AnishLanka/BrainStimulation/boards/Boost/kicad/Pyth_Work/Drill_Report.txt

Drill report for Boost_Electrical_Draft.kicad_pcb
Created on 2026-10-17T14:53:58

Copper Layer Stackup:
    =============================================================
    L1 :  F.Cu                      front
    L2 :  B.Cu                      back

Drill file 'Boost_Electrical_Draft-PTH.drl' contains
    plated through holes:
    =============================================================
    T1  0.300mm  0.0118"  (27 holes))
    T2  1.020mm  0.0402"  (4 holes))
    T3  1.200mm  0.0472"  (2 holes))

    Total plated holes count 33

Drill file 'Boost_Electrical_Draft-NPTH.drl' contains
    unplated through holes:
    =============================================================

    Total unplated holes count 0
