AnishLanka/BrainStimulation/boards/Buck_Boost/kicad/Pyth_Work/SYSTEM_REQUIREMENTS_REVIEW.md

# Effect of the pasted four-channel requirements

The pasted discussion is background and a list of system requirements; its earlier assurances are not evidence that the actual schematics work. Only the buck-boost design has been inspected and revised in this task. No signal-generator, Howland-pump or isolation-board design is approved by these checks.

**Conclusion:** the requirements do not, by themselves, establish a necessary change to the TPS63001 circuit. They also do not establish that this board can power the complete system. Rev B is a corrected prototype 3.3 V supply whose load capability still needs bench verification.

## What this board provides

Rev B converts the specified 2.8–3.7 V battery input to 3.3 V. Its input and output share GND, so it provides no galvanic isolation. The waveform, high-voltage rails, independent channels, output-current/voltage limits, amplitude ramps, phone interface and electrode-disconnect sensing must be implemented elsewhere.

One common 3.3 V supply can feed the input sides of four separate isolation barriers. Each barrier's output domain must stay separate, including its power, control, sensing and external wiring, for channel-to-channel isolation to be retained. This requires review of the actual connected system.

## Required power budget

The original statement that the system needs “more than 200 mA” specifies a minimum expectation, not its actual maximum load. Four electrode outputs at 5 mA each do not imply only 20 mA drawn from the 3.3 V supply.

For the stated simultaneous 30 V peak and 5 mA peak into resistive loads:

- Sinusoidal output power per channel is Vpeak × Ipeak / 2 = 0.075 W; four channels total **0.30 W**.
- Waveforms that remain near maximum magnitude for most of a period can approach **0.60 W** across four channels.
- A 3.3 V, 200 mA rail supplies **0.66 W**. Converter losses, amplifier quiescent power, controller consumption and other loads must be added. These ideal output-power examples are not an estimate of total system consumption.

TI lists up to 800 mA at 3.3 V in boost mode for input above 2.4 V, and 1.2 A in buck mode at 3.6–5.5 V input. These are IC/application capabilities, not measured ratings for Rev B. The 1.8 A figure is a switch-current limit and must not be treated as available output current. Startup into a heavy downstream load also needs testing. See the [TI datasheet](https://www.ti.com/lit/ds/symlink/tps63001.pdf).

To establish adequacy, identify whether one board powers all four channels, the exact downstream converters and their input range, total continuous/peak/inrush current at 3.3 V, and the battery's usable energy. Battery runtime follows usable battery energy divided by measured average battery power; neither one hour nor sixteen hours can be established from electrode current alone.

## Requirement needing a precise interpretation

The 0.1 mA/s change limit is consistent with a limit on the waveform's **amplitude envelope**: increasing from zero to 5 mA takes at least **50 seconds**, and an ordinary controlled ramp down takes the same time. It cannot mean the instantaneous derivative of the AC waveform. For example, a 5 mA-peak, 30 kHz sine has a maximum instantaneous slope of about 942,478 mA/s. Define the amplitude-envelope interpretation explicitly, and specify how fault shutdown differs from a normal user-requested ramp down.

## What is still needed to assess the complete device

The actual signal-generator and Howland schematics/PCBs, exact isolated supplies and their interconnection diagram, intended load/impedance range, output-voltage/current limiting and monitoring circuits, controller interfaces, and the power budget are required. The pasted product descriptions cannot establish component pin connections, analog gain/stability or isolation integrity.

Use the revised supply first with bench equipment and dummy loads. Its clean electrical and manufacturing checks do not validate a human-connected stimulation system.
