AnishLanka/BrainStimulation/boards/Rail_Splitter/kicad/Anish_Work/Drill_Report.txt

Drill report for RailSplitter_Electrical_Draft.kicad_pcb
Created on 2026-10-17T14:51:27

Copper Layer Stackup:
    =============================================================
    L1 :  F.Cu                      front
    L2 :  B.Cu                      back

Drill file 'RailSplitter_Electrical_Draft-PTH.drl' contains
    plated through holes:
    =============================================================
    T1  0.300mm  0.0118"  (12 holes))
    T2  1.300mm  0.0512"  (3 holes))
    T3  1.500mm  0.0591"  (2 holes))

    Total plated holes count 17

Drill file 'RailSplitter_Electrical_Draft-NPTH.drl' contains
    unplated through holes:
    =============================================================

    Total unplated holes count 0
