AnishLanka/BrainStimulation/firmware/ESP32_S3_Brainstim_FW/docs/dds_upgrade.md

# Phase 1 firmware upgrade

The earlier controller-only notes are superseded by [the cross-project Phase 1 implementation and handoff](phase1.md), including sample timing, the versioned status protocol, hardware assumptions and validation results.
