AnishLanka/BrainStimulation/boards/Rail_Splitter/kicad/Anish_Work/RailSplitter_Electrical_Draft.pdf

1 | 2 | 3 | 4 | 5 | 6

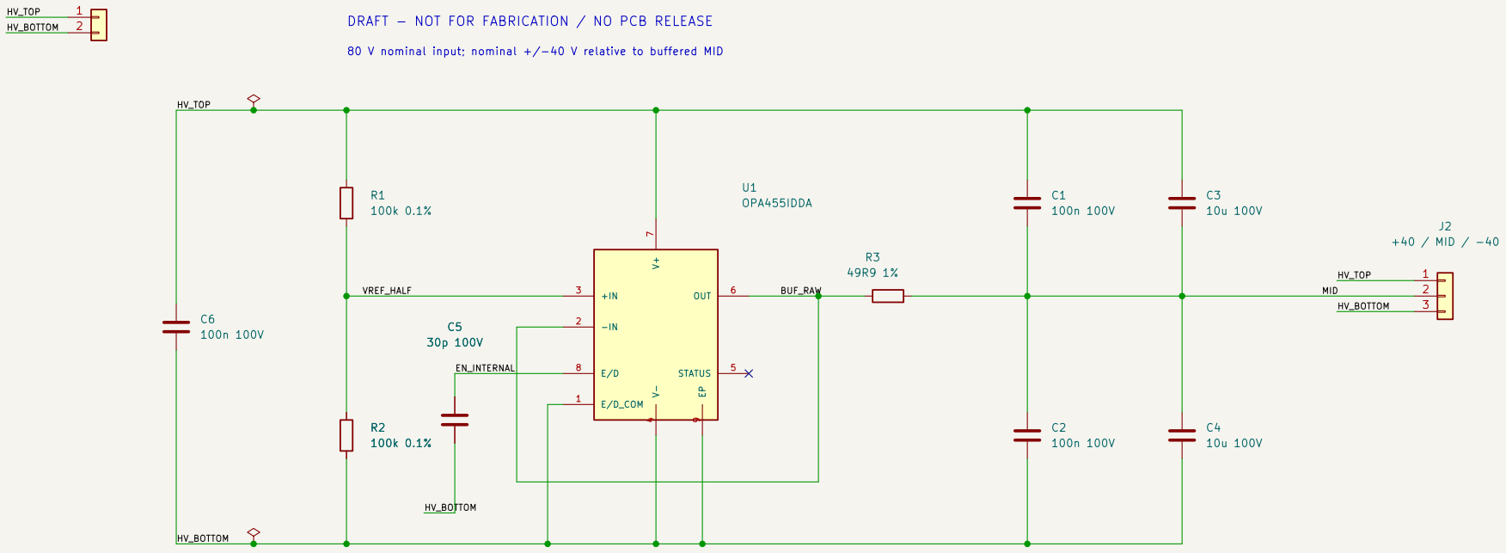
[picture p19: figure]
E/D_COM 1; STATUS; 5 OUT; 9 U1OPA455IDDA C5; J2 +40 / MID / -40 C3 10u 100V; HV_BOTTOM; VREF_HALF HV_TOP; EN_INTERNAL HV_TOP

1 | 2 | 3 | 4 | 5 | 6

AB

C

D

AB

C

## D Date: 2026-10-17

Size: A4 | Rev: DRAFT 1
KiCad E.D.A. 10.0.6 | Id: 1/1

# Title: OPA455 buffered midpoint - electrical draft

## File: RailSplitter_Electrical_Draft.kicad_sch

## Sheet: /

## NOT FOR FABRICATION; stability and system power unvalidated

J1

### 80 V INPUT

BUF_RAW | MIDHV_TOP HV_BOTTOM R1/R2: 16 mW each at 80 V; 32 mW total. Divider tolerance alone: +/-40 mV at MID. Assume one channel, +/-5 mA midpoint imbalance for initial evaluation. This is not a validated load limit.

80 V nominal input; nominal +/-40 V relative to buffered MID

R3 is provisional. Feedback is BEFORE R3. 5 mA DC imbalance causes about 0.25 V midpoint shift. C3/C4 are nominal 10u; verify bias-dependent capacitance.

# OPA455 RAIL SPLITTER - ELECTRICAL DRAFT

## DRAFT - NOT FOR FABRICATION / NO PCB RELEASE

### J1.2 = GAPTEC pin 5 = boost GND = Howland -40 V J2.2 = signal ISO_GND = Howland GND

Do not join MID to HV_BOTTOM. Each channel stays isolated. C5 filters the internal E/D pullup; E/D_COM ties to HV_BOTTOM. STATUS is intentionally unused. EP pin 9 must solder to HV_BOTTOM. C6 must be directly beside U1 supply pins on the eventual PCB. | Required before release: loop/step-load validation, startup and

shutdown, load imbalance and thermal tests, protection, exact BOM, PCB isolation/layout review. ERC success does not validate stability. R2
