AnishLanka/BrainStimulation/boards/Boost/kicad/Pyth_Work/Boost_PCB_Bottom.png

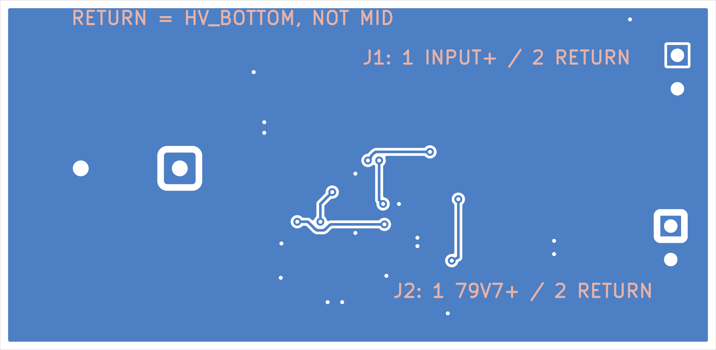
boards/Boost/kicad/Pyth_Work/Boost_PCB_Bottom.png
