AnishLanka/BrainStimulation/boards/Boost/kicad/Pyth_Work/Boost_PCB_Top.png

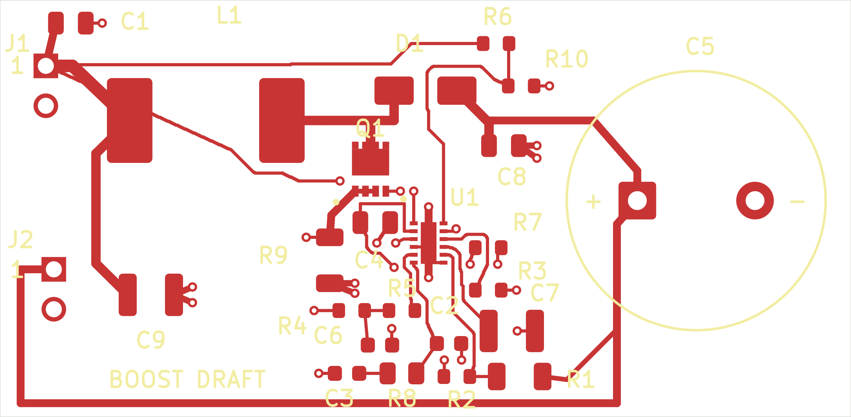
boards/Boost/kicad/Pyth_Work/Boost_PCB_Top.png
