AnishLanka/BrainStimulation/boards/Buck_Boost/kicad/Pyth_Work/previews/bottom-copper.png

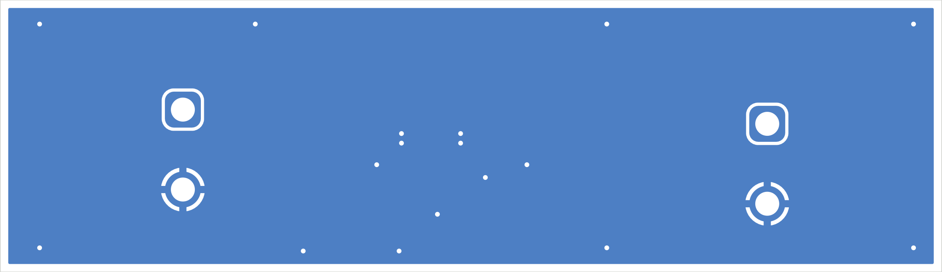
boards/Buck_Boost/kicad/Pyth_Work/previews/bottom-copper.png
