AnishLanka/BrainStimulation/boards/Buck_Boost/kicad/Pyth_Work/previews/BuckBoost_RevB.png

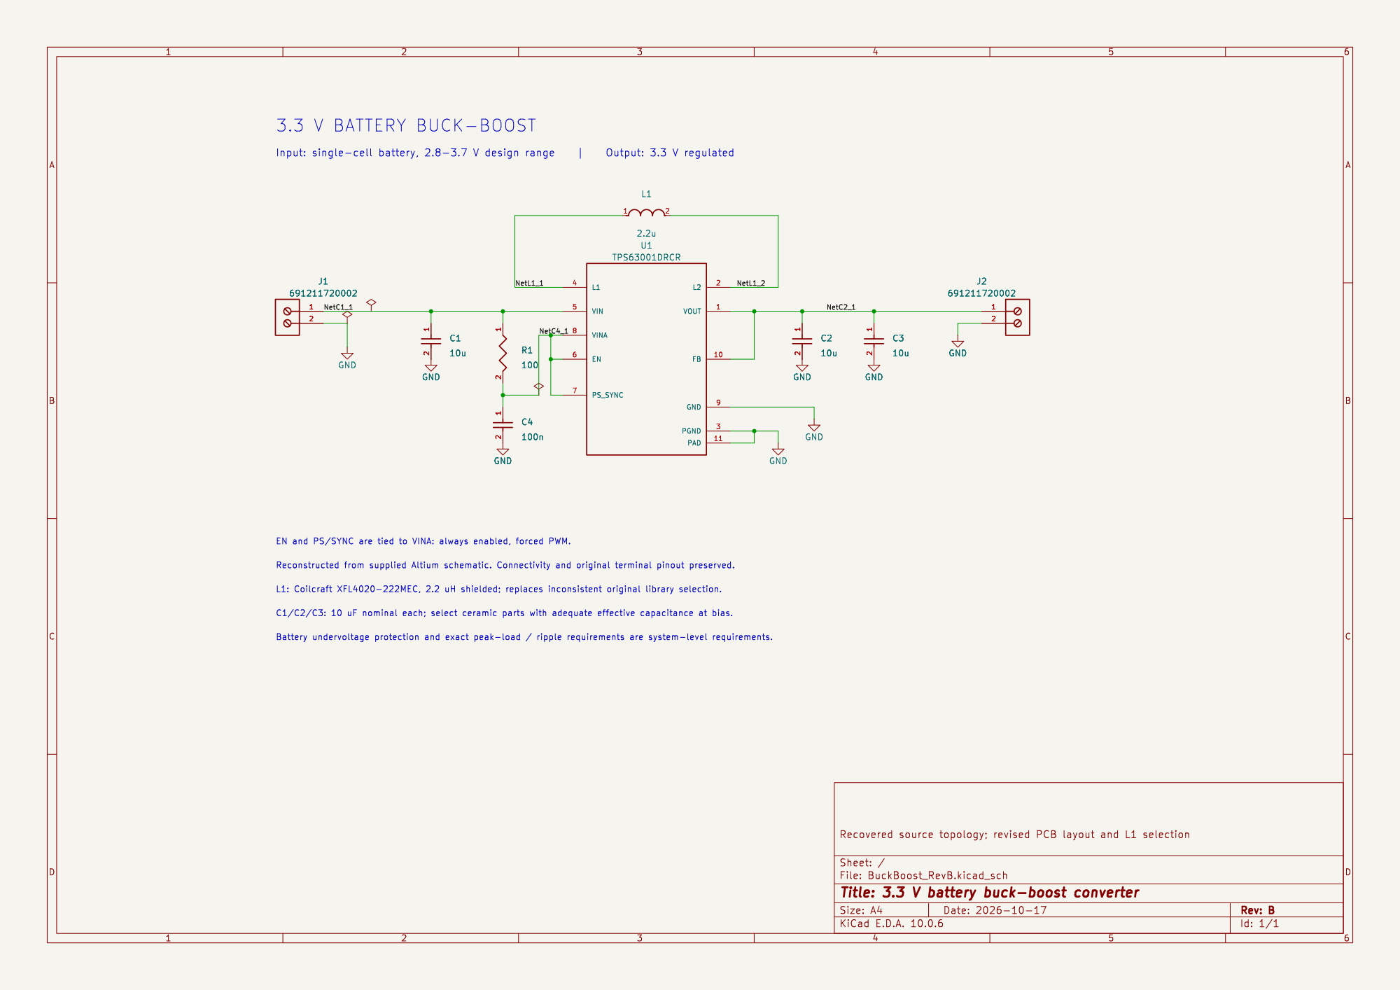
boards/Buck_Boost/kicad/Pyth_Work/previews/BuckBoost_RevB.png
