AnishLanka/BrainStimulation/boards/Buck_Boost/kicad/Pyth_Work/previews/top-copper.png

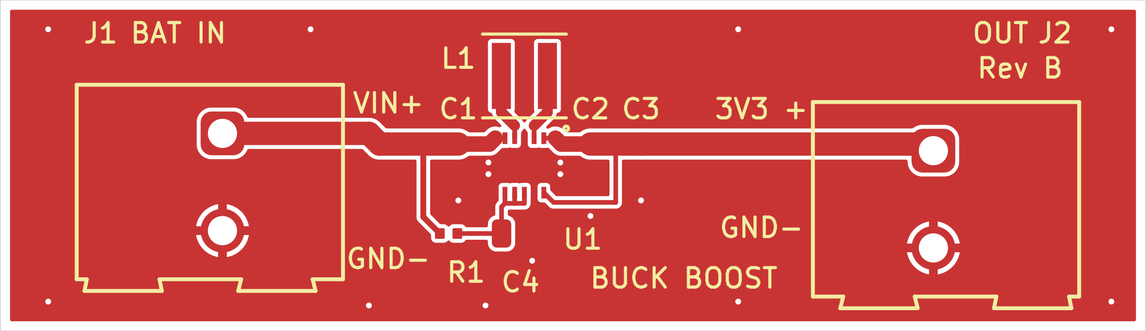
boards/Buck_Boost/kicad/Pyth_Work/previews/top-copper.png
