AnishLanka/BrainStimulation/boards/Rail_Splitter/kicad/Anish_Work/RailSplitter_PCB_Bottom.png

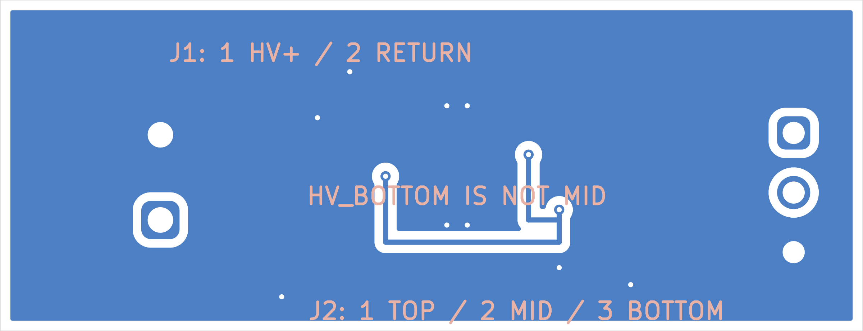
boards/Rail_Splitter/kicad/Anish_Work/RailSplitter_PCB_Bottom.png
