AnishLanka/BrainStimulation/boards/Rail_Splitter/kicad/Anish_Work/RailSplitter_PCB_Top.png

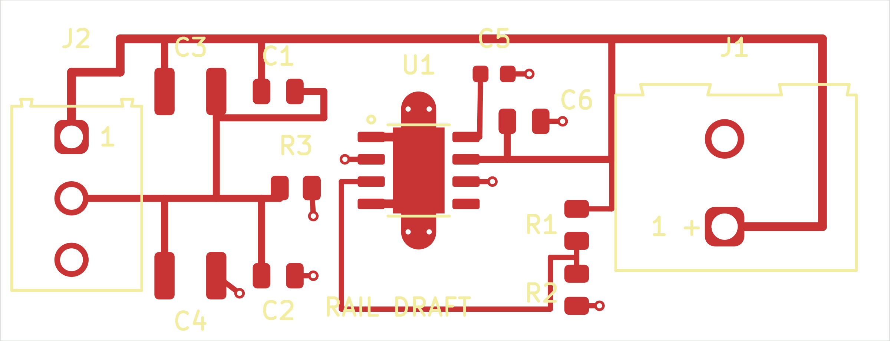
boards/Rail_Splitter/kicad/Anish_Work/RailSplitter_PCB_Top.png
