AnishLanka/BrainStimulation/boards/Shared/Monitor_Power_C1/kicad/Peter_Work/preview/Monitor_Power_C1.png

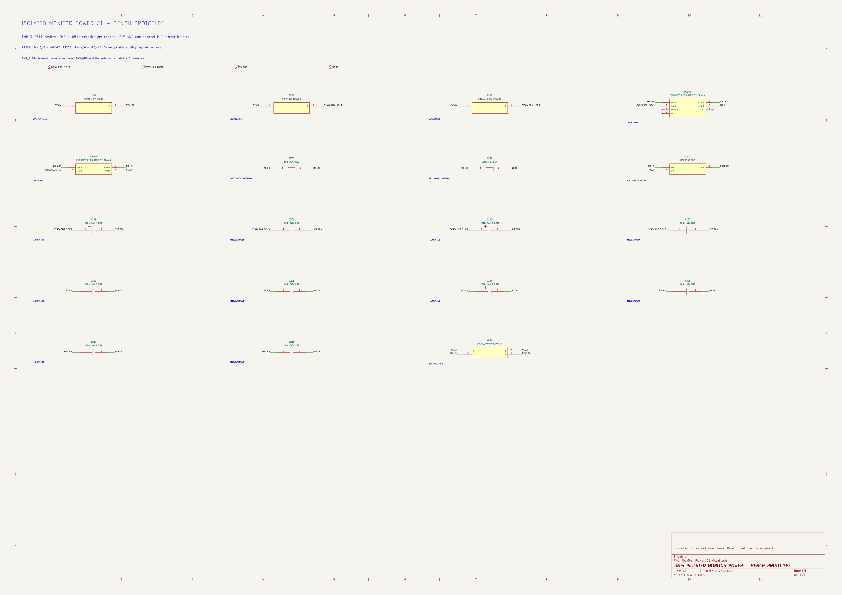
boards/Shared/Monitor_Power_C1/kicad/Peter_Work/preview/Monitor_Power_C1.png
