AnishLanka/BrainStimulation/boards/Shared/Monitor_Power_C1/kicad/Peter_Work/preview/PCB_Bottom.png

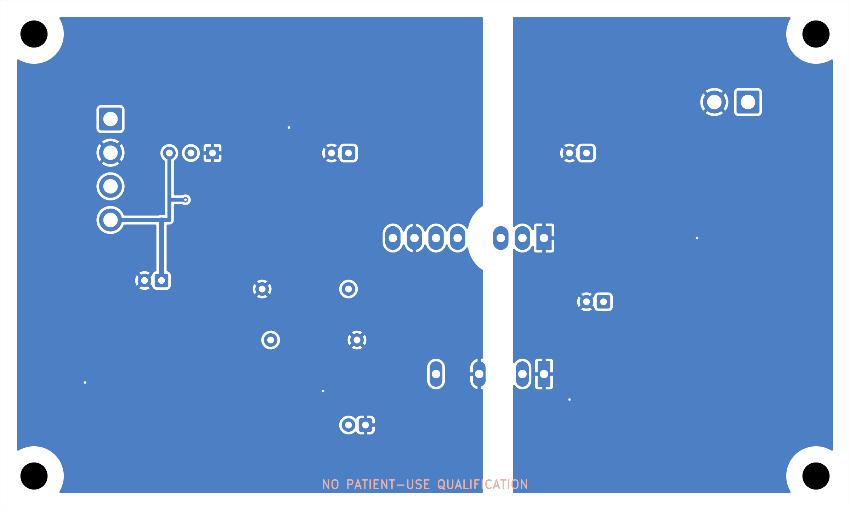
boards/Shared/Monitor_Power_C1/kicad/Peter_Work/preview/PCB_Bottom.png
