AnishLanka/BrainStimulation/boards/Shared/Shared_Power_RevC/kicad/Peter_Work/PCB_Bottom.png

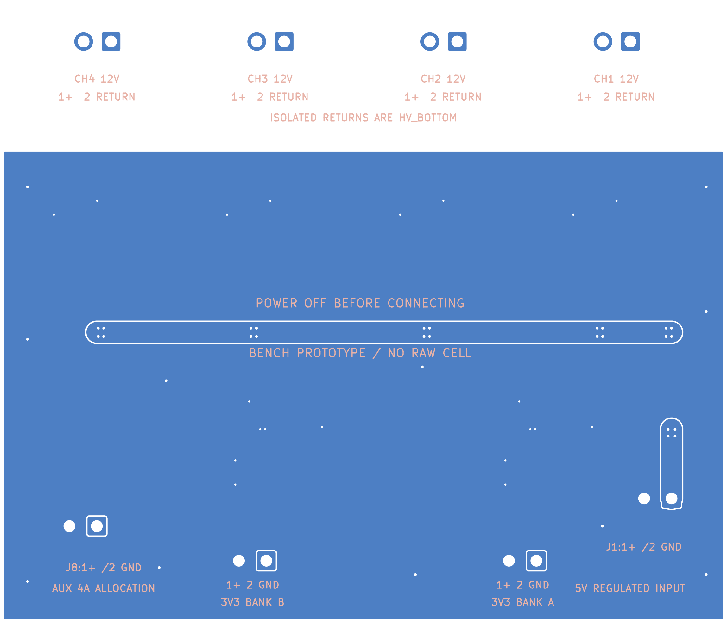
boards/Shared/Shared_Power_RevC/kicad/Peter_Work/PCB_Bottom.png
