AnishLanka/BrainStimulation/boards/Shared/Shared_Power_RevC/kicad/Peter_Work/PCB_Top.png

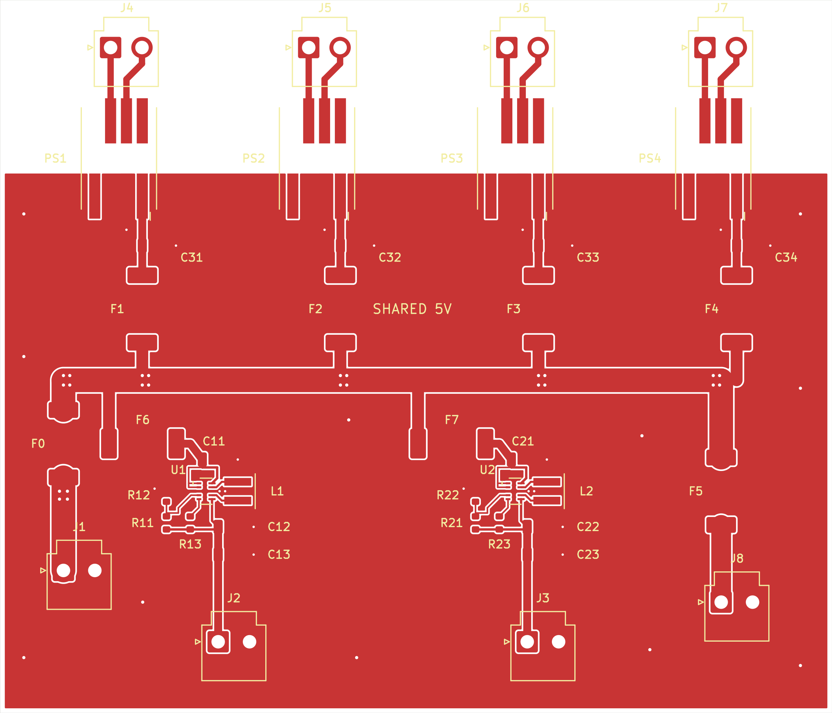
boards/Shared/Shared_Power_RevC/kicad/Peter_Work/PCB_Top.png
