AnishLanka/BrainStimulation/boards/Signal_Generator/kicad/Peter_Work/preview/PCB_back.png

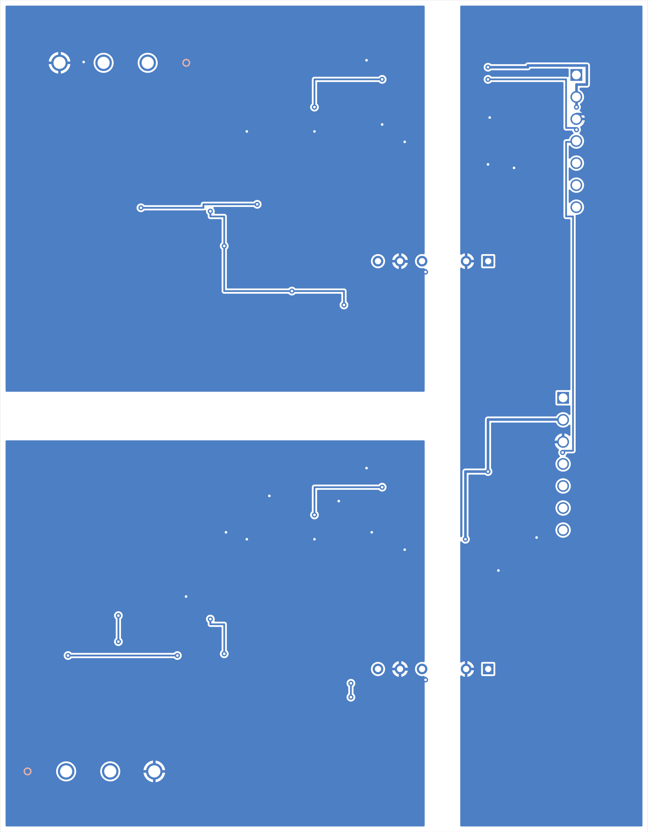
boards/Signal_Generator/kicad/Peter_Work/preview/PCB_back.png
