AnishLanka/BrainStimulation/boards/Signal_Generator/kicad/Peter_Work/preview/PCB_front.png

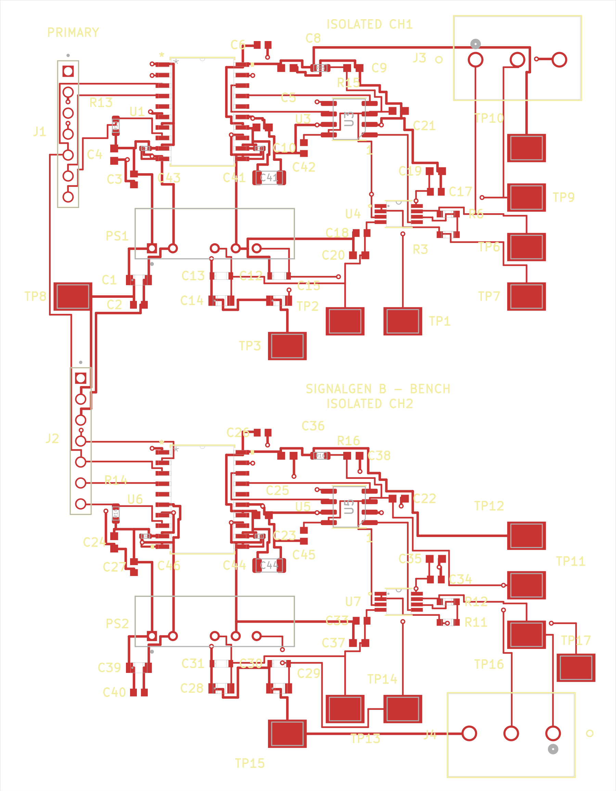
boards/Signal_Generator/kicad/Peter_Work/preview/PCB_front.png
