AnishLanka/BrainStimulation/boards/Signal_Generator/kicad/Peter_Work/preview/SignalGen_Electrical_Draft.png

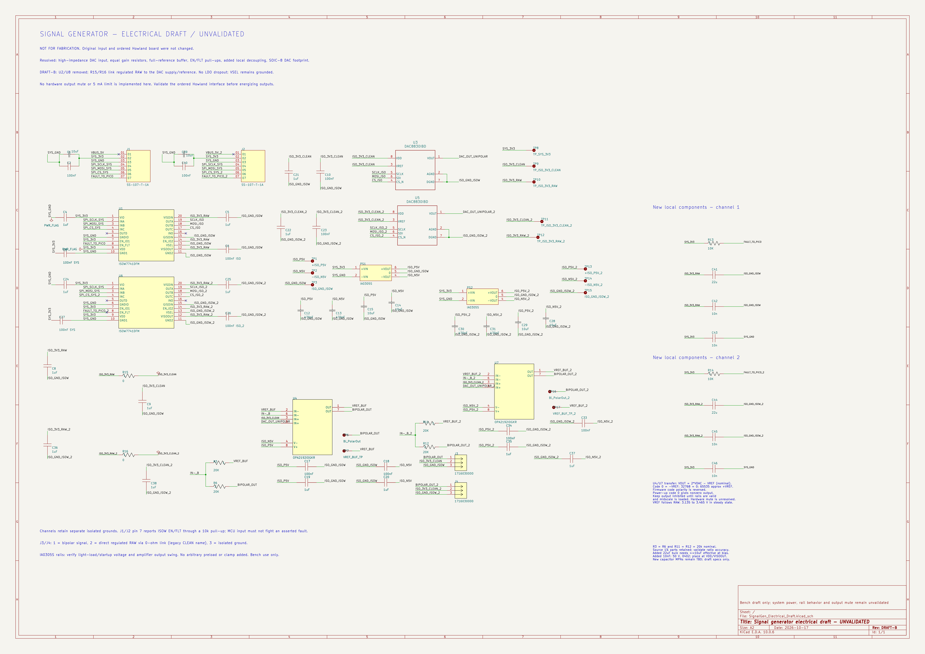
boards/Signal_Generator/kicad/Peter_Work/preview/SignalGen_Electrical_Draft.png
