AnishLanka/BrainStimulation/boards/Boost/Boost_FINAL_ASSEMBLY_BOM.csv

Board | Reference | Function_Name | Value | Footprint | Manufacturer | MPN | Rating | Dielectric | Description | Datasheet | Selection_Status
Boost | R1 | RFBT | 787k 0.1% | BoostDraft:R1206 | Vishay | TNPW1206787KBEEA | 1206; 200V working; at least 0.25W; 0.1%;25ppm/K |  | Upper feedback;78.7V nominal stress;79.7V nominal output | https://www.vishay.com/docs/28758/tnpw_e3.pdf | Retained existing exact MPN; earlier design qualification notes remain applicable
Boost | R2 | RFBB | 10k 0.1% | BoostDraft:R0603 | Vishay | TNPW060310K0BEEA | 0603;100V working;at least0.1W;0.1%;25ppm/K |  | Lower feedback;79.7V nominal setpoint | https://www.vishay.com/docs/28758/tnpw_e3.pdf | Retained existing exact MPN; earlier design qualification notes remain applicable
Boost | C1 | CIN | 10u 50V | BoostDraft:C0805 | TDK | C2012X5R1H106K125AC | 0805;10uF10%;50V;-55 to85C | X5R | Input ceramic; effective4.7uF at16V is a bench acceptance target, not a verified manufacturer minimum | https://product.tdk.com/en/search/capacitor/ceramic/mlcc/info?part_no=C2012X5R1H106K125AC | Retained existing exact MPN; earlier design qualification notes remain applicable
Boost | R3 | RT | 54.9k 1% | BoostDraft:R0603 | Vishay | CRCW060354K9FKEA | 0603;1%;100ppm/K;0.1W;75V |  | Frequency395.67kHz nominal | https://www.vishay.com/docs/20035/dcrcwe3.pdf | Retained existing exact MPN; earlier design qualification notes remain applicable
Boost | Q1 | Q1 | FDMC86240 | BoostDraft:Q_FDMC86240_CASE511DH | onsemi | FDMC86240 | 150V;RDS(on) 70mohm max at VGS 6V; WDFN-8 CASE511DH |  | S1/2/3,G4,D5/6/7/8; verified CASE511DH copper lands; EP common with D | https://www.onsemi.com/download/data-sheet/pdf/fdmc86240-d.pdf | Retained existing exact MPN; earlier design qualification notes remain applicable
Boost | R4 | RFILT | 100R 1% | BoostDraft:R0603 | Vishay | CRCW0603100RFKEA | 0603;1%;100ppm/K;0.1W;75V |  | Current-sense filter;10ns with100pF | https://www.vishay.com/docs/20035/dcrcwe3.pdf | Retained existing exact MPN; earlier design qualification notes remain applicable
Boost | R5 | RSL | 909R 1% | BoostDraft:R0603 | Vishay | CRCW0603909RFKEA | 0603;1%;100ppm/K;0.1W;75V |  | Extra slope compensation; total sense series1009ohm including R4 | https://www.vishay.com/docs/20035/dcrcwe3.pdf | Retained existing exact MPN; earlier design qualification notes remain applicable
Boost | R6 | RUVT | 110k 1% | BoostDraft:R0603 | Vishay | CRCW0603110KFKEA | 0603;1%;100ppm/K;0.1W;75V |  | UVLO upper; startup 9.174V typ, fall 8.318V typ; minimum regulated input remains 10V | https://www.vishay.com/docs/20035/dcrcwe3.pdf | Retained existing exact MPN; earlier design qualification notes remain applicable
Boost | L1 | LM | 1mH SRR1280-102K | BoostDraft:L_BOURNS | Bourns | SRR1280-102K | 1mH10%;DCR1.7ohm max;Irms0.68A;Isat0.80A typ at25%Ldrop |  |  | https://www.bourns.com/docs/Product-Datasheets/SRR1280.pdf | Retained existing exact MPN; earlier design qualification notes remain applicable
Boost | D1 | D1 | SS120 200V | BoostDraft:D_SMA | Taiwan Semiconductor | SS120 | 200 V; 1 A Schottky; DO-214AC (SMA); current manufacturer ordering code SS120, 7500/reel |  |  | https://services.taiwansemi.com/storage/resources/datasheet/SS120_C2305.pdf | Existing SS120 retained; manufacturer C2305 ordering table resolves suffix question
Boost | R7 | RPG | 24.9k 1% | BoostDraft:R0603 | Vishay | CRCW060324K9FKEA | 0603;1%;100ppm/K;0.1W;75V |  | LOCAL PGOOD pullup to VCC_BOOST; not3.3V logic | https://www.vishay.com/docs/20035/dcrcwe3.pdf | Retained existing exact MPN; earlier design qualification notes remain applicable
Boost | C2 | CHF | 68p 50V | BoostDraft:C0603 | TDK | C1608C0G1H680J080AA | 0603;68pF5%;50V | C0G | Provisional compensation HF pole; verify loop | https://product.tdk.com/en/search/capacitor/ceramic/mlcc/info?part_no=C1608C0G1H680J080AA | Retained existing exact MPN; earlier design qualification notes remain applicable
Boost | C3 | CCOMP | 47n 50V | BoostDraft:C0603 | TDK | C1608X7R1H473K080AA | 0603;47nF10%;50V | X7R | Provisional compensation zero; verify loop | https://product.tdk.com/en/search/capacitor/ceramic/mlcc/info?part_no=C1608X7R1H473K080AA | Retained existing exact MPN; earlier design qualification notes remain applicable
Boost | R8 | RCOMP | 191k 1% | BoostDraft:R0805 | Vishay | CRCW0805191KFKEA | 0805;1%;100ppm/K;0.125W;150V |  | Provisional TypeII compensation;500Hz simplified target; unvalidated | https://www.vishay.com/docs/20035/dcrcwe3.pdf | Retained existing exact MPN; earlier design qualification notes remain applicable
Boost | J2 | OUT | 80V OUTPUT | BoostDraft:OUT_FP-TSW-102-14-G-S-MFG | Samtec | TSW-102-14-G-S | 1x2; 2.54 mm pitch; 0.64 mm square posts; 1.02 mm native holes; -14 lead style; gold contact finish |  | Pin 1 HV_TOP; pin 2 HV_BOTTOM. Exact native source header selected. Unpolarized exposed pins: use labeled insulated bench harness and strain relief; matching cable is a separate assembly item. | https://www.samtec.com/products/tsw-102-14-g-s | Placeholder resolved; exact source MPN with native pad and hole compatibility verified
Boost | J1 | IN | 12V INPUT | BoostDraft:IN_FP-TSW-102-14-G-S-MFG | Samtec | TSW-102-14-G-S | 1x2; 2.54 mm pitch; 0.64 mm square posts; 1.02 mm native holes; -14 lead style; gold contact finish |  | Pin 1 ISO_12V_TO_BOTTOM; pin 2 HV_BOTTOM. Exact native source header selected. Unpolarized exposed pins: use labeled insulated bench harness and strain relief; matching cable is a separate assembly item. | https://www.samtec.com/products/tsw-102-14-g-s | Placeholder resolved; exact source MPN with native pad and hole compatibility verified
Boost | R9 | RS | 0R270 1% | BoostDraft:R1206 | Panasonic | ERJ8BQFR27V | 1206;0.270ohm1%;0.5W at70C;derate above70C |  | Thick-film current-sense resistor; Kelvin routing; parasitic inductance not specified; not an output-current clamp | https://industrial.panasonic.com/cdbs/www-data/pdf/RDN0000/AOA0000C313.pdf | Retained existing exact MPN; earlier design qualification notes remain applicable
Boost | C4 | CVCC | 2.2u 25V | BoostDraft:C0805 | TDK | C2012X7R1E225K125AB | 0805;2.2uF10%;25V | X7R | VCC bypass; effective1uF at6.85V is a bench acceptance target, not a verified manufacturer minimum | https://product.tdk.com/en/search/capacitor/ceramic/mlcc/info?part_no=C2012X7R1E225K125AB | Retained existing exact MPN; earlier design qualification notes remain applicable
Boost | C5 | COUT | 100u 160V | BoostDraft:C_BULK | Panasonic | EEUEE2C101S | 100uF20%;160V;105C;D16mm;H20mm;P7.5mm;lead0.8mm | Aluminum electrolytic | Bulk output;10000h105C;1700mArms100kHz105C;maxbody16.5x22mm;verify actual HF ESR | https://industrial.panasonic.com/cdbs/www-data/pdf/RDF0000/RDF0000C1270.pdf | Retained existing exact MPN; earlier design qualification notes remain applicable
Boost | C6 | CFILT | 100p 50V | BoostDraft:C0603 | TDK | C1608C0G1H101J080AA | 0603;100pF5%;50V | C0G | Current-sense filter | https://product.tdk.com/en/search/capacitor/ceramic/mlcc/info?part_no=C1608C0G1H101J080AA | Retained existing exact MPN; earlier design qualification notes remain applicable
Boost | R10 | RUVB | 21.5k 1% | BoostDraft:R0603 | Vishay | CRCW060321K5FKEA | 0603;1%;100ppm/K;0.1W;75V |  | UVLO lower resistor | https://www.vishay.com/docs/20035/dcrcwe3.pdf | Retained existing exact MPN; earlier design qualification notes remain applicable
Boost | C7 | CSS | 47u 16V | BoostDraft:C1210 | Murata | GRM32ER61C476KE15L | 1210;47uF10%;16V;-55 to85C | X5R | Soft-start;effective33uF over0-1V is a bench acceptance target after tolerance,temp,bias,aging | https://search.murata.co.jp/Ceramy/image/img/A01X/G101/ENG/GRM32ER61C476KE15-01A.pdf | Retained existing exact MPN; earlier design qualification notes remain applicable
Boost | U1 | U1 | LM5155DSSR | BoostDraft:U1_DSS0012B | Texas Instruments | LM5155DSSR |  |  | Nonisolated boost controller; all grounds=HV_BOTTOM | https://www.ti.com/lit/ds/symlink/lm5155.pdf | Retained existing exact MPN; earlier design qualification notes remain applicable
Boost | C8 |  | 100n 250V | BoostDraft:C0805 | TDK | C2012X7T2E104K125AA | 0805;100nF10%;250V | X7T (+22/-33% temp) | HF output bypass; effectiveC at79.7V not guaranteed by nominal rating; verify ripple | https://product.tdk.com/en/search/capacitor/ceramic/mlcc/info?part_no=C2012X7T2E104K125AA | Retained existing exact MPN; earlier design qualification notes remain applicable
Boost | C9 |  | 47u 25V | BoostDraft:C1210 | Taiyo Yuden | MSAST32MAB5476MPNDT1 | 1210;47uF20%;25V;-55 to85C | X5R | Input bulk;effective22uF at16V is a bench acceptance target, not a verified manufacturer minimum | https://ds.yuden.co.jp/TYCOMPAS/ut/detail?pn=MSAST32MAB5476MPNDT1&u=M | Retained existing exact MPN; earlier design qualification notes remain applicable
