AnishLanka/BrainStimulation/boards/Rail_Splitter/RailSplitter_FINAL_ASSEMBLY_BOM.csv

Board | Reference | Function_Name | Value | Footprint | Manufacturer | MPN | Rating | Dielectric | Description | Datasheet | Selection_Status
RailSplitter | J1 |  | 80 V INPUT | RailSplitterLocal:J2 | Wurth Elektronik | 691211720002 | 2 positions; 5.00 mm pitch; 1.50 mm recommended holes; 300 VAC; 10 A; 45-degree wire entry |  | Pin 1 HV_TOP; pin 2 HV_BOTTOM. Exact source connector retained. Screw clamp takes stripped wire; no separate mating plug required. Support thin PCB while tightening. | https://www.we-online.com/components/products/datasheet/691211720002.pdf | Placeholder resolved; value, rating and native footprint compatibility checked against manufacturer documentation
RailSplitter | U1 |  | OPA455IDDA | RailSplitterLocal:OPA455_DDA0008J | Texas Instruments | OPA455IDDA |  |  | Unity-gain midpoint buffer; exposed pad9=HV_BOTTOM | https://www.ti.com/lit/ds/symlink/opa455.pdf | Retained existing exact MPN; earlier design qualification notes remain applicable
RailSplitter | R1 |  | 100k 0.1% | RailSplitterLocal:R0805 | Vishay | TNPW0805100KBEEA | 100 kohm; +/-0.1%; +/-25 ppm/K; 0805; 150 V; use conservative 0.125 W limit |  | Midpoint divider. Same part and preferably same production lot for both positions; individual tolerance does not guarantee matched TCR tracking. | https://www.vishay.com/docs/28758/tnpw_e3.pdf | Placeholder resolved; value, rating and native footprint compatibility checked against manufacturer documentation
RailSplitter | R2 |  | 100k 0.1% | RailSplitterLocal:R0805 | Vishay | TNPW0805100KBEEA | 100 kohm; +/-0.1%; +/-25 ppm/K; 0805; 150 V; use conservative 0.125 W limit |  | Midpoint divider. Same part and preferably same production lot for both positions; individual tolerance does not guarantee matched TCR tracking. | https://www.vishay.com/docs/28758/tnpw_e3.pdf | Placeholder resolved; value, rating and native footprint compatibility checked against manufacturer documentation
RailSplitter | R3 |  | 49R9 1% | RailSplitterLocal:R0805 | Vishay | CRCW080549R9FKEA | 49.9 ohm; +/-1%; +/-100 ppm/K; 0805; 0.125 W standard operation; 150 V |  | Existing output isolation resistor; feedback remains before resistor. Load stability and dissipation require bench verification. | https://www.vishay.com/docs/20035/dcrcwe3.pdf | Placeholder resolved; value, rating and native footprint compatibility checked against manufacturer documentation
RailSplitter | C1 |  | 100n 100V | RailSplitterLocal:C0805 | TDK | C2012X7R2A104K125AA |  | X7R | C6 direct full-bus local bypass; C1/C2 half-rail bypasses |  | Retained existing exact MPN; earlier design qualification notes remain applicable
RailSplitter | C2 |  | 100n 100V | RailSplitterLocal:C0805 | TDK | C2012X7R2A104K125AA |  | X7R | C6 direct full-bus local bypass; C1/C2 half-rail bypasses |  | Retained existing exact MPN; earlier design qualification notes remain applicable
RailSplitter | C6 |  | 100n 100V | RailSplitterLocal:C0805 | TDK | C2012X7R2A104K125AA |  | X7R | C6 direct full-bus local bypass; C1/C2 half-rail bypasses |  | Retained existing exact MPN; earlier design qualification notes remain applicable
RailSplitter | C3 |  | 10u 100V | RailSplitterLocal:C1210 | Murata | GRM32EC72A106KE05K |  | X7S | Nominal value only; DC bias reduces capacitance; verify effective C and availability before release | https://search.murata.co.jp/Ceramy/image/img/A01X/G101/ENG/GRM32EC72A106KE05-01A.pdf | Retained existing exact MPN; earlier design qualification notes remain applicable
RailSplitter | C4 |  | 10u 100V | RailSplitterLocal:C1210 | Murata | GRM32EC72A106KE05K |  | X7S | Nominal value only; DC bias reduces capacitance; verify effective C and availability before release | https://search.murata.co.jp/Ceramy/image/img/A01X/G101/ENG/GRM32EC72A106KE05-01A.pdf | Retained existing exact MPN; earlier design qualification notes remain applicable
RailSplitter | C5 |  | 30p 100V | RailSplitterLocal:C0603 | KEMET | C0603C300J1GACTU | 30 pF; +/-5%; 100 VDC; 0603; -55 to +125 C | C0G | Existing E/D filter; exact 0603 30 pF 100 V selection. No electrical change. | https://content.kemet.com/datasheets/KEM_C1003_C0G_SMD.pdf | Placeholder resolved; value, rating and native footprint compatibility checked against manufacturer documentation
RailSplitter | J2 |  | +40 / MID / -40 | RailSplitterLocal:J3 | Wurth Elektronik | 691214110003 | 3 positions; 3.50 mm pitch; 1.30 mm recommended holes; 300 VAC; 10 A; horizontal wire entry |  | Pin 1 HV_TOP; pin 2 MID; pin 3 HV_BOTTOM. Exact source connector retained. Screw clamp takes stripped wire; no separate mating plug required. Support thin PCB while tightening. | https://www.we-online.com/components/products/datasheet/691214110003.pdf | Placeholder resolved; value, rating and native footprint compatibility checked against manufacturer documentation
