AnishLanka/BrainStimulation/boards/Shared/Channel_Monitor_C1/kicad/Peter_Work/Assembly_BOM.csv

Reference | Value | MPN | Manufacturer | Footprint | Population | Notes | Primary_sources
U1 | OPA2192 | OPA2192ID |  | Package_SO:SOIC-8_3.9x4.9mm_P1.27mm | Fit | Dual regulated +/-5 V supply. A buffers protected load return; B buffers half-reference. Input protection is specified for bounded +/-80 V fault injection, not arbitrary surges.
U2 | OPA2192 | OPA2192ID |  | Package_SO:SOIC-8_3.9x4.9mm_P1.27mm | Fit | Single 5 V supply. A current difference gain3.24; B voltage difference gain1/20.
U3 | REF5040A | REF5040AID |  | Package_SO:SOIC-8_3.9x4.9mm_P1.27mm | Fit | Standard grade0.1%,8ppm/C. Pins1/8DNC;3TEMP unused;7NC.
U4 | TLV1704 | TLV1704IPWR |  | Package_SO:TSSOP-14_4.4x5mm_P0.65mm | Fit | All four open-collector outputs wired together. Each comparator is high-impedance in its acceptable window.
U5 | SN74LVC1G74 | SN74LVC1G74DCUR |  | Package_SO:VSSOP-8_2.3x2mm_P0.5mm | Fit | Pin 5 Q, pin 3 inverted Q. D samples qualified near-zero command at rising ARM_EDGE only. Conditioned asynchronous clear is FAULT_CLEAR_N. Hold ARM low through faults; allow at least 1 us after clear recovery before a new rising edge. No automatic rearm.
U6 | TPS3808G33 | TPS3808G33DBVR |  | Package_TO_SOT_SMD:SOT-23-6 | Fit | 3.3V supervisor3.07Vnom; CTopen20msreset release.
U7 | TPS3808G50 | TPS3808G50DBVR |  | Package_TO_SOT_SMD:SOT-23-6 | Fit | Monitors+5V at4.65Vnom; powered3.3V. CTopen20ms.
U8 | TLV1702 | TLV1702IDGKR |  | Package_SO:VSSOP-8_3x3mm_P0.65mm | Fit | Negative rail window approximate-5.503V to-4.671V. Precision tolerances/offset must be included in regulator choice.
U9 | TPS3808G01 | TPS3808G01DBVR |  | Package_TO_SOT_SMD:SOT-23-6 | Fit | Reference undervoltage nominal3.997V; CTopen20ms. Does not detect reference overvoltage.
U10 | TPS3431 | TPS3431SDRBR |  | Package_DFN_QFN:Texas_DRB0008A | Fit | WDO and ENOUT wired together. SET1high,CWD10ktoVDD ->170/200/230ms. EPpin9 is schematic convention; verify package pad geometry.
R1 | 100R 0.1% | TNPW1206100RBEEA | Vishay | Resistor_SMD:R_1206_3216Metric | Fit | Manufacturer resistance code uses R/K/M decimal notation; B=0.1%, E=25 ppm/K, EA=tape packaging. Electrical value and footprint unchanged. TNPW0805 0.1%/25 ppm range includes 499 kohm (up to 1 Mohm). | https://www.vishay.com/docs/28758/tnpw_e3.pdf
R2 | 20k | TNPW080520K0BEEA | Vishay | Resistor_SMD:R_0805_2012Metric | Fit | Manufacturer resistance code uses R/K/M decimal notation; B=0.1%, E=25 ppm/K, EA=tape packaging. Electrical value and footprint unchanged. TNPW0805 0.1%/25 ppm range includes 499 kohm (up to 1 Mohm). | https://www.vishay.com/docs/28758/tnpw_e3.pdf
R3 | 20k | TNPW080520K0BEEA | Vishay | Resistor_SMD:R_0805_2012Metric | Fit | Manufacturer resistance code uses R/K/M decimal notation; B=0.1%, E=25 ppm/K, EA=tape packaging. Electrical value and footprint unchanged. TNPW0805 0.1%/25 ppm range includes 499 kohm (up to 1 Mohm). | https://www.vishay.com/docs/28758/tnpw_e3.pdf
R4 | 10k | TNPW080510K0BEEA | Vishay | Resistor_SMD:R_0805_2012Metric | Fit | Manufacturer resistance code uses R/K/M decimal notation; B=0.1%, E=25 ppm/K, EA=tape packaging. Electrical value and footprint unchanged. TNPW0805 0.1%/25 ppm range includes 499 kohm (up to 1 Mohm). | https://www.vishay.com/docs/28758/tnpw_e3.pdf
R5 | 32.4k | TNPW080532K4BEEA | Vishay | Resistor_SMD:R_0805_2012Metric | Fit | Manufacturer resistance code uses R/K/M decimal notation; B=0.1%, E=25 ppm/K, EA=tape packaging. Electrical value and footprint unchanged. TNPW0805 0.1%/25 ppm range includes 499 kohm (up to 1 Mohm). | https://www.vishay.com/docs/28758/tnpw_e3.pdf
R6 | 10k | TNPW080510K0BEEA | Vishay | Resistor_SMD:R_0805_2012Metric | Fit | Manufacturer resistance code uses R/K/M decimal notation; B=0.1%, E=25 ppm/K, EA=tape packaging. Electrical value and footprint unchanged. TNPW0805 0.1%/25 ppm range includes 499 kohm (up to 1 Mohm). | https://www.vishay.com/docs/28758/tnpw_e3.pdf
R7 | 32.4k | TNPW080532K4BEEA | Vishay | Resistor_SMD:R_0805_2012Metric | Fit | Manufacturer resistance code uses R/K/M decimal notation; B=0.1%, E=25 ppm/K, EA=tape packaging. Electrical value and footprint unchanged. TNPW0805 0.1%/25 ppm range includes 499 kohm (up to 1 Mohm). | https://www.vishay.com/docs/28758/tnpw_e3.pdf
R8 | 499k | TNPW0805499KBEEA | Vishay | Resistor_SMD:R_0805_2012Metric | Fit | Manufacturer resistance code uses R/K/M decimal notation; B=0.1%, E=25 ppm/K, EA=tape packaging. Electrical value and footprint unchanged. TNPW0805 0.1%/25 ppm range includes 499 kohm (up to 1 Mohm). | https://www.vishay.com/docs/28758/tnpw_e3.pdf
R9 | 499k | TNPW0805499KBEEA | Vishay | Resistor_SMD:R_0805_2012Metric | Fit | Manufacturer resistance code uses R/K/M decimal notation; B=0.1%, E=25 ppm/K, EA=tape packaging. Electrical value and footprint unchanged. TNPW0805 0.1%/25 ppm range includes 499 kohm (up to 1 Mohm). | https://www.vishay.com/docs/28758/tnpw_e3.pdf
R10 | 49.9k | TNPW080549K9BEEA | Vishay | Resistor_SMD:R_0805_2012Metric | Fit | Manufacturer resistance code uses R/K/M decimal notation; B=0.1%, E=25 ppm/K, EA=tape packaging. Electrical value and footprint unchanged. TNPW0805 0.1%/25 ppm range includes 499 kohm (up to 1 Mohm). | https://www.vishay.com/docs/28758/tnpw_e3.pdf
R11 | 499k | TNPW0805499KBEEA | Vishay | Resistor_SMD:R_0805_2012Metric | Fit | Manufacturer resistance code uses R/K/M decimal notation; B=0.1%, E=25 ppm/K, EA=tape packaging. Electrical value and footprint unchanged. TNPW0805 0.1%/25 ppm range includes 499 kohm (up to 1 Mohm). | https://www.vishay.com/docs/28758/tnpw_e3.pdf
R12 | 499k | TNPW0805499KBEEA | Vishay | Resistor_SMD:R_0805_2012Metric | Fit | Manufacturer resistance code uses R/K/M decimal notation; B=0.1%, E=25 ppm/K, EA=tape packaging. Electrical value and footprint unchanged. TNPW0805 0.1%/25 ppm range includes 499 kohm (up to 1 Mohm). | https://www.vishay.com/docs/28758/tnpw_e3.pdf
R13 | 49.9k | TNPW080549K9BEEA | Vishay | Resistor_SMD:R_0805_2012Metric | Fit | Manufacturer resistance code uses R/K/M decimal notation; B=0.1%, E=25 ppm/K, EA=tape packaging. Electrical value and footprint unchanged. TNPW0805 0.1%/25 ppm range includes 499 kohm (up to 1 Mohm). | https://www.vishay.com/docs/28758/tnpw_e3.pdf
R14 | 5.11k | TNPW08055K11BEEA | Vishay | Resistor_SMD:R_0805_2012Metric | Fit | Manufacturer resistance code uses R/K/M decimal notation; B=0.1%, E=25 ppm/K, EA=tape packaging. Electrical value and footprint unchanged. TNPW0805 0.1%/25 ppm range includes 499 kohm (up to 1 Mohm). | https://www.vishay.com/docs/28758/tnpw_e3.pdf
R15 | 93.1k | TNPW080593K1BEEA | Vishay | Resistor_SMD:R_0805_2012Metric | Fit | Manufacturer resistance code uses R/K/M decimal notation; B=0.1%, E=25 ppm/K, EA=tape packaging. Electrical value and footprint unchanged. TNPW0805 0.1%/25 ppm range includes 499 kohm (up to 1 Mohm). | https://www.vishay.com/docs/28758/tnpw_e3.pdf
R16 | 5.11k | TNPW08055K11BEEA | Vishay | Resistor_SMD:R_0805_2012Metric | Fit | Manufacturer resistance code uses R/K/M decimal notation; B=0.1%, E=25 ppm/K, EA=tape packaging. Electrical value and footprint unchanged. TNPW0805 0.1%/25 ppm range includes 499 kohm (up to 1 Mohm). | https://www.vishay.com/docs/28758/tnpw_e3.pdf
R17 | 15.6k | TNPW080515K6BEEA | Vishay | Resistor_SMD:R_0805_2012Metric | Fit | Manufacturer resistance code uses R/K/M decimal notation; B=0.1%, E=25 ppm/K, EA=tape packaging. Electrical value and footprint unchanged. TNPW0805 0.1%/25 ppm range includes 499 kohm (up to 1 Mohm). | https://www.vishay.com/docs/28758/tnpw_e3.pdf
R18 | 71.5k | TNPW080571K5BEEA | Vishay | Resistor_SMD:R_0805_2012Metric | Fit | Manufacturer resistance code uses R/K/M decimal notation; B=0.1%, E=25 ppm/K, EA=tape packaging. Electrical value and footprint unchanged. TNPW0805 0.1%/25 ppm range includes 499 kohm (up to 1 Mohm). | https://www.vishay.com/docs/28758/tnpw_e3.pdf
R19 | 15.6k | TNPW080515K6BEEA | Vishay | Resistor_SMD:R_0805_2012Metric | Fit | Manufacturer resistance code uses R/K/M decimal notation; B=0.1%, E=25 ppm/K, EA=tape packaging. Electrical value and footprint unchanged. TNPW0805 0.1%/25 ppm range includes 499 kohm (up to 1 Mohm). | https://www.vishay.com/docs/28758/tnpw_e3.pdf
R20 | 10k | TNPW080510K0BEEA | Vishay | Resistor_SMD:R_0805_2012Metric | Fit | Manufacturer resistance code uses R/K/M decimal notation; B=0.1%, E=25 ppm/K, EA=tape packaging. Electrical value and footprint unchanged. TNPW0805 0.1%/25 ppm range includes 499 kohm (up to 1 Mohm). | https://www.vishay.com/docs/28758/tnpw_e3.pdf
R21 | 10k | TNPW080510K0BEEA | Vishay | Resistor_SMD:R_0805_2012Metric | Fit | Manufacturer resistance code uses R/K/M decimal notation; B=0.1%, E=25 ppm/K, EA=tape packaging. Electrical value and footprint unchanged. TNPW0805 0.1%/25 ppm range includes 499 kohm (up to 1 Mohm). | https://www.vishay.com/docs/28758/tnpw_e3.pdf
R22 | 10k | TNPW080510K0BEEA | Vishay | Resistor_SMD:R_0805_2012Metric | Fit | Manufacturer resistance code uses R/K/M decimal notation; B=0.1%, E=25 ppm/K, EA=tape packaging. Electrical value and footprint unchanged. TNPW0805 0.1%/25 ppm range includes 499 kohm (up to 1 Mohm). | https://www.vishay.com/docs/28758/tnpw_e3.pdf
R23 | 10k | TNPW080510K0BEEA | Vishay | Resistor_SMD:R_0805_2012Metric | Fit | Manufacturer resistance code uses R/K/M decimal notation; B=0.1%, E=25 ppm/K, EA=tape packaging. Electrical value and footprint unchanged. TNPW0805 0.1%/25 ppm range includes 499 kohm (up to 1 Mohm). | https://www.vishay.com/docs/28758/tnpw_e3.pdf
R24 | 10k | TNPW080510K0BEEA | Vishay | Resistor_SMD:R_0805_2012Metric | Fit | Manufacturer resistance code uses R/K/M decimal notation; B=0.1%, E=25 ppm/K, EA=tape packaging. Electrical value and footprint unchanged. TNPW0805 0.1%/25 ppm range includes 499 kohm (up to 1 Mohm). | https://www.vishay.com/docs/28758/tnpw_e3.pdf
R25 | 1k | TNPW08051K00BEEA | Vishay | Resistor_SMD:R_0805_2012Metric | Fit | Manufacturer resistance code uses R/K/M decimal notation; B=0.1%, E=25 ppm/K, EA=tape packaging. Electrical value and footprint unchanged. TNPW0805 0.1%/25 ppm range includes 499 kohm (up to 1 Mohm). | https://www.vishay.com/docs/28758/tnpw_e3.pdf
R26 | 10k | TNPW080510K0BEEA | Vishay | Resistor_SMD:R_0805_2012Metric | Fit | Manufacturer resistance code uses R/K/M decimal notation; B=0.1%, E=25 ppm/K, EA=tape packaging. Electrical value and footprint unchanged. TNPW0805 0.1%/25 ppm range includes 499 kohm (up to 1 Mohm). | https://www.vishay.com/docs/28758/tnpw_e3.pdf
R27 | 100k | TNPW0805100KBEEA | Vishay | Resistor_SMD:R_0805_2012Metric | Fit | Manufacturer resistance code uses R/K/M decimal notation; B=0.1%, E=25 ppm/K, EA=tape packaging. Electrical value and footprint unchanged. TNPW0805 0.1%/25 ppm range includes 499 kohm (up to 1 Mohm). | https://www.vishay.com/docs/28758/tnpw_e3.pdf
R28 | 200k | TNPW0805200KBEEA | Vishay | Resistor_SMD:R_0805_2012Metric | Fit | Manufacturer resistance code uses R/K/M decimal notation; B=0.1%, E=25 ppm/K, EA=tape packaging. Electrical value and footprint unchanged. TNPW0805 0.1%/25 ppm range includes 499 kohm (up to 1 Mohm). | https://www.vishay.com/docs/28758/tnpw_e3.pdf
R29 | 24.9k | TNPW080524K9BEEA | Vishay | Resistor_SMD:R_0805_2012Metric | Fit | Manufacturer resistance code uses R/K/M decimal notation; B=0.1%, E=25 ppm/K, EA=tape packaging. Electrical value and footprint unchanged. TNPW0805 0.1%/25 ppm range includes 499 kohm (up to 1 Mohm). | https://www.vishay.com/docs/28758/tnpw_e3.pdf
R30 | 10k | TNPW080510K0BEEA | Vishay | Resistor_SMD:R_0805_2012Metric | Fit | Manufacturer resistance code uses R/K/M decimal notation; B=0.1%, E=25 ppm/K, EA=tape packaging. Electrical value and footprint unchanged. TNPW0805 0.1%/25 ppm range includes 499 kohm (up to 1 Mohm). | https://www.vishay.com/docs/28758/tnpw_e3.pdf
R31 | 35.7k | TNPW080535K7BEEA | Vishay | Resistor_SMD:R_0805_2012Metric | Fit | Manufacturer resistance code uses R/K/M decimal notation; B=0.1%, E=25 ppm/K, EA=tape packaging. Electrical value and footprint unchanged. TNPW0805 0.1%/25 ppm range includes 499 kohm (up to 1 Mohm). | https://www.vishay.com/docs/28758/tnpw_e3.pdf
R32 | 10k | TNPW080510K0BEEA | Vishay | Resistor_SMD:R_0805_2012Metric | Fit | Manufacturer resistance code uses R/K/M decimal notation; B=0.1%, E=25 ppm/K, EA=tape packaging. Electrical value and footprint unchanged. TNPW0805 0.1%/25 ppm range includes 499 kohm (up to 1 Mohm). | https://www.vishay.com/docs/28758/tnpw_e3.pdf
R33 | 88.7k | TNPW080588K7BEEA | Vishay | Resistor_SMD:R_0805_2012Metric | Fit | Manufacturer resistance code uses R/K/M decimal notation; B=0.1%, E=25 ppm/K, EA=tape packaging. Electrical value and footprint unchanged. TNPW0805 0.1%/25 ppm range includes 499 kohm (up to 1 Mohm). | https://www.vishay.com/docs/28758/tnpw_e3.pdf
R34 | 10k | TNPW080510K0BEEA | Vishay | Resistor_SMD:R_0805_2012Metric | Fit | Manufacturer resistance code uses R/K/M decimal notation; B=0.1%, E=25 ppm/K, EA=tape packaging. Electrical value and footprint unchanged. TNPW0805 0.1%/25 ppm range includes 499 kohm (up to 1 Mohm). | https://www.vishay.com/docs/28758/tnpw_e3.pdf
R35 | 10k | TNPW080510K0BEEA | Vishay | Resistor_SMD:R_0805_2012Metric | Fit | Manufacturer resistance code uses R/K/M decimal notation; B=0.1%, E=25 ppm/K, EA=tape packaging. Electrical value and footprint unchanged. TNPW0805 0.1%/25 ppm range includes 499 kohm (up to 1 Mohm). | https://www.vishay.com/docs/28758/tnpw_e3.pdf
C1 | 100n | 885012207098 | Wurth Elektronik | Capacitor_SMD:C_0805_2012Metric | Fit | 100 nF, +/-10%, 50 V, X7R, 0805 (2.0 x 1.25 mm). Nominal rating does not constitute a guaranteed biased capacitance. | https://www.we-online.com/components/products/datasheet/885012207098.pdf
C2 | 100n | 885012207098 | Wurth Elektronik | Capacitor_SMD:C_0805_2012Metric | Fit | 100 nF, +/-10%, 50 V, X7R, 0805 (2.0 x 1.25 mm). Nominal rating does not constitute a guaranteed biased capacitance. | https://www.we-online.com/components/products/datasheet/885012207098.pdf
C3 | 100n | 885012207098 | Wurth Elektronik | Capacitor_SMD:C_0805_2012Metric | Fit | 100 nF, +/-10%, 50 V, X7R, 0805 (2.0 x 1.25 mm). Nominal rating does not constitute a guaranteed biased capacitance. | https://www.we-online.com/components/products/datasheet/885012207098.pdf
C4 | 100n | 885012207098 | Wurth Elektronik | Capacitor_SMD:C_0805_2012Metric | Fit | 100 nF, +/-10%, 50 V, X7R, 0805 (2.0 x 1.25 mm). Nominal rating does not constitute a guaranteed biased capacitance. | https://www.we-online.com/components/products/datasheet/885012207098.pdf
C5 | 100n | 885012207098 | Wurth Elektronik | Capacitor_SMD:C_0805_2012Metric | Fit | 100 nF, +/-10%, 50 V, X7R, 0805 (2.0 x 1.25 mm). Nominal rating does not constitute a guaranteed biased capacitance. | https://www.we-online.com/components/products/datasheet/885012207098.pdf
C6 | 100n | 885012207098 | Wurth Elektronik | Capacitor_SMD:C_0805_2012Metric | Fit | 100 nF, +/-10%, 50 V, X7R, 0805 (2.0 x 1.25 mm). Nominal rating does not constitute a guaranteed biased capacitance. | https://www.we-online.com/components/products/datasheet/885012207098.pdf
C7 | 100n | 885012207098 | Wurth Elektronik | Capacitor_SMD:C_0805_2012Metric | Fit | 100 nF, +/-10%, 50 V, X7R, 0805 (2.0 x 1.25 mm). Nominal rating does not constitute a guaranteed biased capacitance. | https://www.we-online.com/components/products/datasheet/885012207098.pdf
C8 | 100n | 885012207098 | Wurth Elektronik | Capacitor_SMD:C_0805_2012Metric | Fit | 100 nF, +/-10%, 50 V, X7R, 0805 (2.0 x 1.25 mm). Nominal rating does not constitute a guaranteed biased capacitance. | https://www.we-online.com/components/products/datasheet/885012207098.pdf
C9 | 100n | 885012207098 | Wurth Elektronik | Capacitor_SMD:C_0805_2012Metric | Fit | 100 nF, +/-10%, 50 V, X7R, 0805 (2.0 x 1.25 mm). Nominal rating does not constitute a guaranteed biased capacitance. | https://www.we-online.com/components/products/datasheet/885012207098.pdf
C10 | 100n | 885012207098 | Wurth Elektronik | Capacitor_SMD:C_0805_2012Metric | Fit | 100 nF, +/-10%, 50 V, X7R, 0805 (2.0 x 1.25 mm). Nominal rating does not constitute a guaranteed biased capacitance. | https://www.we-online.com/components/products/datasheet/885012207098.pdf
C11 | 1u | 885012207078 | Wurth Elektronik | Capacitor_SMD:C_0805_2012Metric | Fit | 1 uF, +/-10%, 25 V, X7R, 0805 (2.0 x 1.25 mm). Nominal rating does not constitute a guaranteed biased capacitance. | https://www.we-online.com/components/products/datasheet/885012207078.pdf
C12 | 1u | 885012207078 | Wurth Elektronik | Capacitor_SMD:C_0805_2012Metric | Fit | 1 uF, +/-10%, 25 V, X7R, 0805 (2.0 x 1.25 mm). Nominal rating does not constitute a guaranteed biased capacitance. | https://www.we-online.com/components/products/datasheet/885012207078.pdf
C13 | 22u 25V X5R | C2012X5R1E226M125AC | TDK | Capacitor_SMD:C_0805_2012Metric | Fit | Increase nominal output capacitance from 10 to 22 uF in the same 0805 footprint. 22 uF +/-20%, 25 V, X5R, 2.0 x 1.25 x 1.25 mm. REF5040A permits 1-50 uF output capacitance; even +20% tolerance and +15% temperature change give 30.36 uF nominal upper estimate. Effective capacitance at 4.096 V is NOT guaranteed here. Manufacturer characterization data are typical; qualify reference noise/transients on the assembled board. X5R rating limits this component to +85 C. No footprint, pad or net change. | https://product.tdk.com/en/search/capacitor/ceramic/mlcc/info?part_no=C2012X5R1E226M125AC | https://www.ti.com/lit/ds/symlink/ref50.pdf
J1 | ISOLATED_LOCAL_POWER | TSW-104-07-G-S | Samtec | Connector_PinHeader_2.54mm:PinHeader_1x04_P2.54mm_Vertical | Fit | 4-position, single-row, straight through-hole, 2.54 mm pitch, 0.635 mm square post. Unshrouded and UNPOLARIZED: pin-1 marking and verified cable mapping are required; this is not a keyed connector. Official layout recommends 1.02 mm finished holes. Standard KiCad footprint has 1.00 mm holes; use 1.02 mm nominal or a documented 1.05 mm production nominal and rerun DRC/parity. Pad centers, copper pad size and routing need not change. Lead style 07: 5.84 mm post, 2.54 mm tail. J4 is optional/unconnected unless an existing documented Howland enable connection is available; do not modify the Howland board. | https://www.samtec.com/products/tsw-104-07-g-s | https://suddendocs.samtec.com/prints/tsw-xxx-xx-x-x-xx-xxx-footprint.pdf | https://suddendocs.samtec.com/prints/tsw-xxx-xx-xxx-x-xx-xxx-mkt.pdf
J2 | HOWLAND_OUTPUT_INPUT | TSW-102-07-G-S | Samtec | Connector_PinHeader_2.54mm:PinHeader_1x02_P2.54mm_Vertical | Fit | 2-position, single-row, straight through-hole, 2.54 mm pitch, 0.635 mm square post. Unshrouded and UNPOLARIZED: pin-1 marking and verified cable mapping are required; this is not a keyed connector. Official layout recommends 1.02 mm finished holes. Standard KiCad footprint has 1.00 mm holes; use 1.02 mm nominal or a documented 1.05 mm production nominal and rerun DRC/parity. Pad centers, copper pad size and routing need not change. Lead style 07: 5.84 mm post, 2.54 mm tail. J4 is optional/unconnected unless an existing documented Howland enable connection is available; do not modify the Howland board. | https://www.samtec.com/products/tsw-102-07-g-s | https://suddendocs.samtec.com/prints/tsw-xxx-xx-x-x-xx-xxx-footprint.pdf | https://suddendocs.samtec.com/prints/tsw-xxx-xx-xxx-x-xx-xxx-mkt.pdf
J3 | ISOLATED_CONTROL | TSW-106-07-G-S | Samtec | Connector_PinHeader_2.54mm:PinHeader_1x06_P2.54mm_Vertical | Fit | 6-position, single-row, straight through-hole, 2.54 mm pitch, 0.635 mm square post. Unshrouded and UNPOLARIZED: pin-1 marking and verified cable mapping are required; this is not a keyed connector. Official layout recommends 1.02 mm finished holes. Standard KiCad footprint has 1.00 mm holes; use 1.02 mm nominal or a documented 1.05 mm production nominal and rerun DRC/parity. Pad centers, copper pad size and routing need not change. Lead style 07: 5.84 mm post, 2.54 mm tail. J4 is optional/unconnected unless an existing documented Howland enable connection is available; do not modify the Howland board. | https://www.samtec.com/products/tsw-106-07-g-s | https://suddendocs.samtec.com/prints/tsw-xxx-xx-x-x-xx-xxx-footprint.pdf | https://suddendocs.samtec.com/prints/tsw-xxx-xx-xxx-x-xx-xxx-mkt.pdf
J4 | HOWLAND_ENABLE | TSW-102-07-G-S | Samtec | Connector_PinHeader_2.54mm:PinHeader_1x02_P2.54mm_Vertical | Fit | 2-position, single-row, straight through-hole, 2.54 mm pitch, 0.635 mm square post. Unshrouded and UNPOLARIZED: pin-1 marking and verified cable mapping are required; this is not a keyed connector. Official layout recommends 1.02 mm finished holes. Standard KiCad footprint has 1.00 mm holes; use 1.02 mm nominal or a documented 1.05 mm production nominal and rerun DRC/parity. Pad centers, copper pad size and routing need not change. Lead style 07: 5.84 mm post, 2.54 mm tail. J4 is optional/unconnected unless an existing documented Howland enable connection is available; do not modify the Howland board. | https://www.samtec.com/products/tsw-102-07-g-s | https://suddendocs.samtec.com/prints/tsw-xxx-xx-x-x-xx-xxx-footprint.pdf | https://suddendocs.samtec.com/prints/tsw-xxx-xx-xxx-x-xx-xxx-mkt.pdf
J5 | SIMULTANEOUS_ADC_MODULE | TSW-107-07-G-S | Samtec | Connector_PinHeader_2.54mm:PinHeader_1x07_P2.54mm_Vertical | Fit | 7-position, single-row, straight through-hole, 2.54 mm pitch, 0.635 mm square post. Unshrouded and UNPOLARIZED: pin-1 marking and verified cable mapping are required; this is not a keyed connector. Official layout recommends 1.02 mm finished holes. Standard KiCad footprint has 1.00 mm holes; use 1.02 mm nominal or a documented 1.05 mm production nominal and rerun DRC/parity. Pad centers, copper pad size and routing need not change. Lead style 07: 5.84 mm post, 2.54 mm tail. J4 is optional/unconnected unless an existing documented Howland enable connection is available; do not modify the Howland board. | https://www.samtec.com/products/tsw-107-07-g-s | https://suddendocs.samtec.com/prints/tsw-xxx-xx-x-x-xx-xxx-footprint.pdf | https://suddendocs.samtec.com/prints/tsw-xxx-xx-xxx-x-xx-xxx-mkt.pdf
J6 | FAULT_STATUS | TSW-103-07-G-S | Samtec | Connector_PinHeader_2.54mm:PinHeader_1x03_P2.54mm_Vertical | Fit | 3-position, single-row, straight through-hole, 2.54 mm pitch, 0.635 mm square post. Unshrouded and UNPOLARIZED: pin-1 marking and verified cable mapping are required; this is not a keyed connector. Official layout recommends 1.02 mm finished holes. Standard KiCad footprint has 1.00 mm holes; use 1.02 mm nominal or a documented 1.05 mm production nominal and rerun DRC/parity. Pad centers, copper pad size and routing need not change. Lead style 07: 5.84 mm post, 2.54 mm tail. J4 is optional/unconnected unless an existing documented Howland enable connection is available; do not modify the Howland board. J6.1 is conditioned FAULT_CLEAR_N, J6.2 MID, J6.3 P3V3; do not substitute raw FAULT_N. | https://www.samtec.com/products/tsw-103-07-g-s | https://suddendocs.samtec.com/prints/tsw-xxx-xx-x-x-xx-xxx-footprint.pdf | https://suddendocs.samtec.com/prints/tsw-xxx-xx-xxx-x-xx-xxx-mkt.pdf
TP1 | I_MON | PCB_FEATURE_NO_COMPONENT | PCB fabrication | TestPoint:TestPoint_Pad_D1.0mm | PCB feature; no component | Existing 1 mm exposed copper test pad is a PCB feature. No soldered test-point component or purchase MPN is required.
TP2 | V_MON | PCB_FEATURE_NO_COMPONENT | PCB fabrication | TestPoint:TestPoint_Pad_D1.0mm | PCB feature; no component | Existing 1 mm exposed copper test pad is a PCB feature. No soldered test-point component or purchase MPN is required.
TP3 | FAULT_N | PCB_FEATURE_NO_COMPONENT | PCB fabrication | TestPoint:TestPoint_Pad_D1.0mm | PCB feature; no component | Existing 1 mm exposed copper test pad is a PCB feature. No soldered test-point component or purchase MPN is required.
TP4 | BIAS_2V048 | PCB_FEATURE_NO_COMPONENT | PCB fabrication | TestPoint:TestPoint_Pad_D1.0mm | PCB feature; no component | Existing 1 mm exposed copper test pad is a PCB feature. No soldered test-point component or purchase MPN is required.
R36 | 22.1k 1% 0.75W | CRCW201022K1FKEF |  | Resistor_SMD:R_2010_5025Metric | Fit | High voltage input fault resistor. Minimum 0.75 W rating, 200 V working-voltage candidate. +/-80 V / minimum R <=3.66 mA, <=0.293 W. Verify thermal derating and exact MPN. Do not substitute 0805/0.125 W.
D1 | BAV199 | BAV199,215 |  | Package_TO_SOT_SMD:SOT-23 | Fit | Low leakage double series diode. Pin 1 A1, pin 2 K2, pin 3 K1/A2. Clamp references sit about +/-1 V inside the +/-5 V rails.
R37 | 1k | TNPW08051K00BEEA | Vishay | Resistor_SMD:R_0805_2012Metric | Fit | Manufacturer resistance code uses R/K/M decimal notation; B=0.1%, E=25 ppm/K, EA=tape packaging. Electrical value and footprint unchanged. TNPW0805 0.1%/25 ppm range includes 499 kohm (up to 1 Mohm). | https://www.vishay.com/docs/28758/tnpw_e3.pdf
R38 | 249R | TNPW0805249RBEEA | Vishay | Resistor_SMD:R_0805_2012Metric | Fit | Manufacturer resistance code uses R/K/M decimal notation; B=0.1%, E=25 ppm/K, EA=tape packaging. Electrical value and footprint unchanged. TNPW0805 0.1%/25 ppm range includes 499 kohm (up to 1 Mohm). | https://www.vishay.com/docs/28758/tnpw_e3.pdf
R39 | 1k | TNPW08051K00BEEA | Vishay | Resistor_SMD:R_0805_2012Metric | Fit | Manufacturer resistance code uses R/K/M decimal notation; B=0.1%, E=25 ppm/K, EA=tape packaging. Electrical value and footprint unchanged. TNPW0805 0.1%/25 ppm range includes 499 kohm (up to 1 Mohm). | https://www.vishay.com/docs/28758/tnpw_e3.pdf
R40 | 249R | TNPW0805249RBEEA | Vishay | Resistor_SMD:R_0805_2012Metric | Fit | Manufacturer resistance code uses R/K/M decimal notation; B=0.1%, E=25 ppm/K, EA=tape packaging. Electrical value and footprint unchanged. TNPW0805 0.1%/25 ppm range includes 499 kohm (up to 1 Mohm). | https://www.vishay.com/docs/28758/tnpw_e3.pdf
R41 | 470R 1% 0.25W | CRCW1206470RFKEA |  | Resistor_SMD:R_1206_3216Metric | Fit | Rail bleeder/defined back-power load. 53.2 mW at 5 V. 5 mA bounded total fault injection yields <=2.374 V across maximum R; insufficient to pass +5 V power good. Not a substitute for surge absorption or arbitrary regulator failure protection.
R42 | 470R 1% 0.25W | CRCW1206470RFKEA |  | Resistor_SMD:R_1206_3216Metric | Fit | Rail bleeder/defined back-power load. 53.2 mW at 5 V. 5 mA bounded total fault injection yields <=2.374 V across maximum R; insufficient to pass +5 V power good. Not a substitute for surge absorption or arbitrary regulator failure protection.
U11 | TLV1704 | TLV1704IPWR |  | Package_SO:TSSOP-14_4.4x5mm_P0.65mm | Fit | Independent positive and negative HV rail windows relative to channel MID. All outputs fault outside window.
R43 | 499k | TNPW0805499KBEEA | Vishay | Resistor_SMD:R_0805_2012Metric | Fit | Manufacturer resistance code uses R/K/M decimal notation; B=0.1%, E=25 ppm/K, EA=tape packaging. Electrical value and footprint unchanged. TNPW0805 0.1%/25 ppm range includes 499 kohm (up to 1 Mohm). | https://www.vishay.com/docs/28758/tnpw_e3.pdf
R44 | 499k | TNPW0805499KBEEA | Vishay | Resistor_SMD:R_0805_2012Metric | Fit | Manufacturer resistance code uses R/K/M decimal notation; B=0.1%, E=25 ppm/K, EA=tape packaging. Electrical value and footprint unchanged. TNPW0805 0.1%/25 ppm range includes 499 kohm (up to 1 Mohm). | https://www.vishay.com/docs/28758/tnpw_e3.pdf
R45 | 499k | TNPW0805499KBEEA | Vishay | Resistor_SMD:R_0805_2012Metric | Fit | Manufacturer resistance code uses R/K/M decimal notation; B=0.1%, E=25 ppm/K, EA=tape packaging. Electrical value and footprint unchanged. TNPW0805 0.1%/25 ppm range includes 499 kohm (up to 1 Mohm). | https://www.vishay.com/docs/28758/tnpw_e3.pdf
R46 | 499k | TNPW0805499KBEEA | Vishay | Resistor_SMD:R_0805_2012Metric | Fit | Manufacturer resistance code uses R/K/M decimal notation; B=0.1%, E=25 ppm/K, EA=tape packaging. Electrical value and footprint unchanged. TNPW0805 0.1%/25 ppm range includes 499 kohm (up to 1 Mohm). | https://www.vishay.com/docs/28758/tnpw_e3.pdf
R47 | 49.9k | TNPW080549K9BEEA | Vishay | Resistor_SMD:R_0805_2012Metric | Fit | Manufacturer resistance code uses R/K/M decimal notation; B=0.1%, E=25 ppm/K, EA=tape packaging. Electrical value and footprint unchanged. TNPW0805 0.1%/25 ppm range includes 499 kohm (up to 1 Mohm). | https://www.vishay.com/docs/28758/tnpw_e3.pdf
R48 | 499k | TNPW0805499KBEEA | Vishay | Resistor_SMD:R_0805_2012Metric | Fit | Manufacturer resistance code uses R/K/M decimal notation; B=0.1%, E=25 ppm/K, EA=tape packaging. Electrical value and footprint unchanged. TNPW0805 0.1%/25 ppm range includes 499 kohm (up to 1 Mohm). | https://www.vishay.com/docs/28758/tnpw_e3.pdf
R49 | 499k | TNPW0805499KBEEA | Vishay | Resistor_SMD:R_0805_2012Metric | Fit | Manufacturer resistance code uses R/K/M decimal notation; B=0.1%, E=25 ppm/K, EA=tape packaging. Electrical value and footprint unchanged. TNPW0805 0.1%/25 ppm range includes 499 kohm (up to 1 Mohm). | https://www.vishay.com/docs/28758/tnpw_e3.pdf
R50 | 499k | TNPW0805499KBEEA | Vishay | Resistor_SMD:R_0805_2012Metric | Fit | Manufacturer resistance code uses R/K/M decimal notation; B=0.1%, E=25 ppm/K, EA=tape packaging. Electrical value and footprint unchanged. TNPW0805 0.1%/25 ppm range includes 499 kohm (up to 1 Mohm). | https://www.vishay.com/docs/28758/tnpw_e3.pdf
R51 | 499k | TNPW0805499KBEEA | Vishay | Resistor_SMD:R_0805_2012Metric | Fit | Manufacturer resistance code uses R/K/M decimal notation; B=0.1%, E=25 ppm/K, EA=tape packaging. Electrical value and footprint unchanged. TNPW0805 0.1%/25 ppm range includes 499 kohm (up to 1 Mohm). | https://www.vishay.com/docs/28758/tnpw_e3.pdf
R52 | 49.9k | TNPW080549K9BEEA | Vishay | Resistor_SMD:R_0805_2012Metric | Fit | Manufacturer resistance code uses R/K/M decimal notation; B=0.1%, E=25 ppm/K, EA=tape packaging. Electrical value and footprint unchanged. TNPW0805 0.1%/25 ppm range includes 499 kohm (up to 1 Mohm). | https://www.vishay.com/docs/28758/tnpw_e3.pdf
R53 | 4.42k | TNPW08054K42BEEA | Vishay | Resistor_SMD:R_0805_2012Metric | Fit | Manufacturer resistance code uses R/K/M decimal notation; B=0.1%, E=25 ppm/K, EA=tape packaging. Electrical value and footprint unchanged. TNPW0805 0.1%/25 ppm range includes 499 kohm (up to 1 Mohm). | https://www.vishay.com/docs/28758/tnpw_e3.pdf
R54 | 10k | TNPW080510K0BEEA | Vishay | Resistor_SMD:R_0805_2012Metric | Fit | Manufacturer resistance code uses R/K/M decimal notation; B=0.1%, E=25 ppm/K, EA=tape packaging. Electrical value and footprint unchanged. TNPW0805 0.1%/25 ppm range includes 499 kohm (up to 1 Mohm). | https://www.vishay.com/docs/28758/tnpw_e3.pdf
R55 | 3.24k | TNPW08053K24BEEA | Vishay | Resistor_SMD:R_0805_2012Metric | Fit | Manufacturer resistance code uses R/K/M decimal notation; B=0.1%, E=25 ppm/K, EA=tape packaging. Electrical value and footprint unchanged. TNPW0805 0.1%/25 ppm range includes 499 kohm (up to 1 Mohm). | https://www.vishay.com/docs/28758/tnpw_e3.pdf
R56 | 10k | TNPW080510K0BEEA | Vishay | Resistor_SMD:R_0805_2012Metric | Fit | Manufacturer resistance code uses R/K/M decimal notation; B=0.1%, E=25 ppm/K, EA=tape packaging. Electrical value and footprint unchanged. TNPW0805 0.1%/25 ppm range includes 499 kohm (up to 1 Mohm). | https://www.vishay.com/docs/28758/tnpw_e3.pdf
R57 | 35.7k | TNPW080535K7BEEA | Vishay | Resistor_SMD:R_0805_2012Metric | Fit | Manufacturer resistance code uses R/K/M decimal notation; B=0.1%, E=25 ppm/K, EA=tape packaging. Electrical value and footprint unchanged. TNPW0805 0.1%/25 ppm range includes 499 kohm (up to 1 Mohm). | https://www.vishay.com/docs/28758/tnpw_e3.pdf
R58 | 10k | TNPW080510K0BEEA | Vishay | Resistor_SMD:R_0805_2012Metric | Fit | Manufacturer resistance code uses R/K/M decimal notation; B=0.1%, E=25 ppm/K, EA=tape packaging. Electrical value and footprint unchanged. TNPW0805 0.1%/25 ppm range includes 499 kohm (up to 1 Mohm). | https://www.vishay.com/docs/28758/tnpw_e3.pdf
R59 | 25.5k | TNPW080525K5BEEA | Vishay | Resistor_SMD:R_0805_2012Metric | Fit | Manufacturer resistance code uses R/K/M decimal notation; B=0.1%, E=25 ppm/K, EA=tape packaging. Electrical value and footprint unchanged. TNPW0805 0.1%/25 ppm range includes 499 kohm (up to 1 Mohm). | https://www.vishay.com/docs/28758/tnpw_e3.pdf
R60 | 10k | TNPW080510K0BEEA | Vishay | Resistor_SMD:R_0805_2012Metric | Fit | Manufacturer resistance code uses R/K/M decimal notation; B=0.1%, E=25 ppm/K, EA=tape packaging. Electrical value and footprint unchanged. TNPW0805 0.1%/25 ppm range includes 499 kohm (up to 1 Mohm). | https://www.vishay.com/docs/28758/tnpw_e3.pdf
U12 | TLV1702 | TLV1702IDGKR |  | Package_SO:VSSOP-8_3x3mm_P0.65mm | Fit | Checks HV_TOP + HV_BOTTOM balance relative to local MID, nominal sum window about -3.92 to +4.096 V. This detects gross midpoint shift; tolerances and comparator offset expand thresholds.
R61 | 499k | TNPW0805499KBEEA | Vishay | Resistor_SMD:R_0805_2012Metric | Fit | Manufacturer resistance code uses R/K/M decimal notation; B=0.1%, E=25 ppm/K, EA=tape packaging. Electrical value and footprint unchanged. TNPW0805 0.1%/25 ppm range includes 499 kohm (up to 1 Mohm). | https://www.vishay.com/docs/28758/tnpw_e3.pdf
R62 | 499k | TNPW0805499KBEEA | Vishay | Resistor_SMD:R_0805_2012Metric | Fit | Manufacturer resistance code uses R/K/M decimal notation; B=0.1%, E=25 ppm/K, EA=tape packaging. Electrical value and footprint unchanged. TNPW0805 0.1%/25 ppm range includes 499 kohm (up to 1 Mohm). | https://www.vishay.com/docs/28758/tnpw_e3.pdf
R63 | 499k | TNPW0805499KBEEA | Vishay | Resistor_SMD:R_0805_2012Metric | Fit | Manufacturer resistance code uses R/K/M decimal notation; B=0.1%, E=25 ppm/K, EA=tape packaging. Electrical value and footprint unchanged. TNPW0805 0.1%/25 ppm range includes 499 kohm (up to 1 Mohm). | https://www.vishay.com/docs/28758/tnpw_e3.pdf
R64 | 499k | TNPW0805499KBEEA | Vishay | Resistor_SMD:R_0805_2012Metric | Fit | Manufacturer resistance code uses R/K/M decimal notation; B=0.1%, E=25 ppm/K, EA=tape packaging. Electrical value and footprint unchanged. TNPW0805 0.1%/25 ppm range includes 499 kohm (up to 1 Mohm). | https://www.vishay.com/docs/28758/tnpw_e3.pdf
R65 | 10k | TNPW080510K0BEEA | Vishay | Resistor_SMD:R_0805_2012Metric | Fit | Manufacturer resistance code uses R/K/M decimal notation; B=0.1%, E=25 ppm/K, EA=tape packaging. Electrical value and footprint unchanged. TNPW0805 0.1%/25 ppm range includes 499 kohm (up to 1 Mohm). | https://www.vishay.com/docs/28758/tnpw_e3.pdf
R66 | 10.8k | TNPW080510K8BEEA | Vishay | Resistor_SMD:R_0805_2012Metric | Fit | Manufacturer resistance code uses R/K/M decimal notation; B=0.1%, E=25 ppm/K, EA=tape packaging. Electrical value and footprint unchanged. TNPW0805 0.1%/25 ppm range includes 499 kohm (up to 1 Mohm). | https://www.vishay.com/docs/28758/tnpw_e3.pdf
R67 | 10k | TNPW080510K0BEEA | Vishay | Resistor_SMD:R_0805_2012Metric | Fit | Manufacturer resistance code uses R/K/M decimal notation; B=0.1%, E=25 ppm/K, EA=tape packaging. Electrical value and footprint unchanged. TNPW0805 0.1%/25 ppm range includes 499 kohm (up to 1 Mohm). | https://www.vishay.com/docs/28758/tnpw_e3.pdf
R68 | 10k | TNPW080510K0BEEA | Vishay | Resistor_SMD:R_0805_2012Metric | Fit | Manufacturer resistance code uses R/K/M decimal notation; B=0.1%, E=25 ppm/K, EA=tape packaging. Electrical value and footprint unchanged. TNPW0805 0.1%/25 ppm range includes 499 kohm (up to 1 Mohm). | https://www.vishay.com/docs/28758/tnpw_e3.pdf
R69 | 10k | TNPW080510K0BEEA | Vishay | Resistor_SMD:R_0805_2012Metric | Fit | Manufacturer resistance code uses R/K/M decimal notation; B=0.1%, E=25 ppm/K, EA=tape packaging. Electrical value and footprint unchanged. TNPW0805 0.1%/25 ppm range includes 499 kohm (up to 1 Mohm). | https://www.vishay.com/docs/28758/tnpw_e3.pdf
U13 | TLV1702 | TLV1702IDGKR |  | Package_SO:VSSOP-8_3x3mm_P0.65mm | Fit | Near-zero command window. Outputs pull ZERO_RAW low outside the window; this qualifies arming only and does not continuously inhibit an armed waveform.
R70 | 300k | TNPW0805300KBEEA | Vishay | Resistor_SMD:R_0805_2012Metric | Fit | Manufacturer resistance code uses R/K/M decimal notation; B=0.1%, E=25 ppm/K, EA=tape packaging. Electrical value and footprint unchanged. TNPW0805 0.1%/25 ppm range includes 499 kohm (up to 1 Mohm). | https://www.vishay.com/docs/28758/tnpw_e3.pdf
R71 | 100k | TNPW0805100KBEEA | Vishay | Resistor_SMD:R_0805_2012Metric | Fit | Manufacturer resistance code uses R/K/M decimal notation; B=0.1%, E=25 ppm/K, EA=tape packaging. Electrical value and footprint unchanged. TNPW0805 0.1%/25 ppm range includes 499 kohm (up to 1 Mohm). | https://www.vishay.com/docs/28758/tnpw_e3.pdf
R72 | 16.9k | TNPW080516K9BEEA | Vishay | Resistor_SMD:R_0805_2012Metric | Fit | Manufacturer resistance code uses R/K/M decimal notation; B=0.1%, E=25 ppm/K, EA=tape packaging. Electrical value and footprint unchanged. TNPW0805 0.1%/25 ppm range includes 499 kohm (up to 1 Mohm). | https://www.vishay.com/docs/28758/tnpw_e3.pdf
R73 | 10k | TNPW080510K0BEEA | Vishay | Resistor_SMD:R_0805_2012Metric | Fit | Manufacturer resistance code uses R/K/M decimal notation; B=0.1%, E=25 ppm/K, EA=tape packaging. Electrical value and footprint unchanged. TNPW0805 0.1%/25 ppm range includes 499 kohm (up to 1 Mohm). | https://www.vishay.com/docs/28758/tnpw_e3.pdf
R74 | 16.5k | TNPW080516K5BEEA | Vishay | Resistor_SMD:R_0805_2012Metric | Fit | Manufacturer resistance code uses R/K/M decimal notation; B=0.1%, E=25 ppm/K, EA=tape packaging. Electrical value and footprint unchanged. TNPW0805 0.1%/25 ppm range includes 499 kohm (up to 1 Mohm). | https://www.vishay.com/docs/28758/tnpw_e3.pdf
R75 | 10k | TNPW080510K0BEEA | Vishay | Resistor_SMD:R_0805_2012Metric | Fit | Manufacturer resistance code uses R/K/M decimal notation; B=0.1%, E=25 ppm/K, EA=tape packaging. Electrical value and footprint unchanged. TNPW0805 0.1%/25 ppm range includes 499 kohm (up to 1 Mohm). | https://www.vishay.com/docs/28758/tnpw_e3.pdf
R76 | 10k | TNPW080510K0BEEA | Vishay | Resistor_SMD:R_0805_2012Metric | Fit | Manufacturer resistance code uses R/K/M decimal notation; B=0.1%, E=25 ppm/K, EA=tape packaging. Electrical value and footprint unchanged. TNPW0805 0.1%/25 ppm range includes 499 kohm (up to 1 Mohm). | https://www.vishay.com/docs/28758/tnpw_e3.pdf
U14 | TPS3808G01 | TPS3808G01DBVR |  | Package_TO_SOT_SMD:SOT-23-6 | Fit | TPS3808G01 command qualification timer. CT connected to VDD through 49.9k gives 180/300/420 ms release delay after ZERO_RAW rises. MR going low resets immediately; no passive diode residual/stale RC permission. SENSE directly monitors VDD >0.405 V; separate G33 supervisor enforces valid logic supply.
U15 | TPS3808G01 | TPS3808G01DBVR |  | Package_TO_SOT_SMD:SOT-23-6 | Fit | Condition wired comparator fault into a guaranteed low logic level. MR VIL=0.3VDD accommodates TLV170x low output <=0.9 V only while valid 3.3 V rail is above supervisor threshold. Output asserts after MR propagation, nominal 150 ns, then releases 12..28 ms after raw fault clears. No guaranteed maximum fault latency is claimed.
U16 | SN74LVC2G17 | SN74LVC2G17DBVR |  | Package_TO_SOT_SMD:SOT-23-6 | Fit | Schmitt buffers clean the two open-drain supervisor output edges before LVC latch inputs. Partial-power-down Ioff prevents output back-drive.
R77 | 10k | TNPW080510K0BEEA | Vishay | Resistor_SMD:R_0805_2012Metric | Fit | Manufacturer resistance code uses R/K/M decimal notation; B=0.1%, E=25 ppm/K, EA=tape packaging. Electrical value and footprint unchanged. TNPW0805 0.1%/25 ppm range includes 499 kohm (up to 1 Mohm). | https://www.vishay.com/docs/28758/tnpw_e3.pdf
R78 | 10k | TNPW080510K0BEEA | Vishay | Resistor_SMD:R_0805_2012Metric | Fit | Manufacturer resistance code uses R/K/M decimal notation; B=0.1%, E=25 ppm/K, EA=tape packaging. Electrical value and footprint unchanged. TNPW0805 0.1%/25 ppm range includes 499 kohm (up to 1 Mohm). | https://www.vishay.com/docs/28758/tnpw_e3.pdf
R79 | 49.9k | TNPW080549K9BEEA | Vishay | Resistor_SMD:R_0805_2012Metric | Fit | Manufacturer resistance code uses R/K/M decimal notation; B=0.1%, E=25 ppm/K, EA=tape packaging. Electrical value and footprint unchanged. TNPW0805 0.1%/25 ppm range includes 499 kohm (up to 1 Mohm). | https://www.vishay.com/docs/28758/tnpw_e3.pdf
C14 | 100n | 885012207098 | Wurth Elektronik | Capacitor_SMD:C_0805_2012Metric | Fit | 100 nF, +/-10%, 50 V, X7R, 0805 (2.0 x 1.25 mm). Nominal rating does not constitute a guaranteed biased capacitance. | https://www.we-online.com/components/products/datasheet/885012207098.pdf
C15 | 100n | 885012207098 | Wurth Elektronik | Capacitor_SMD:C_0805_2012Metric | Fit | 100 nF, +/-10%, 50 V, X7R, 0805 (2.0 x 1.25 mm). Nominal rating does not constitute a guaranteed biased capacitance. | https://www.we-online.com/components/products/datasheet/885012207098.pdf
C16 | 100n | 885012207098 | Wurth Elektronik | Capacitor_SMD:C_0805_2012Metric | Fit | 100 nF, +/-10%, 50 V, X7R, 0805 (2.0 x 1.25 mm). Nominal rating does not constitute a guaranteed biased capacitance. | https://www.we-online.com/components/products/datasheet/885012207098.pdf
C17 | 100n | 885012207098 | Wurth Elektronik | Capacitor_SMD:C_0805_2012Metric | Fit | 100 nF, +/-10%, 50 V, X7R, 0805 (2.0 x 1.25 mm). Nominal rating does not constitute a guaranteed biased capacitance. | https://www.we-online.com/components/products/datasheet/885012207098.pdf
C18 | 100n | 885012207098 | Wurth Elektronik | Capacitor_SMD:C_0805_2012Metric | Fit | 100 nF, +/-10%, 50 V, X7R, 0805 (2.0 x 1.25 mm). Nominal rating does not constitute a guaranteed biased capacitance. | https://www.we-online.com/components/products/datasheet/885012207098.pdf
C19 | 100n | 885012207098 | Wurth Elektronik | Capacitor_SMD:C_0805_2012Metric | Fit | 100 nF, +/-10%, 50 V, X7R, 0805 (2.0 x 1.25 mm). Nominal rating does not constitute a guaranteed biased capacitance. | https://www.we-online.com/components/products/datasheet/885012207098.pdf
J7 | HV_RAIL_MONITOR | TSW-103-07-G-S | Samtec | Connector_PinHeader_2.54mm:PinHeader_1x03_P2.54mm_Vertical | Fit | 3-position, single-row, straight through-hole, 2.54 mm pitch, 0.635 mm square post. Unshrouded and UNPOLARIZED: pin-1 marking and verified cable mapping are required; this is not a keyed connector. Official layout recommends 1.02 mm finished holes. Standard KiCad footprint has 1.00 mm holes; use 1.02 mm nominal or a documented 1.05 mm production nominal and rerun DRC/parity. Pad centers, copper pad size and routing need not change. Lead style 07: 5.84 mm post, 2.54 mm tail. J4 is optional/unconnected unless an existing documented Howland enable connection is available; do not modify the Howland board. | https://www.samtec.com/products/tsw-103-07-g-s | https://suddendocs.samtec.com/prints/tsw-xxx-xx-x-x-xx-xxx-footprint.pdf | https://suddendocs.samtec.com/prints/tsw-xxx-xx-xxx-x-xx-xxx-mkt.pdf
J8 | COMMAND_MONITOR | TSW-102-07-G-S | Samtec | Connector_PinHeader_2.54mm:PinHeader_1x02_P2.54mm_Vertical | Fit | 2-position, single-row, straight through-hole, 2.54 mm pitch, 0.635 mm square post. Unshrouded and UNPOLARIZED: pin-1 marking and verified cable mapping are required; this is not a keyed connector. Official layout recommends 1.02 mm finished holes. Standard KiCad footprint has 1.00 mm holes; use 1.02 mm nominal or a documented 1.05 mm production nominal and rerun DRC/parity. Pad centers, copper pad size and routing need not change. Lead style 07: 5.84 mm post, 2.54 mm tail. J4 is optional/unconnected unless an existing documented Howland enable connection is available; do not modify the Howland board. | https://www.samtec.com/products/tsw-102-07-g-s | https://suddendocs.samtec.com/prints/tsw-xxx-xx-x-x-xx-xxx-footprint.pdf | https://suddendocs.samtec.com/prints/tsw-xxx-xx-xxx-x-xx-xxx-mkt.pdf
K101 | DPST_NO_5V | 104-2-A-5/2 | Pickering | ProtectionLocal:Pickering104_Package4_6Pin_P5.08 | Fit | Verified against Pickering Issue 4.1, May 2025, page 7, Package Type 4: contacts 1-6 and 2-5; coil 3-4. No D suffix means no internal diode. Body 29 x 6.22 x 12.5 mm; six inline pins at 5.08 mm pitch; leads 0.5 x 0.25 mm. Local footprint uses selected 0.9 mm finished holes and 1.8 mm pads. All sensing connects to the INTERNAL_P and INTERNAL_N nets.
Q101 | AO3400A | AO3400A | Alpha & Omega Semiconductor | Package_TO_SOT_SMD:SOT-23 | Fit | 30 V N-channel MOSFET; maximum RDS(on) 48 milliohms at VGS=2.5 V and 25 C. Direct 3.3 V logic coil drive. Never connect this transistor to the HV rails.
D101 | SMAJ12A_COIL_CLAMP | SMAJ12A-E3/61 | Vishay | Diode_SMD:D_SMA | Fit | Unidirectional TVS: pin 1 cathode at drain, pin 2 anode at MID. Direct drain-source clamp, not across the coil. Datasheet 25 C clamp maximum is 19.9 V at 20.1 A. Measure actual coil turn-off voltage including layout overshoot. Do not substitute a bidirectional CA part without review.
R101 | 100R | TNPW0805100RBEEA | Vishay | Resistor_SMD:R_0805_2012Metric | Fit | Manufacturer resistance code uses R/K/M decimal notation; B=0.1%, E=25 ppm/K, EA=tape packaging. Electrical value and footprint unchanged. TNPW0805 0.1%/25 ppm range includes 499 kohm (up to 1 Mohm). | https://www.vishay.com/docs/28758/tnpw_e3.pdf
R102 | 10k | TNPW080510K0BEEA | Vishay | Resistor_SMD:R_0805_2012Metric | Fit | Manufacturer resistance code uses R/K/M decimal notation; B=0.1%, E=25 ppm/K, EA=tape packaging. Electrical value and footprint unchanged. TNPW0805 0.1%/25 ppm range includes 499 kohm (up to 1 Mohm). | https://www.vishay.com/docs/28758/tnpw_e3.pdf
U101 | TPS3808G01 | TPS3808G01DBVR |  | Package_TO_SOT_SMD:SOT-23-6 | Fit | MR=ARMED; CT open; RESET release delay 12/20/28 ms minimum/typical/maximum over datasheet conditions. SENSE connected to 3.3 V, above the 0.405 V threshold. The core separately supervises the actual 3.3 V undervoltage threshold. This RESET output is not connected to FAULT_N.
R103 | 10k | TNPW080510K0BEEA | Vishay | Resistor_SMD:R_0805_2012Metric | Fit | Manufacturer resistance code uses R/K/M decimal notation; B=0.1%, E=25 ppm/K, EA=tape packaging. Electrical value and footprint unchanged. TNPW0805 0.1%/25 ppm range includes 499 kohm (up to 1 Mohm). | https://www.vishay.com/docs/28758/tnpw_e3.pdf
U102 | SN74LVC1G08 | SN74LVC1G08DBVR |  | Package_TO_SOT_SMD:SOT-23-5 | Fit | AND gate. ARMED low directly inhibits the amplifier without waiting for the delay IC. Output connects through existing R25 to OPA_ENABLE.
C101 | 100n50V | 885012207098 | Wurth Elektronik | Capacitor_SMD:C_0805_2012Metric | Fit | Local U101 bypass. Nominal 100 nF; no guaranteed effective capacitance under all conditions is claimed.
C102 | 100n50V | 885012207098 | Wurth Elektronik | Capacitor_SMD:C_0805_2012Metric | Fit | Local U102 bypass. Nominal 100 nF; no guaranteed effective capacitance under all conditions is claimed.
C103 | 1u25V | 885382207003 | Wurth Elektronik | Capacitor_SMD:C_0805_2012Metric | Fit | Local coil-supply bypass. Route coil return separately from Kelvin MID paths. The regulated source must support the coil step; nominal 1 uF is not a supply hold-up guarantee.
J101 | EXTERNAL_DUMMY_LOAD | TSW-102-07-G-S | Samtec | Connector_PinHeader_2.54mm:PinHeader_1x02_P2.54mm_Vertical | Fit | 2-position, single-row, straight through-hole, 2.54 mm pitch, 0.635 mm square post. Unshrouded and UNPOLARIZED: pin-1 marking and verified cable mapping are required; this is not a keyed connector. Official layout recommends 1.02 mm finished holes. Standard KiCad footprint has 1.00 mm holes; use 1.02 mm nominal or a documented 1.05 mm production nominal and rerun DRC/parity. Pad centers, copper pad size and routing need not change. Lead style 07: 5.84 mm post, 2.54 mm tail. J4 is optional/unconnected unless an existing documented Howland enable connection is available; do not modify the Howland board. | https://www.samtec.com/products/tsw-102-07-g-s | https://suddendocs.samtec.com/prints/tsw-xxx-xx-x-x-xx-xxx-footprint.pdf | https://suddendocs.samtec.com/prints/tsw-xxx-xx-xxx-x-xx-xxx-mkt.pdf
U103 | SN74LVC1G17 | SN74LVC1G17DBVR | Texas Instruments | Package_TO_SOT_SMD:SOT-23-5 | Fit | Schmitt buffer cleans the open-drain delay output before the standard CMOS AND input. Pinout verified against TI Rev Y, October 2025, DBV package.
C104 | 100n50V | 885012207098 | Wurth Elektronik | Capacitor_SMD:C_0805_2012Metric | Fit | Local U103 bypass.
