AnishLanka/BrainStimulation/boards/Shared/Monitor_Power_C1/kicad/Peter_Work/BOM.csv

Reference | Quantity per board | Manufacturer | Manufacturer part number | Value | Original footprint | Assembly note
J201 | 1 | JST | B2P-VH(LF)(SN) | SYSTEM_5V_INPUT | Connector_JST:JST_VH_B2P-VH_1x02_P3.96mm_Vertical | Primary side only. Mate VHR-2N with SVH-41T-P1.1 contacts. Standard VH header rating is 10 A with 16 AWG wire, 250 VAC/DC; this channel branch is allocated less than 1 A. Verify crimp and pin orientation. Never join SYS_GND to MID_CH.
F201 | 1 | Littelfuse | 0454002.MR | 2A_SLOW_125VDC | Fuse:Fuse_Littelfuse-NANO2-451_453 | 2 A slow fuse per TMR 3 5 V input recommendation. 125 VAC/DC, 50 A interrupt at 125 V; 300 A at 32 VDC. Nominal cold resistance 0.0625 ohm, nominal I2t 8.20 A2s. Same verified 452/454 lands. Startup coordination is still a measurement, not implied by nominal I2t.
F202 | 1 | Littelfuse | 0454.500MR | 500mA_SLOW_125VDC | Fuse:Fuse_Littelfuse-NANO2-451_453 | 500 mA slow fuse, matching the TMR 1 recommended 5 V input fuse. 125 VAC/DC, 50 A interrupt at 125 V; 300 A at 32 VDC. Nominal cold resistance 0.700 ohm; I2t 0.240 A2s is nominal, not a startup coordination guarantee. Selected footprint pads match the 452/454 recommended 1.96 x 3.15 mm lands, 2.95 mm inner gap. Use an SMD adapter for perfboard.
PS201 | 1 | TRACO Power | TMR 3-0511 | ISOLATED_REGULATED_5V_600mA | ProtectionLocal:TRACO_TMR3_SIP8_Single | Upgraded for local Pico and ADC load. TMR 3-0511 single output: 5 V / 600 mA, 3 W, input 4.5 to 9 V. Remote pin 3 open means ON. Pin 4 is absent; physical pins 5 and 8 are NC. Pin 6 is +5, pin 7 is channel MID. Keep primary isolated. Custom footprint follows the visually checked official 15-Apr-2026 SIP8 drawing; verify a physical part before assembly.
PS202 | 1 | TRACO Power | TMR 1-0511 | ISOLATED_REGULATED_5V_200mA | Converter_DCDC:Converter_DCDC_TRACO_TMR-1-xxxx_Single_THT | Single isolated output, NOT the dual-output part. 1 W, 5 V / 200 mA; 4.5 to 9 V at module input pins. Pins 3 and 5 are absent. Two independent output pairs are series-connected only at this channel MID. MID terminal is passive for ERC because it is the selected output reference. Body 17 x 7.62 x 11 mm; pin locations 0, 2.54, 7.62, 12.70 mm. Bench design, not a medical isolation certification.
R201 | 1 | Vishay | MRS25000C1500FRP00 | 150R_1%_0.6W | Resistor_THT:R_Axial_DIN0207_L6.3mm_D2.5mm_P10.16mm_Horizontal | Positive TMR 3 preload. 150 ohm, 1%, 50 ppm/K, 0.6 W at 70 C. At the 4.84 V rail corner it draws at least 31.95 mA, above the 30 mA lower load-regulation test point. Body maximum 6.5 x 2.5 mm; lead pitch selected 10.16 mm. Additional to sensing-core bleeders.
R202 | 1 | Vishay | MRS25000C2200FRP00 | 220R_1%_0.6W | Resistor_THT:R_Axial_DIN0207_L6.3mm_D2.5mm_P10.16mm_Horizontal | Standalone rail preload. 220 ohm, 1%, 50 ppm/K, 0.6 W at 70 C. Body maximum 6.5 x 2.5 mm, 0.6 mm leads; selected 10.16 mm pitch exceeds the 10 mm minimum bend spacing. This is additional to the sensing core 470 ohm bleeders. Use 220 rather than 240 ohm to remain above 20 mA at the stated low rail corner.
U201 | 1 | Microchip | MCP1702-3302E/TO | MCP1702_3V3 | Package_TO_SOT_THT:TO-92_Inline_Wide | TO-92 pin numbering is 1 GND, 2 VIN, 3 VOUT. Wide 2.54 mm footprint requires forming the outer leads from nominal 1.27 mm spacing; support the body while forming. Budget 30 mA maximum total 3.3 V load. Include output, load and line regulation. Do not parallel existing ISOW7741 output.
C201 | 1 | Panasonic | EEUFR1C101 | 100u_16V_POLAR | Capacitor_THT:CP_Radial_D5.0mm_P2.00mm | FR aluminum electrolytic, 100 uF +/-20%, 16 V. D5 x H11 mm, lead spacing 2 mm, lead diameter 0.5 mm. Impedance maximum 0.300 ohm at 100 kHz and 20 C. On the negative rail the positive terminal connects to MID. Place LDO output capacitor directly beside U201. Module load remains below its 1680 uF capacitive-load rating.
C206 | 1 | Wurth Elektronik | 885012207098 | 100n_50V_X7R | Capacitor_SMD:C_0805_2012Metric | 100 nF +/-10%, 50 V X7R, 0805 high-frequency bypass. Bulk capacitance is supplied separately; no unprovided effective-MLCC-capacitance guarantee is assumed.
C202 | 1 | Panasonic | EEUFR1C101 | 100u_16V_POLAR | Capacitor_THT:CP_Radial_D5.0mm_P2.00mm | FR aluminum electrolytic, 100 uF +/-20%, 16 V. D5 x H11 mm, lead spacing 2 mm, lead diameter 0.5 mm. Impedance maximum 0.300 ohm at 100 kHz and 20 C. On the negative rail the positive terminal connects to MID. Place LDO output capacitor directly beside U201. Module load remains below its 1680 uF capacitive-load rating.
C207 | 1 | Wurth Elektronik | 885012207098 | 100n_50V_X7R | Capacitor_SMD:C_0805_2012Metric | 100 nF +/-10%, 50 V X7R, 0805 high-frequency bypass. Bulk capacitance is supplied separately; no unprovided effective-MLCC-capacitance guarantee is assumed.
C203 | 1 | Panasonic | EEUFR1C101 | 100u_16V_POLAR | Capacitor_THT:CP_Radial_D5.0mm_P2.00mm | FR aluminum electrolytic, 100 uF +/-20%, 16 V. D5 x H11 mm, lead spacing 2 mm, lead diameter 0.5 mm. Impedance maximum 0.300 ohm at 100 kHz and 20 C. On the negative rail the positive terminal connects to MID. Place LDO output capacitor directly beside U201. Module load remains below its 1680 uF capacitive-load rating.
C208 | 1 | Wurth Elektronik | 885012207098 | 100n_50V_X7R | Capacitor_SMD:C_0805_2012Metric | 100 nF +/-10%, 50 V X7R, 0805 high-frequency bypass. Bulk capacitance is supplied separately; no unprovided effective-MLCC-capacitance guarantee is assumed.
C204 | 1 | Panasonic | EEUFR1C101 | 100u_16V_POLAR | Capacitor_THT:CP_Radial_D5.0mm_P2.00mm | FR aluminum electrolytic, 100 uF +/-20%, 16 V. D5 x H11 mm, lead spacing 2 mm, lead diameter 0.5 mm. Impedance maximum 0.300 ohm at 100 kHz and 20 C. On the negative rail the positive terminal connects to MID. Place LDO output capacitor directly beside U201. Module load remains below its 1680 uF capacitive-load rating.
C209 | 1 | Wurth Elektronik | 885012207098 | 100n_50V_X7R | Capacitor_SMD:C_0805_2012Metric | 100 nF +/-10%, 50 V X7R, 0805 high-frequency bypass. Bulk capacitance is supplied separately; no unprovided effective-MLCC-capacitance guarantee is assumed.
C205 | 1 | Panasonic | EEUFR1C101 | 100u_16V_POLAR | Capacitor_THT:CP_Radial_D5.0mm_P2.00mm | FR aluminum electrolytic, 100 uF +/-20%, 16 V. D5 x H11 mm, lead spacing 2 mm, lead diameter 0.5 mm. Impedance maximum 0.300 ohm at 100 kHz and 20 C. On the negative rail the positive terminal connects to MID. Place LDO output capacitor directly beside U201. Module load remains below its 1680 uF capacitive-load rating.
C210 | 1 | Wurth Elektronik | 885012207098 | 100n_50V_X7R | Capacitor_SMD:C_0805_2012Metric | 100 nF +/-10%, 50 V X7R, 0805 high-frequency bypass. Bulk capacitance is supplied separately; no unprovided effective-MLCC-capacitance guarantee is assumed.
J202 | 1 | JST | B4P-VH(LF)(SN) | LOCAL_MONITOR_POWER | Connector_JST:JST_VH_B4P-VH_1x04_P3.96mm_Vertical | Output harness only for this channel. Mate VHR-4N with SVH-41T-P1.1 contacts. Pin map is the project harness convention: 1 +5, 2 MID, 3 -5, 4 +3.3. Do not attach SYS_GND or another channel MID. Do not parallel existing IA0305S or ISOW7741 supply outputs.
