AnishLanka/BrainStimulation/boards/Shared/Channel_Monitor_C1/kicad/Peter_Work/Assembly_Placement.csv

Reference | Value | X_mm | Y_mm | Rotation_deg | Side
R11 | 499k | 86.0 | 107.0 | 0.0 | Top
R66 | 10.8k | 15.0 | 36.0 | 0.0 | Top
R7 | 32.4k | 62.0 | 100.0 | 90.0 | Top
U8 | TLV1702 | 108.0 | 56.0 | 0.0 | Top
R74 | 16.5k | 120.0 | 28.0 | 0.0 | Top
R4 | 10k | 64.0 | 94.0 | 0.0 | Top
Q101 | AO3400A | 56.0 | 126.0 | 0.0 | Top
R56 | 10k | 51.0 | 44.0 | 0.0 | Top
R2 | 20k | 43.0 | 88.0 | 90.0 | Top
R70 | 300k | 96.0 | 19.0 | 0.0 | Top
U103 | SN74LVC1G17 | 84.0 | 127.0 | 0.0 | Top
D1 | BAV199 | 32.0 | 96.0 | 0.0 | Top
C6 | 100n | 140.0 | 50.95 | 0.0 | Top
K101 | DPST_NO_5V | 17.0 | 127.0 | 0.0 | Top
C16 | 100n | 113.0 | 23.975 | 0.0 | Top
R73 | 10k | 95.0 | 34.0 | 0.0 | Top
U4 | TLV1704 | 111.0 | 92.0 | 0.0 | Top
R26 | 10k | 164.0 | 89.0 | 0.0 | Top
R43 | 499k | 20.0 | 73.0 | 0.0 | Top
J5 | SIMULTANEOUS_ADC_MODULE | 132.0 | 137.0 | 90.0 | Top
R52 | 49.9k | 75.0 | 50.0 | 0.0 | Top
R63 | 499k | 14.0 | 51.0 | 0.0 | Top
U14 | TPS3808G01 | 138.0 | 20.0 | 0.0 | Top
R47 | 49.9k | 52.0 | 64.0 | 0.0 | Top
C1 | 100n | 44.0 | 98.905 | 0.0 | Top
R102 | 10k | 56.0 | 120.0 | 0.0 | Top
R29 | 24.9k | 119.0 | 62.0 | 0.0 | Top
R13 | 49.9k | 83.0 | 98.0 | 90.0 | Top
R32 | 10k | 119.0 | 49.0 | 0.0 | Top
R71 | 100k | 96.0 | 24.0 | 0.0 | Top
C104 | 100n50V | 88.3 | 128.0 | 0.0 | Top
J8 | COMMAND_MONITOR | 95.0 | 9.0 | 90.0 | Top
R21 | 10k | 145.0 | 86.0 | 0.0 | Top
R69 | 10k | 37.0 | 31.0 | 0.0 | Top
R9 | 499k | 83.0 | 88.0 | 0.0 | Top
R34 | 10k | 122.0 | 35.0 | 0.0 | Top
R3 | 20k | 43.0 | 83.0 | 90.0 | Top
R54 | 10k | 51.0 | 54.0 | 0.0 | Top
R31 | 35.7k | 119.0 | 53.0 | 0.0 | Top
R41 | 470R 1% 0.25W | 20.0 | 88.0 | 90.0 | Top
R24 | 10k | 148.0 | 73.0 | 0.0 | Top
J2 | HOWLAND_OUTPUT_INPUT | 7.0 | 106.0 | 0.0 | Top
U16 | SN74LVC2G17 | 152.0 | 106.0 | 0.0 | Top
R59 | 25.5k | 75.0 | 45.0 | 0.0 | Top
C11 | 1u | 105.0 | 125.635 | 180.0 | Top
R35 | 10k | 153.0 | 83.0 | 0.0 | Top
C8 | 100n | 114.0 | 56.975 | 0.0 | Top
R48 | 499k | 20.0 | 66.0 | 0.0 | Top
U5 | SN74LVC1G74 | 152.0 | 91.0 | 0.0 | Top
R19 | 15.6k | 124.0 | 88.0 | 0.0 | Top
R72 | 16.9k | 95.0 | 30.0 | 0.0 | Top
C19 | 100n | 156.0 | 106.0 | 0.0 | Top
R101 | 100R | 50.0 | 123.0 | 0.0 | Top
C10 | 100n | 149.0 | 70.975 | 180.0 | Top
R37 | 1k | 27.0 | 91.0 | 0.0 | Top
C12 | 1u | 120.0 | 121.0 | 0.0 | Top
R16 | 5.11k | 98.0 | 88.0 | 0.0 | Top
R44 | 499k | 27.0 | 73.0 | 0.0 | Top
R22 | 10k | 146.0 | 67.0 | 0.0 | Top
C2 | 100n | 32.0 | 93.0 | 180.0 | Top
R53 | 4.42k | 51.0 | 59.0 | 0.0 | Top
R64 | 499k | 21.0 | 51.0 | 0.0 | Top
C101 | 100n50V | 76.3 | 128.1 | 0.0 | Top
R68 | 10k | 37.0 | 36.0 | 0.0 | Top
R67 | 10k | 15.0 | 31.0 | 0.0 | Top
R46 | 499k | 41.0 | 73.0 | 0.0 | Top
R17 | 15.6k | 124.0 | 98.0 | 0.0 | Top
R58 | 10k | 75.0 | 59.0 | 0.0 | Top
C5 | 100n | 158.0 | 91.75 | 0.0 | Top
R76 | 10k | 107.0 | 15.0 | 0.0 | Top
U1 | OPA2192 | 38.0 | 97.0 | 0.0 | Top
R20 | 10k | 128.0 | 77.0 | 0.0 | Top
C103 | 1u25V | 50.0 | 133.0 | 0.0 | Top
R5 | 32.4k | 63.0 | 90.0 | 0.0 | Top
J6 | FAULT_STATUS | 154.0 | 127.0 | 0.0 | Top
R62 | 499k | 21.0 | 58.0 | 0.0 | Top
C15 | 100n | 33.0 | 43.975 | 0.0 | Top
C14 | 100n | 53.0 | 56.3 | 180.0 | Top
U3 | REF5040A | 111.0 | 125.0 | 0.0 | Top
R8 | 499k | 83.0 | 83.0 | 0.0 | Top
J4 | HOWLAND_ENABLE | 171.0 | 91.0 | 0.0 | Top
C102 | 100n50V | 100.3 | 128.0 | 0.0 | Top
C13 | 22u 25V X5R | 120.0 | 126.0 | 0.0 | Top
U2 | OPA2192 | 72.0 | 97.0 | 0.0 | Top
R65 | 10k | 18.0 | 43.0 | 0.0 | Top
U15 | TPS3808G01 | 136.0 | 70.0 | 0.0 | Top
C7 | 100n | 158.0 | 50.95 | 0.0 | Top
R51 | 499k | 41.0 | 66.0 | 0.0 | Top
J7 | HV_RAIL_MONITOR | 7.0 | 76.0 | 0.0 | Top
R45 | 499k | 34.0 | 73.0 | 0.0 | Top
U13 | TLV1702 | 107.0 | 23.0 | 0.0 | Top
R23 | 10k | 164.0 | 66.0 | 0.0 | Top
D101 | SMAJ12A_COIL_CLAMP | 56.0 | 133.0 | 0.0 | Top
R75 | 10k | 120.0 | 23.0 | 0.0 | Top
U12 | TLV1702 | 27.0 | 43.0 | 0.0 | Top
J101 | EXTERNAL_DUMMY_LOAD | 6.0 | 134.0 | 0.0 | Top
R18 | 71.5k | 124.0 | 93.0 | 0.0 | Top
R55 | 3.24k | 51.0 | 49.0 | 0.0 | Top
U11 | TLV1704 | 63.0 | 55.0 | 0.0 | Top
R6 | 10k | 66.0 | 100.0 | 90.0 | Top
J3 | ISOLATED_CONTROL | 171.0 | 61.0 | 0.0 | Top
R42 | 470R 1% 0.25W | 20.0 | 82.0 | 90.0 | Top
R79 | 49.9k | 139.0 | 14.0 | 0.0 | Top
R14 | 5.11k | 98.0 | 98.0 | 0.0 | Top
R27 | 100k | 98.0 | 62.0 | 0.0 | Top
R103 | 10k | 72.0 | 133.0 | 0.0 | Top
C17 | 100n | 142.0 | 20.95 | 0.0 | Top
C9 | 100n | 132.0 | 36.95 | 0.0 | Top
R33 | 88.7k | 122.0 | 40.0 | 0.0 | Top
R12 | 499k | 86.0 | 102.0 | 0.0 | Top
J1 | ISOLATED_LOCAL_POWER | 171.0 | 126.0 | 0.0 | Top
R28 | 200k | 98.0 | 57.0 | 0.0 | Top
R30 | 10k | 119.0 | 58.0 | 0.0 | Top
R1 | 100R 0.1% | 18.0 | 107.0 | 0.0 | Top
R50 | 499k | 34.0 | 66.0 | 0.0 | Top
R40 | 249R | 33.0 | 84.0 | 0.0 | Top
U7 | TPS3808G50 | 154.0 | 50.0 | 0.0 | Top
U6 | TPS3808G33 | 136.0 | 50.0 | 0.0 | Top
R61 | 499k | 14.0 | 58.0 | 0.0 | Top
R15 | 93.1k | 98.0 | 93.0 | 0.0 | Top
U10 | TPS3431 | 155.0 | 70.0 | 0.0 | Top
C4 | 100n | 103.0 | 93.3 | 180.0 | Top
R10 | 49.9k | 83.0 | 92.0 | 0.0 | Top
C3 | 100n | 78.0 | 98.905 | 0.0 | Top
R77 | 10k | 131.0 | 24.0 | 0.0 | Top
U101 | TPS3808G01 | 72.0 | 127.0 | 0.0 | Top
R39 | 1k | 27.0 | 85.0 | 0.0 | Top
R25 | 1k | 163.0 | 96.0 | 0.0 | Top
R60 | 10k | 75.0 | 41.0 | 0.0 | Top
R38 | 249R | 33.0 | 90.0 | 0.0 | Top
R49 | 499k | 27.0 | 66.0 | 0.0 | Top
R57 | 35.7k | 75.0 | 63.0 | 0.0 | Top
U102 | SN74LVC1G08 | 96.0 | 127.0 | 0.0 | Top
R36 | 22.1k 1% 0.75W | 26.0 | 101.0 | 0.0 | Top
C18 | 100n | 140.0 | 70.95 | 0.0 | Top
R78 | 10k | 129.0 | 71.0 | 0.0 | Top
U9 | TPS3808G01 | 128.0 | 36.0 | 0.0 | Top
