AnishLanka/BrainStimulation/docs/RevC_Release/Integration_Guide.html

REVISION C • SEPARATE-BOARD BENCH PROTOTYPE • 17 OCTOBER 2026

# Connect the finished boards without changing the ordered Howland or SignalGen

The new power, monitor and ADC boards add an external measurement and relay path. The existing Anish Howland and completed SignalGen Rev C stay unchanged. Start with one channel and an external 2–5 kΩ dummy load.

Fresh checks for all eight packaged PCB projects · Final boost and splitter assembly BOM supplement · Monitor-core assembly BOM

Latest population decision: the Howland schematic’s 2k Rload1 is a test-load placeholder and will not be populated. There is no fixed parallel 2k load in this integration plan. No instruction here changes R11, the Howland E/D wiring, PCB copper, or SignalGen.

One physical connection is still unverified. The supplied Howland schematic has no dedicated output connector. Its output node is the junction of R2.2, R4.1 and Rload1.2. Connect an existing accessible output terminal to monitor J2.1 only after continuity identifies that node on the ordered board. If there is no existing terminal, the monitoring harness connection remains unverified. No terminal, mating part or PCB rework is assumed. Howland J2 is the command input, not the output.

Machine-readable wiring map and native pin inventories. Pin numbers below come from the native projects; the map records source hashes. A logical map does not prove the assembled harness.

## Two distinct power choices

Original four-branch battery candidate

### One original chain per channel

Protected battery → TPS63001 RevB → GAPTEC 3.3 V-to-12 V + existing 200 Ω preload → boost 79.7 V → splitter → nominal ±40 V

Four copies of each original power board are a candidate architecture. The calculation of about 0.62–0.72 A per 3.3 V branch excludes SignalGen and monitor power; margin against approximate 800 mA boost operation is limited. Qualify one complete chain at 2.8 V, including startup and load changes, before relying on four branches.

SignalGen still needs a separately budgeted 3.3 V rail. The new monitor-power boards still need regulated 5 V. The battery’s capacity, discharge rating, protection, charger and the additional 5 V source remain unselected. One shared original TPS63001 is inadequate for the complete four-channel system.

Completed optional bench adapter

### Shared regulated 5 V input

External 5 V / 8 A bench source → shared adapter → four isolated 12 V outputs + two separate 3.3 V banks + AUX 5 V

The adapter replaces the original TPS63001/GAPTEC input branches and their 200 Ω preloads; it retains the four boost/splitter chains. It is not directly compatible with a raw Li-ion cell and contains no charger or pack protection.

J4–J7 feed channels 1–4 boost inputs. J2 powers SignalGen A; J3 powers SignalGen B. J8 supplies a combined 4 A AUX allocation for all four monitor-power boards. Estimated full-system planning draw is 5.53 A at 5 V; startup, cable/fuse drop and temperature still need measurement.

Do not mix or parallel the two alternatives. Never parallel TPS63001 outputs or the shared adapter’s two 3.3 V banks. SignalGen J1.02 and J2.02 are internally connected to the same SYS_3V3 net: separate supply outputs connected there would be shorted together. Power each SignalGen board from one source only. Shared banks A and B go to different SignalGen boards.

All R3M/TMR modules need at least 4.5 V at their input pins after fuse and cable losses. A 5 V source reading alone does not prove this. The shared adapter input must never exceed 5.25 V. Keep MID separate from HV_BOTTOM, from system ground and from every other channel MID.

## How many boards

Board/block | First one-channel build | Four-channel build | Disposition
SignalGen Rev C | 1 board; use one of its 2 channels | 2 boards | Frozen completed design
Anish Howland | 1 existing board | 4 existing boards | Unchanged copper and resistor/E/D wiring; Rload1 DNP
Boost 79.7 V | 1 | 4 | One per isolated channel
Rail splitter | 1 | 4 | Nominal ±40 V relative to MID
Monitor core | 1 | 4 | External two-pole relay and sensing
Monitor power | 1 | 4 | Independent local ±5 V and 3.3 V
ADC / isolated Pico sampler | 1 | 4 | One simultaneous I/V sampler per channel
Original TPS63001 / GAPTEC option | 1 each | 4 each | Battery branch candidate; still needs separate monitor 5 V and SignalGen budget
Optional shared 5 V bench adapter | 1 | 1 | Alternative to original TPS63001/GAPTEC branches

These are separate bench boards. The new monitor core is 180×145 mm; the ADC board is 125×85 mm. This layout set does not establish a phone-size enclosure. Do not order four copies merely to validate the first channel.

## Per-channel signal and high-voltage path

SignalGen command → unchanged Howland → existing output node → monitor J2.1 → two-pole relay → monitor J101 → external dummy load → relay → 100 Ω return shunt → MID

Signal board A uses J1/J3 for channel 1 and J2/J4 for channel 2; board B repeats those pairs for channels 3/4. On each analog output, pin 1 is command, pin 3 is isolated ground/ MID, and pin 2 is the isolated 3.3 V tap left open here. Leave the legacy primary VBUS pins J1.01/J2.01 open.

Boost J1.1/.2 takes isolated 12 V/ HV_BOTTOM. Boost J2.1/.2 feeds splitter J1.1/.2. Splitter J2.1/.2/.3 supplies Howland J1.1/.2/.3 as HV_TOP/ MID/ HV_BOTTOM. Nominal 79.7 V split about MID is approximately ±39.85 V, conventionally the nominal ±40 V supply. These supplies are separate from the requested 30 V port-voltage boundary.

From | To | Function / condition
Monitor power J202.1/.2/.3/.4 | Core J1.1/.2/.3/.4 | +5 V / MID / −5 V / 3.3 V
Existing Howland output node | Core J2.1 | Physical terminal unknown; do not confuse with Howland command input J2
Same-channel MID | Core J2.2 | Return reference
Splitter J2.1/.2/.3 | Core J7.1/.2/.3 | HV_TOP / MID / HV_BOTTOM
Signal analog J3.1 or J4.1 | Core J8.1 and Howland J2.1 | Command monitor is a parallel sense tap
Signal analog J3.3 or J4.3 | Core J8.2, Howland J2.2, splitter MID | Same-channel reference only
Core J101.1 / J101.2 | External 2–5 kΩ dummy load | Load return must go through J101.2; do not bypass the 100 Ω shunt
Core J4 (both pins) | Leave open | No alteration or control connection to Howland E/D

J4 on the monitor stays open. Its optional Howland-enable interface is unused. The first prototype disconnects both external load wires with the relay; it does not disable or modify the Howland amplifier. The monitor measures the external branch. At 5 mA an external 2–5 kΩ resistor requires 10–25 V peak, plus 0.5 V across the added 100 Ω return shunt. These are Ohm’s-law calculations, not measured compliance.

Known theoretical load-regulation issue in the unchanged Howland: the nominal positive-feedback chain is 95.5 kΩ; the ideal balance condition for the existing 100 kΩ input and 500 Ω sense resistance is 99.5 kΩ. With the test load DNP, the ideal low-frequency model predicts 2.134 mA/V into 2 kΩ and 2.463 mA/V into 5 kΩ: about 15.4% more current at the same command. Including the monitor’s 100 Ω return shunt gives approximately 2.143 and 2.476 mA/V. This calculation is independent of the former parallel-load assumption. It is not a measurement or a requested resistor change. Check actual current at both loads early; the unchanged hardware cannot be represented as having proven load-independent current.

## ADC harness: use the revised conditioned fault pin

The ADC board’s 2×7 J202 header is not pin compatible with the monitor’s separate headers. Build the mapped harness below. MID_CH_GND on the ADC is the same channel’s MID_CH. Its PICO_3V3 stays separate from P3V3_CH.

ADC connector | Monitor-core connector | Net
J202.1 | J5.5 | P5_CH
J202.2 | J5.1 | MID_CH
J202.3 | J5.6 | P3V3_CH
J202.4 | J3.1 | MID_CH
J202.5 | J5.2 | I_MON
J202.6 | J5.3 | V_MON
J202.8 | J3.2 | RUN_REQUEST
J202.9 | J3.3 | ARM_EDGE
J202.10 | J3.4 | HEARTBEAT
J202.11 | J6.1 | FAULT_CLEAR_N
J202.12 | J3.6 | INHIBITED

ADC J202.7/.13/.14 are NC. Core J5.4 (4.096 V reference) is unused because the ADC uses internal 2.5 V references. Core J3.5/J5.7 are raw FAULT_N and are not used for this ADC status input. ADC J202.11 takes conditioned FAULT_CLEAR_N from core J6.1; it is a status input, not a reset line to drive. Core J6.2 is MID and J6.3 is P3V3. Preserve the existing SignalGen fault outputs as separate controller inputs; do not tie two status outputs together.

### Primary-side controller interface

ADC J201 pin | Signal | Direction / use
J201.1 | HOST_3V3 | 3.3 V host-side power
J201.2 | HOST_GND | Primary/system reference
J201.3 | HOST_RUN | Host output
J201.4 | HOST_ARM | Host output; fresh arm edge
J201.5 | HOST_HB | Host output heartbeat
J201.6 | HOST_FAULT_OK | Host input; conditioned status
J201.7 | HOST_UART_TX | Host TX into ADC board
J201.8 | HOST_UART_RX | ADC board TX into host RX

The controller’s GPIO selection and firmware belong to the user. All four channel control/telemetry interfaces share only the primary HOST_GND side; their MID references remain separate. Remove any former direct RUN/ARM/heartbeat driver from the core when using this ADC harness to avoid output contention. Program each local Pico with channel wiring disconnected; USB or grounded SWD must not bridge its floating channel domain during operation.

## Fabrication files versus powered-hardware verification

Each ZIP below is a separate bare-PCB design, not an assembled-PCB order. Existing Howland and SignalGen are frozen; the links do not ask you to replace an already completed board. Open full extracted KiCad projects with their matching libraries and .dru files; opening a lone PCB omits library/rule context.

Design | Outline mm | Upload archive | File-check evidence
Shared power | 105×90 | Shared_Power_RevC | 0 ERC / 0 DRC / 0 parity
Monitor power | 100×60 | Monitor_Power_C1 | Final geometry/export checks
ADC / sampler | 125×85 | Channel_ADC_Interface_RevC | 0 ERC / 0 DRC / 0 parity
Monitor core | 180×145 | Channel_Monitor_C1 | 0 ERC / 0 DRC / 0 parity; independent export/geometry audit passed
SignalGen Rev C | 74.676×95.902 | Frozen SignalGen Rev C | Existing checked release; unchanged
Boost 79.7 V | 54.229×26.543 | Boost79V7 | Existing checked bench release
Rail splitter | 50.673×19.431 | Rail splitter | Existing checked bench release

Use 2 copper layers, FR-4, 0.4 mm nominal, 1 oz copper, ENIG, green solder mask, white silkscreen and tented vias. Native thickness is 0.41116 mm; do not choose 1.6 mm. Keep PTH and NPTH drill files when supplied. Follow each board’s assembly notes for tall parts and supports on these thin boards. Connector types differ: mapped harnesses are required; pin order is never inferred from appearance.

Bench checks still required: assembled startup and brownout behavior, actual current/load regulation, rail regulation and thermal rise, monitor/ADC gain and phase over 0.5 Hz–40 kHz, fault-to-relay timing and fuse coordination. The gross-current trip is around 5.7 mA nominal; it is not an independent 5 mA limiter. The voltage trip and relay are not a demonstrated instantaneous 30 V clamp. No powered measurements or patient-use qualification are claimed.

## First-channel sequence and firmware boundary

1. Keep the relay open and the dummy load disconnected while checking supply polarity, same-channel MID wiring and the unpowered Howland output-node continuity. Do not guess an output terminal.
2. Measure the individual power boards with dummy loads first. Verify module input voltage after fuses/wires, then the nominal ±40 V and local ±5 V/ 3.3 V rails.
3. Initialize the unchanged SignalGen’s DAC8830 to a measured near-zero command. Initialize ADS8353 with the documented internal-reference configuration, read it back, allow the specified prototype settling interval and validate samples before LOCAL_READY.
4. With valid heartbeat and near-zero command, use a fresh ARM edge. Test the external 2 kΩ load first, then 5 kΩ, increasing commanded amplitude while measuring current and voltage. Keep normal current within the intended 0–5 mA target.
5. Exercise fault, disconnect, stale telemetry and power-loss cases. Confirm a fault opens the external relay and requires the deliberate recovery/arm sequence. Expand to four channels only after the single chain behaves as expected.

Firmware remains the user’s work: DAC8830 framing, deterministic simultaneous sampling, internal-reference setup, readiness/arm/heartbeat, stale-data detection, calibrated current/voltage conversion and telemetry. The amplitude-envelope ramp target ≤0.1 mA/s implies at least 50 s from 0 to 5 mA. Hardware trip response is a separate behavior. The ADC notes document 600 kSPS and the UART bandwidth limit; raw two-channel sample streaming cannot fit a 1 Mbaud UART.

Battery runtime is still estimated, not established. The optional shared 5 V scenario suggests roughly 31–41 Wh nameplate energy for one hour under stated efficiency/usable-energy assumptions. It does not select or validate a battery. The original four TPS63001/GAPTEC option needs its own measured budget.

## Project notes and scope

Shared power · Monitor core · Monitor power · ADC and firmware interface · Shared-scenario estimates · Exact wiring map

The ordered Howland schematic is retained as source evidence. Older rework proposals are historical and are not instructions for this build. No new PCB order, assembly order, firmware flash or battery purchase has been placed by this work.
