AnishLanka/BrainStimulation/boards/Shared/Monitor_Power_C1/kicad/Peter_Work/preview/Assembly_Top.png

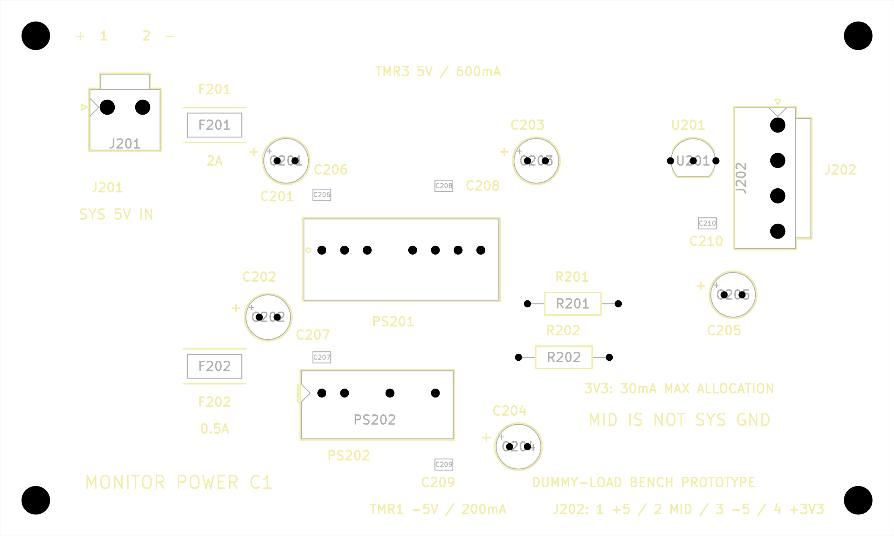
boards/Shared/Monitor_Power_C1/kicad/Peter_Work/preview/Assembly_Top.png
