AnishLanka/BrainStimulation/boards/Shared/Channel_ADC_Interface_RevC/kicad/Peter_Work/ADC_Assembly.pdf

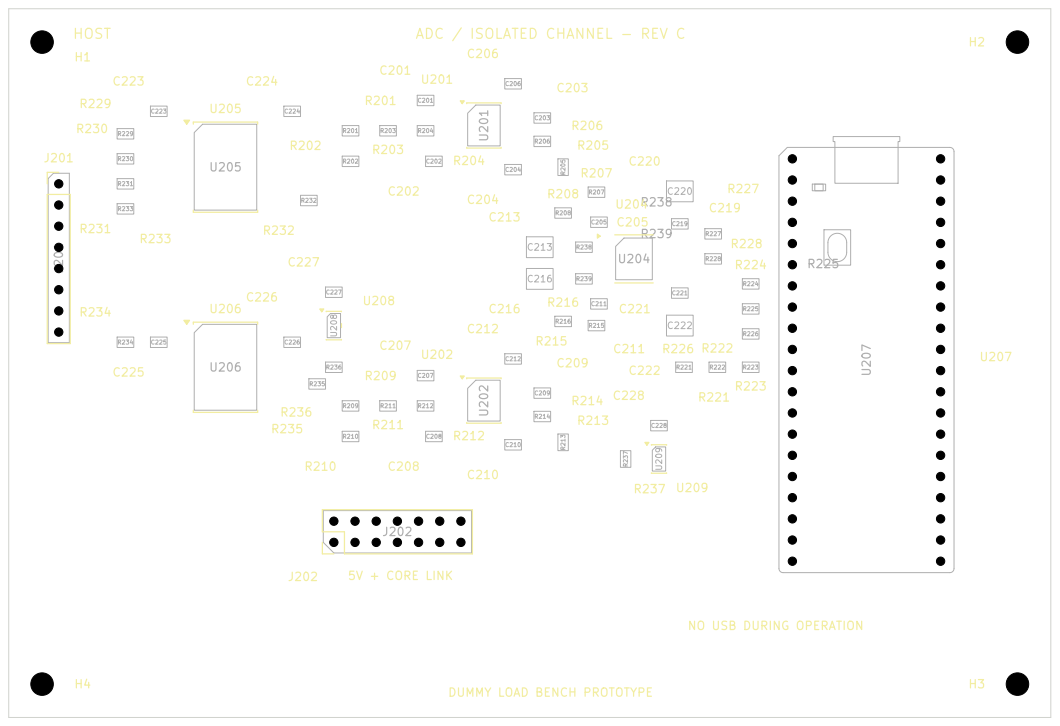
[picture p37: page 1]
