AnishLanka/BrainStimulation/(list of files, drawings)

Other design files:
boards/Boost/kicad/Pyth_Work/PCB_DRC.json
boards/Boost/kicad/Pyth_Work/PCB_Validation.json
boards/Rail_Splitter/kicad/Anish_Work/PCB_DRC.json
boards/Rail_Splitter/kicad/Anish_Work/PCB_Pin_Map.json
boards/Rail_Splitter/kicad/Anish_Work/PCB_Validation.json
boards/Shared/Channel_ADC_Interface_RevC/kicad/Peter_Work/PCB_assembly_labels.json
boards/Shared/Channel_ADC_Interface_RevC/kicad/Peter_Work/PCB_Validation.json
boards/Shared/Channel_Monitor_C1/kicad/Peter_Work/PCB_Validation.json
boards/Shared/Monitor_Power_C1/kicad/Peter_Work/PCB_Pin_Map.json
boards/Shared/Shared_Power_RevC/kicad/Peter_Work/PCB_DRC.json
boards/Shared/Shared_Power_RevC/kicad/Peter_Work/PCB_DRC_Stored_Fill.json
boards/Shared/Shared_Power_RevC/kicad/Peter_Work/PCB_Pin_Map.json
boards/Shared/Shared_Power_RevC/kicad/Peter_Work/PCB_Validation.json
boards/Signal_Generator/kicad/Peter_Work/PCB_assembly_labels.json
boards/Signal_Generator/kicad/Peter_Work/PCB_DFM_Geometry.json
boards/Signal_Generator/kicad/Peter_Work/PCB_domain_nets.json
boards/Signal_Generator/kicad/Peter_Work/PCB_DRC.json
boards/Signal_Generator/kicad/Peter_Work/PCB_Pin_Map.json
boards/Signal_Generator/kicad/Peter_Work/PCB_Silk_Repairs.json
boards/Signal_Generator/kicad/Peter_Work/PCB_Validation.json
