AnishLanka/BrainStimulation/boards/Rail_Splitter/kicad/Anish_Work/RailSplitter_Electrical_Draft.kicad_pcb

## KiCad design boards/Rail_Splitter/kicad/Anish_Work/RailSplitter_Electrical_Draft.kicad_pcb (2026-10-30)

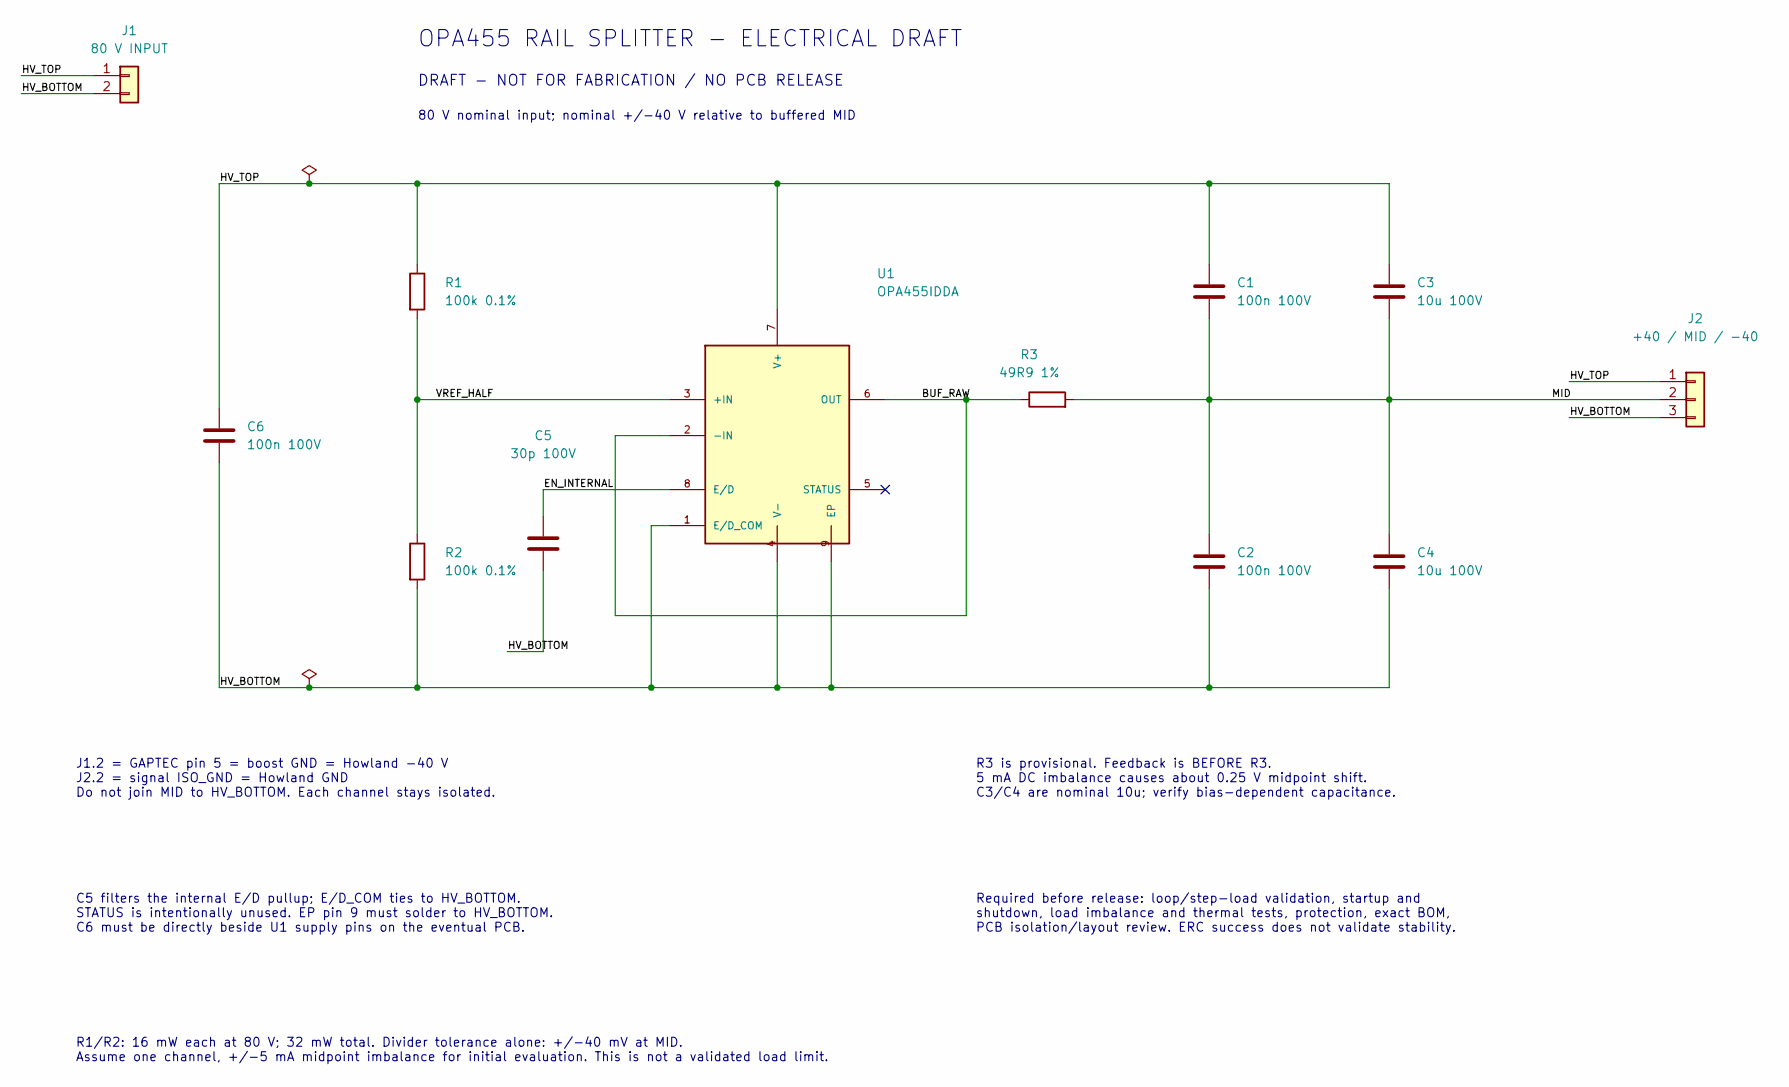
[picture p38: schematic RailSplitter_Electrical_Draft.kicad_sch, OPA455 buffered midpoint - electrical draft]

Parts:
C1, C2, C6: 100n 100V; C0805; MPN C2012X7R2A104K125AA
C3, C4: 10u 100V; C1210; MPN GRM32EC72A106KE05K
C5: 30p 100V; C0603
J1: 80 V INPUT; J2
J2: +40 / MID / -40; J3
R1, R2: 100k 0.1%; R0805; Rating 0.125W minimum; 100V minimum working vo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
R3: 49R9 1%; R0805; Rating 0.125W minimum
U1: OPA455IDDA; OPA455_DDA0008J; MPN OPA455IDDA

Connections:
/BUF_RAW: R3.1, U1.2 (-IN), U1.6 (OUT)
/EN_INTERNAL: C5.1, U1.8 (E/D)
/HV_BOTTOM: C2.2, C4.2, C5.2, C6.2, J1.2, J2.3, R2.2, U1.1 (E/D_COM), U1.4 (V-), U1.9 (EP)
/HV_TOP: C1.1, C3.1, C6.1, J1.1, J2.1, R1.1, U1.7 (V+)
/MID: C1.2, C2.1, C3.2, C4.1, J2.2, R3.2
/VREF_HALF: R1.2, R2.1, U1.3 (+IN)

Notes on the sheet:
OPA455 RAIL SPLITTER - ELECTRICAL DRAFT
DRAFT - NOT FOR FABRICATION / NO PCB RELEASE
80 V nominal input; nominal +/-40 V relative to buffered MID
J1.2 = GAPTEC pin 5 = boost GND = Howland -40 V J2.2 = signal ISO_GND = Howland GND Do not join MID to HV_BOTTOM. Each channel stays isolated.
R3 is provisional. Feedback is BEFORE R3. 5 mA DC imbalance causes about 0.25 V midpoint shift. C3/C4 are nominal 10u; verify bias-dependent capacitance.
C5 filters the internal E/D pullup; E/D_COM ties to HV_BOTTOM. STATUS is intentionally unused. EP pin 9 must solder to HV_BOTTOM. C6 must be directly beside U1 supply pins on the eventual PCB.
Required before release: loop/step-load validation, startup and shutdown, load imbalance and thermal tests, protection, exact BOM, PCB isolation/layout review. ERC success does not validate stability.
R1/R2: 16 mW each at 80 V; 32 mW total. Divider tolerance alone: +/-40 mV at MID. Assume one channel, +/-5 mA midpoint imbalance for initial evaluation. This is not a validated load limit.

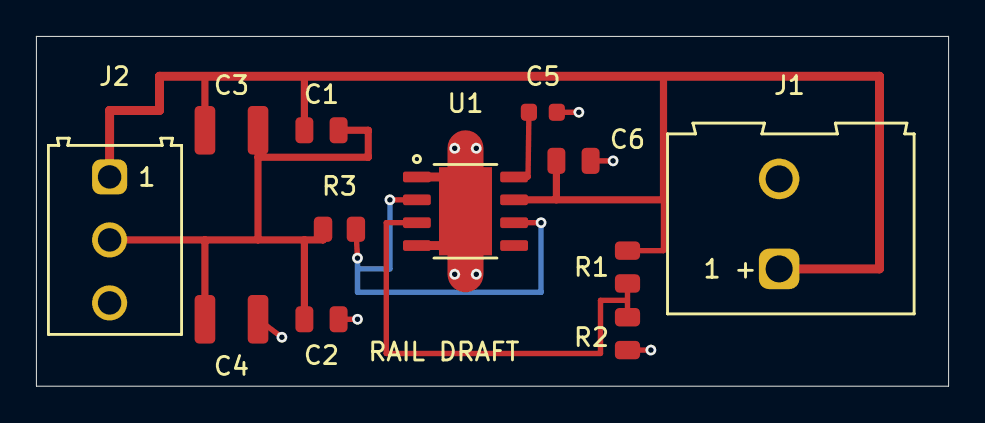
[picture p39: board RailSplitter_Electrical_Draft.kicad_pcb from above]

Board: 2 copper layers, 50.7 x 19.4 mm, 12 parts (0 on the bottom side), 6 nets.
