AnishLanka/BrainStimulation/boards/Shared/Channel_ADC_Interface_RevC/kicad/Peter_Work/Channel_ADC_Interface_RevC.kicad_pcb

## KiCad design boards/Shared/Channel_ADC_Interface_RevC/kicad/Peter_Work/Channel_ADC_Interface_RevC.kicad_pcb (2026-10-30)

Schematic: Channel_ADC_Interface_RevC.kicad_sch, CHANNEL MONITOR — BENCH PROTOTYPE C1

Parts:
C201, C207: 1.2n; C_0805_2012Metric; MPN C0805C122F5GACTU
C202, C204, C208, C210: 1n; C_0805_2012Metric; MPN C0805C102F5GACTU
C203, C209: 6.8n; C_0805_2012Metric; MPN C0805C682F5GACTU
C205, C211: 8.2n; C_0805_2012Metric; MPN C0805C822F5GACTU
C206, C212, C219, C221, C223, C224, C225, C226, C227, C228: 100n; C_0805_2012Metric; MPN C0805C104K4RACTU
C213, C216, C220, C222: 22u; C_1210_3225Metric; MPN GRM32ER71C226KEA8L
J201: HOST_CONTROL_TELEMETRY; PinHeader_1x08_P2.54mm_Vertical; MPN TSW-108-07-G-S
J202: CORE_ADC_CONTROL_LINK; PinHeader_2x07_P2.54mm_Vertical; MPN TSW-107-07-G-D
R201, R202, R209, R210: 2k; R_0805_2012Metric; MPN TNPW08052K00BEEA
R203, R211: 470R; R_0805_2012Metric; MPN TNPW0805470RBEEA
R204, R212: 1.47k; R_0805_2012Metric; MPN TNPW08051K47BEEA
R205, R206, R213, R214: 604R; R_0805_2012Metric; MPN TNPW0805604RBEEA
R207, R208, R215, R216: 10R; R_0805_2012Metric; MPN TNPW080510R0BEEA
R221, R222, R223, R229, R230, R231, R232, R233, R234, R235, R236, R237: 10k; R_0805_2012Metric; MPN TNPW080510K0BEEA
R224, R225, R226, R227, R228: 33R; R_0805_2012Metric; MPN TNPW080533R0BEEA
R238, R239: 0.1R; R_0805_2012Metric; MPN WSL0805R1000FEA
U201, U202: OPA2320; SOIC-8_3.9x4.9mm_P1.27mm; MPN OPA2320AID
U204: ADS8353; TSSOP-16_4.4x5mm_P0.65mm; MPN ADS8353IPW
U205: ISO7741F; SOIC-16W_7.5x10.3mm_P1.27mm; MPN ISO7741FDWR
U206: ISO7721F; SOIC-16W_7.5x10.3mm_P1.27mm; MPN ISO7721FDWR
U207: Raspberry Pi Pico RP2040; RaspberryPi_Pico_Common_THT; MPN SC0915
U208: SN74LVC1G08; SOT-23-5; MPN SN74LVC1G08DBVR
U209: SN74LVC2G17; SOT-23-6; MPN SN74LVC2G17DBVR

Connections:
/ADC_CS_N: R221.2, R224.2, U204.11 (~CS)
/ADC_REF_A: R238.1, U204.3 (REFIO_A)
/ADC_REF_B: R239.1, U204.6 (REFIO_B)
/ADC_SCLK: R222.1, R225.2, U204.12 (SCLK)
/ADC_SDI: R223.1, R226.2, U204.10 (SDI)
/ADC_SDO_A: R227.1, U204.13 (SDO_A)
/ADC_SDO_B: R228.1, U204.14 (SDO_B)
/ARM_EDGE: J202.9, U205.13 (OUTB)
/FAULT_CLEAR_N: J202.11, R237.1, U205.11 (IND), U209.1 (1A)
/HEARTBEAT: J202.10, U205.12 (OUTC)
/HOST_3V3: C223.1, C225.1, J201.1, R234.2, U205.1 (VCC1), U205.7 (EN1), U206.3 (VCC1)
/HOST_ARM: J201.4, R230.1, U205.4 (INB)
/HOST_FAULT_OK: J201.6, R233.1, U205.6 (OUTD)
/HOST_GND: C223.2, C225.2, J201.2, R229.2, R230.2, R231.2, R233.2, U205.2 (GND1), U205.8 (GND1), U206.1 (GND1), U206.7 (GND1)
/HOST_HB: J201.5, R231.1, U205.5 (INC)
/HOST_RUN: J201.3, R229.1, U205.3 (INA)
/HOST_UART_RX: J201.8, U206.4 (OUTA)
/HOST_UART_TX: J201.7, R234.1, U206.5 (INB)
/INHIBITED: J202.12, U209.3 (2A)
/ISOLATED_HOST_RUN: R232.1, U205.14 (OUTA), U208.1 (A)
/I_ADC_N: C205.2, R208.2, U204.2 (AINM_A)
/I_ADC_P: C205.1, R207.2, U204.1 (AINP_A)
/I_F1A: C201.1, R203.2, R204.1
/I_F1B: C202.1, R204.2, U201.3 (INA+)
/I_F2A: C203.1, R205.2, R206.1
/I_F2B: C204.1, R206.2, U201.5 (INB+)
/I_HALF: R201.2, R202.1, R203.1
/I_LP1: C201.2, R205.1, U201.1 (OUTA), U201.2 (INA-)
/I_LP2: C203.2, R207.1, U201.6 (INB-), U201.7 (OUTB)
/I_MON: J202.5, R201.1
/LOCAL_READY: R236.1, U207.10 (GP7), U208.2 (B)
/MID_CH_GND: C202.2, C204.2, C206.2, C208.2, C210.2, C212.2, C213.2, C216.2, C219.2, C220.2, C221.2, C222.2, C224.2, C226.2, C227.2, C228.2, J202.2, J202.4, R202.2, R208.1, R210.2, R216.1, R222.2, R223.2, R232.2, R236.2, R237.2, U201.4 (V-), U202.4 (V-), U204.4 (REFGND_A), U204.5 (REFGND_B), U204.15 (GND), U205.9 (GND2), U205.15 (GND2), U206.9 (GND2), U206.16 (GND2), U207.3 (GND), U207.8 (GND), U207.13 (GND), U207.18 (GND), U207.23 (GND), U207.28 (GND), U207.33 (AGND), U207.38 (GND), U208.3 (GND), U209.2 (GND)
/P3V3_CH: C224.1, C227.1, J202.3, U205.10 (EN2), U205.16 (VCC2), U208.5 (VCC)
/P5_CH: C206.1, C212.1, C219.1, C220.1, J202.1, U201.8 (V+), U202.8 (V+), U204.16 (AVDD), U207.39 (VSYS)
/PICO_3V3: C221.1, C222.1, C226.1, C228.1, R221.1, R235.2, U204.9 (DVDD), U206.14 (VCC2), U207.36 (3V3_OUT), U209.5 (VCC)
/PICO_ADC_CS_N: R224.1, U207.4 (GP2)
/PICO_ADC_SCLK: R225.1, U207.5 (GP3)
/PICO_ADC_SDI: R226.1, U207.6 (GP4)
/PICO_ADC_SDO_A: R227.2, U207.7 (GP5)
/PICO_ADC_SDO_B: R228.2, U207.9 (GP6)
/PICO_FAULT_OK: U207.11 (GP8), U209.6 (1Y)
/PICO_INHIBITED: U207.12 (GP9), U209.4 (2Y)
/PICO_UART_RX: U206.12 (OUTB), U207.2 (GP1)
/PICO_UART_TX: R235.1, U206.13 (INA), U207.1 (GP0)
/REF_A_CAP: C213.1, R238.2
/REF_B_CAP: C216.1, R239.2
/RUN_REQUEST: J202.8, U208.4 (Y)
/V_ADC_N: C211.2, R216.2, U204.7 (AINM_B)
/V_ADC_P: C211.1, R215.2, U204.8 (AINP_B)
/V_F1A: C207.1, R211.2, R212.1
/V_F1B: C208.1, R212.2, U202.3 (INA+)
/V_F2A: C209.1, R213.2, R214.1
/V_F2B: C210.1, R214.2, U202.5 (INB+)
/V_HALF: R209.2, R210.1, R211.1
/V_LP1: C207.2, R213.1, U202.1 (OUTA), U202.2 (INA-)
/V_LP2: C209.2, R215.1, U202.6 (INB-), U202.7 (OUTB)
/V_MON: J202.6, R209.1

Notes on the sheet:
CHANNEL ADC / ISOLATED LOCAL SAMPLER — REV C DUMMY-LOAD BENCH PROTOTYPE
0.5 Hz–40 kHz measurement target. ADS8353 + matched analogue filters + local Pico PIO/DMA + isolated UART and controls.
MID_CH_GND = channel core MID_CH; isolated from HOST_GND. Never parallel PICO_3V3 regulator output with core P3V3_CH.
External supplies through J201/J202 (flags are source declarations, not regulators):
OPA2320AID
TNPW08052K00BEEA
TNPW0805470RBEEA
TNPW08051K47BEEA
C0805C122F5GACTU
C0805C102F5GACTU
TNPW0805604RBEEA
C0805C682F5GACTU
TNPW080510R0BEEA
C0805C822F5GACTU
C0805C104K4RACTU
GRM32ER71C226KEA8L
ADS8353IPW
TNPW080510K0BEEA
TNPW080533R0BEEA
ISO7741FDWR
ISO7721FDWR
SC0915
SN74LVC1G08DBVR
SN74LVC2G17DBVR
TSW-108-07-G-S
TSW-107-07-G-D
WSL0805R1000FEA

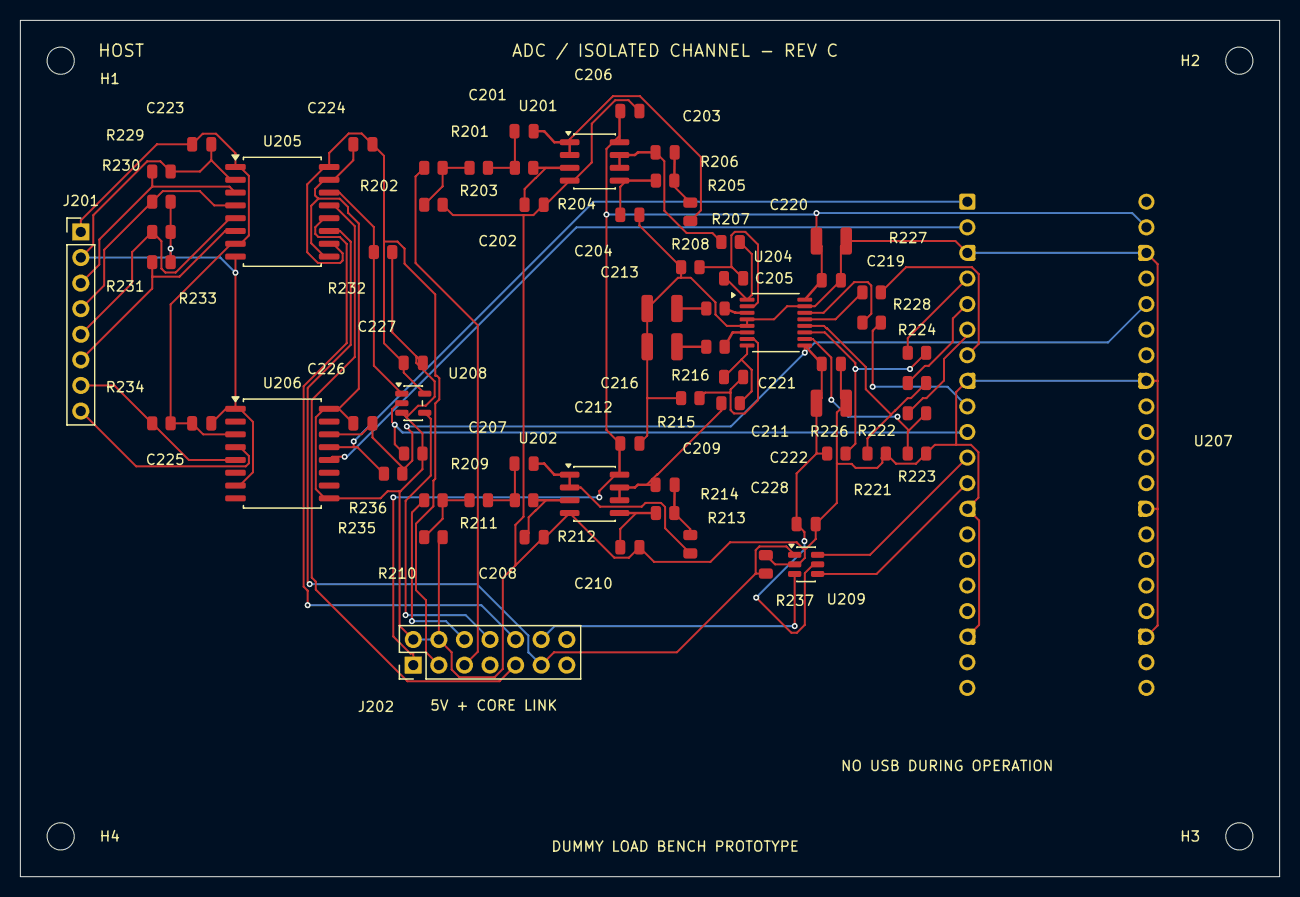
[picture p40: board Channel_ADC_Interface_RevC.kicad_pcb from above]

Board: 2 copper layers, 125.0 x 85.0 mm, 73 parts (0 on the bottom side), 57 nets.

Other parts of the board:
H1, H2, H3, H4: M2.5 plastic support; MountingHole_2.7mm_M2.5
