AnishLanka/BrainStimulation/boards/Shared/Monitor_Power_C1/kicad/Peter_Work/Monitor_Power_C1.kicad_pcb

## KiCad design boards/Shared/Monitor_Power_C1/kicad/Peter_Work/Monitor_Power_C1.kicad_pcb (2026-10-30)

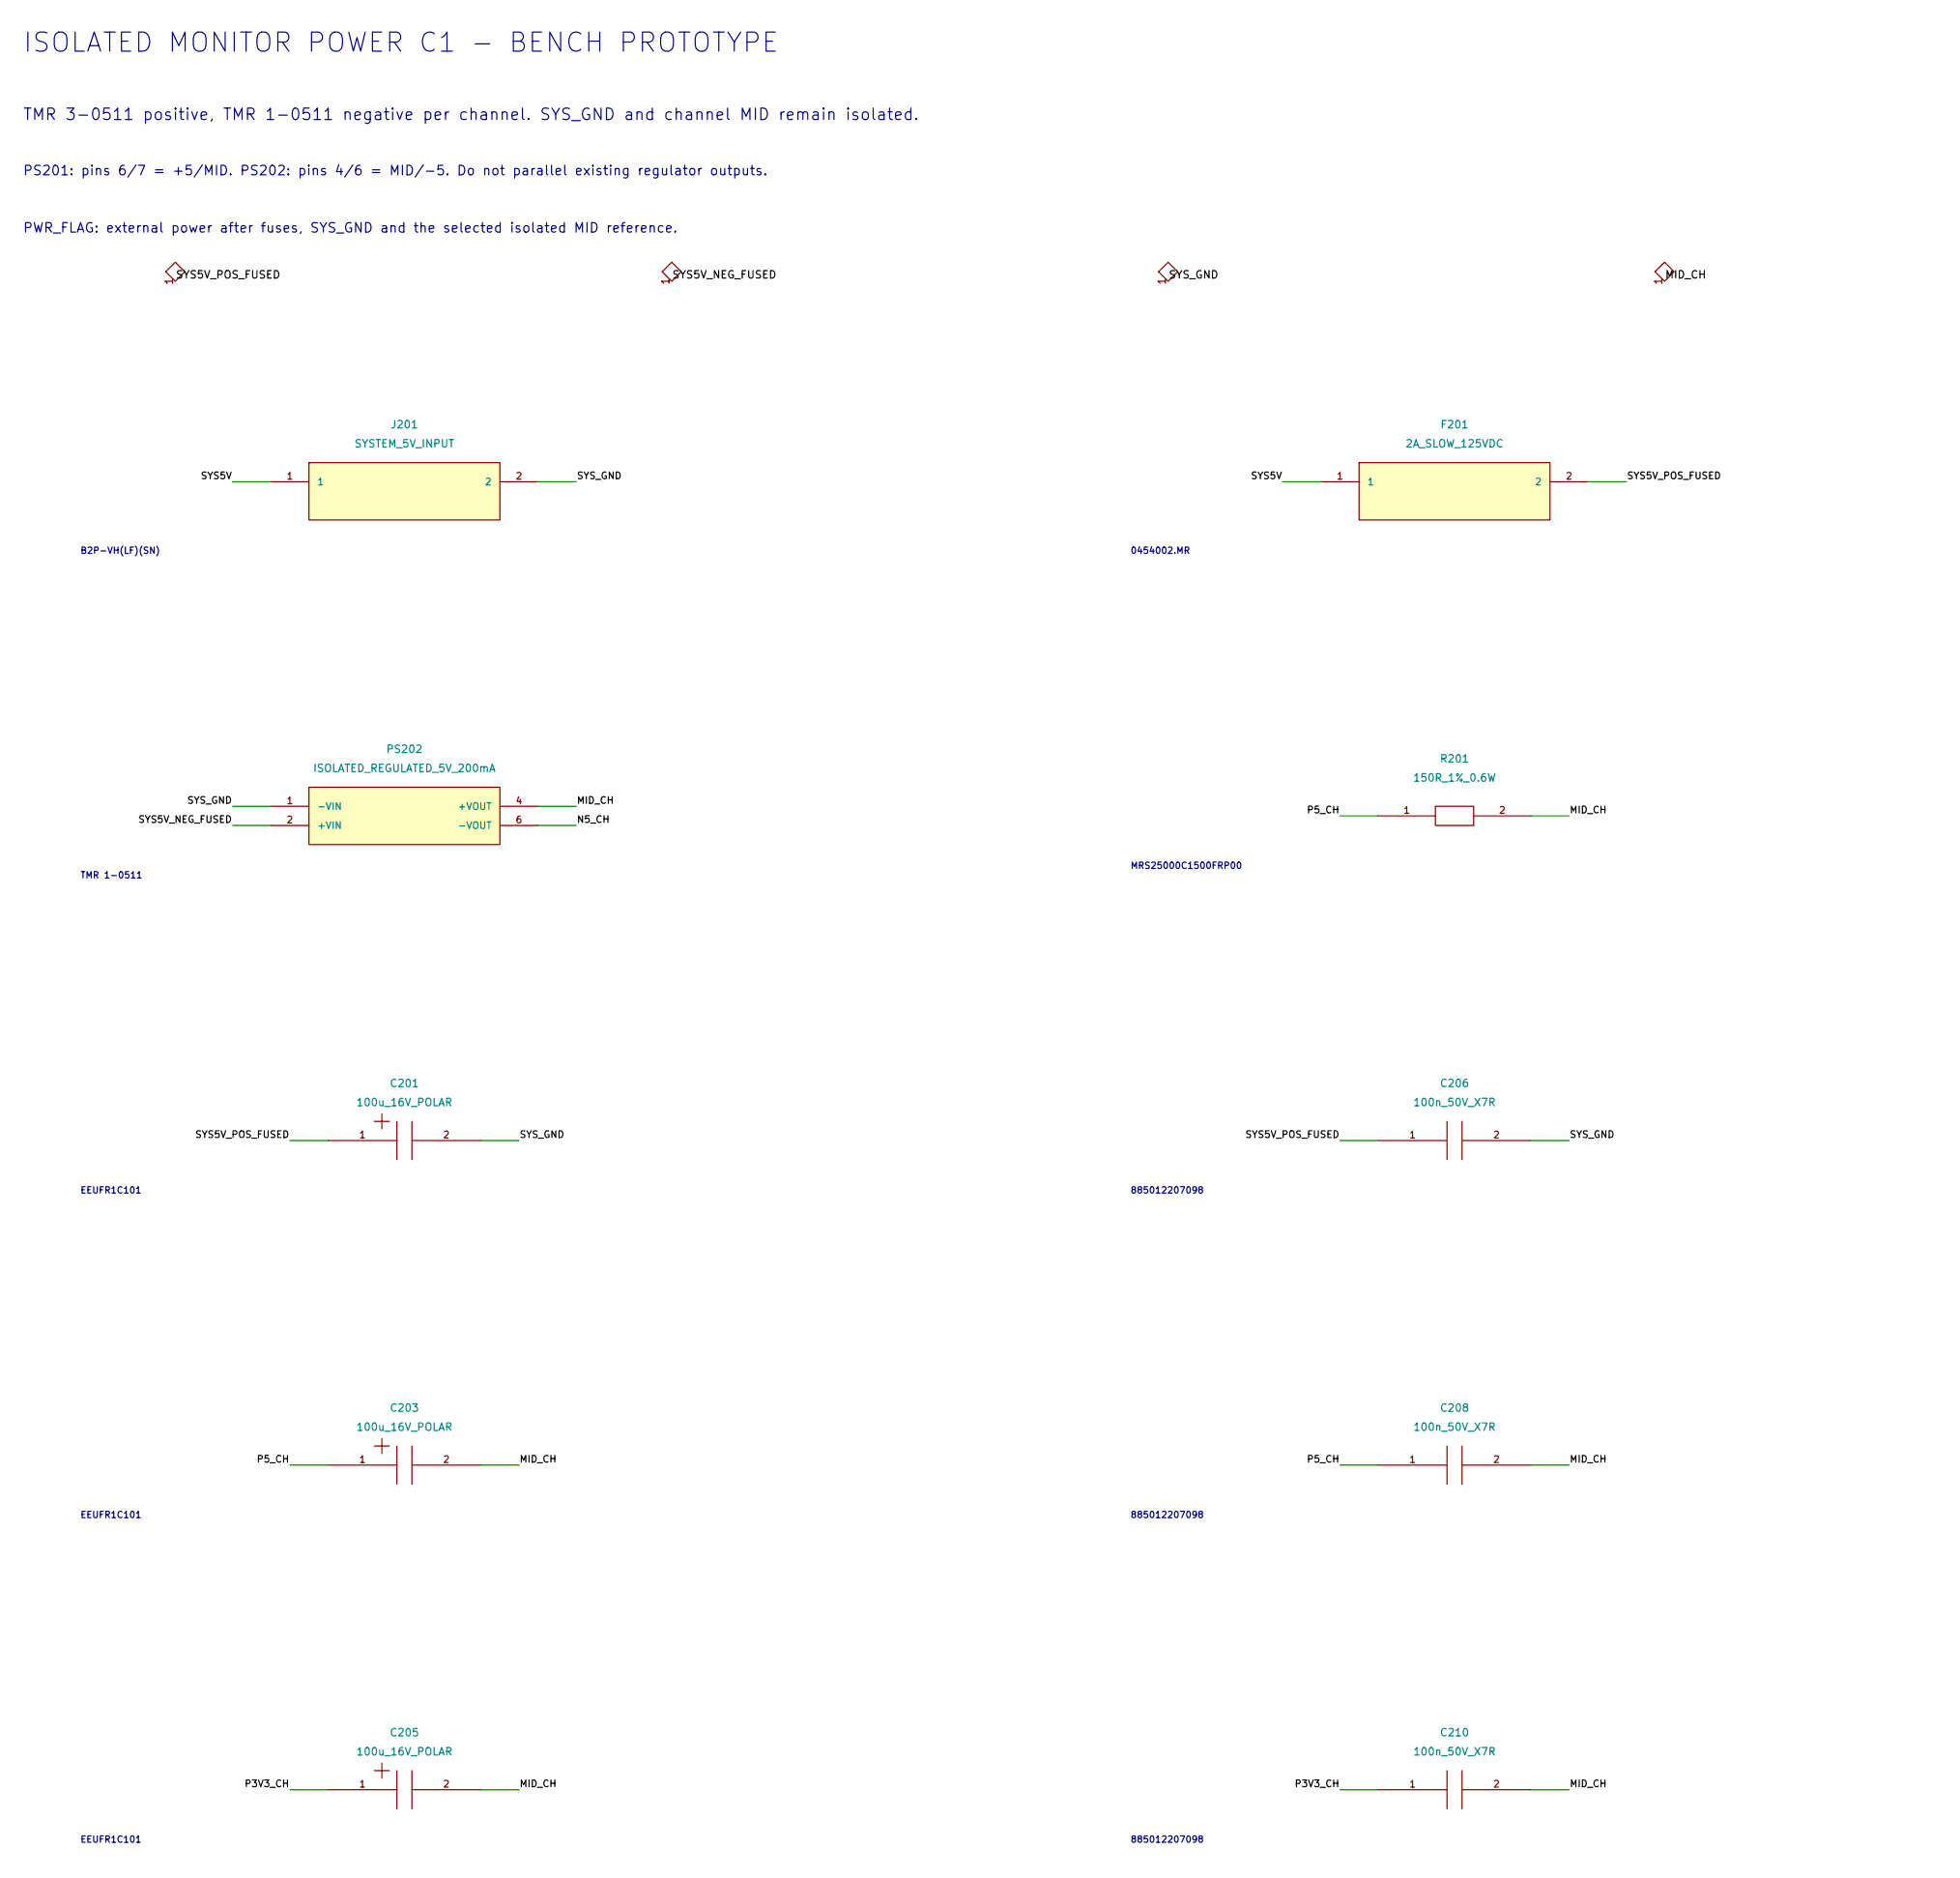
[picture p41: schematic Monitor_Power_C1.kicad_sch, ISOLATED MONITOR POWER - BENCH PROTOTYPE, part in row 1, column 1]

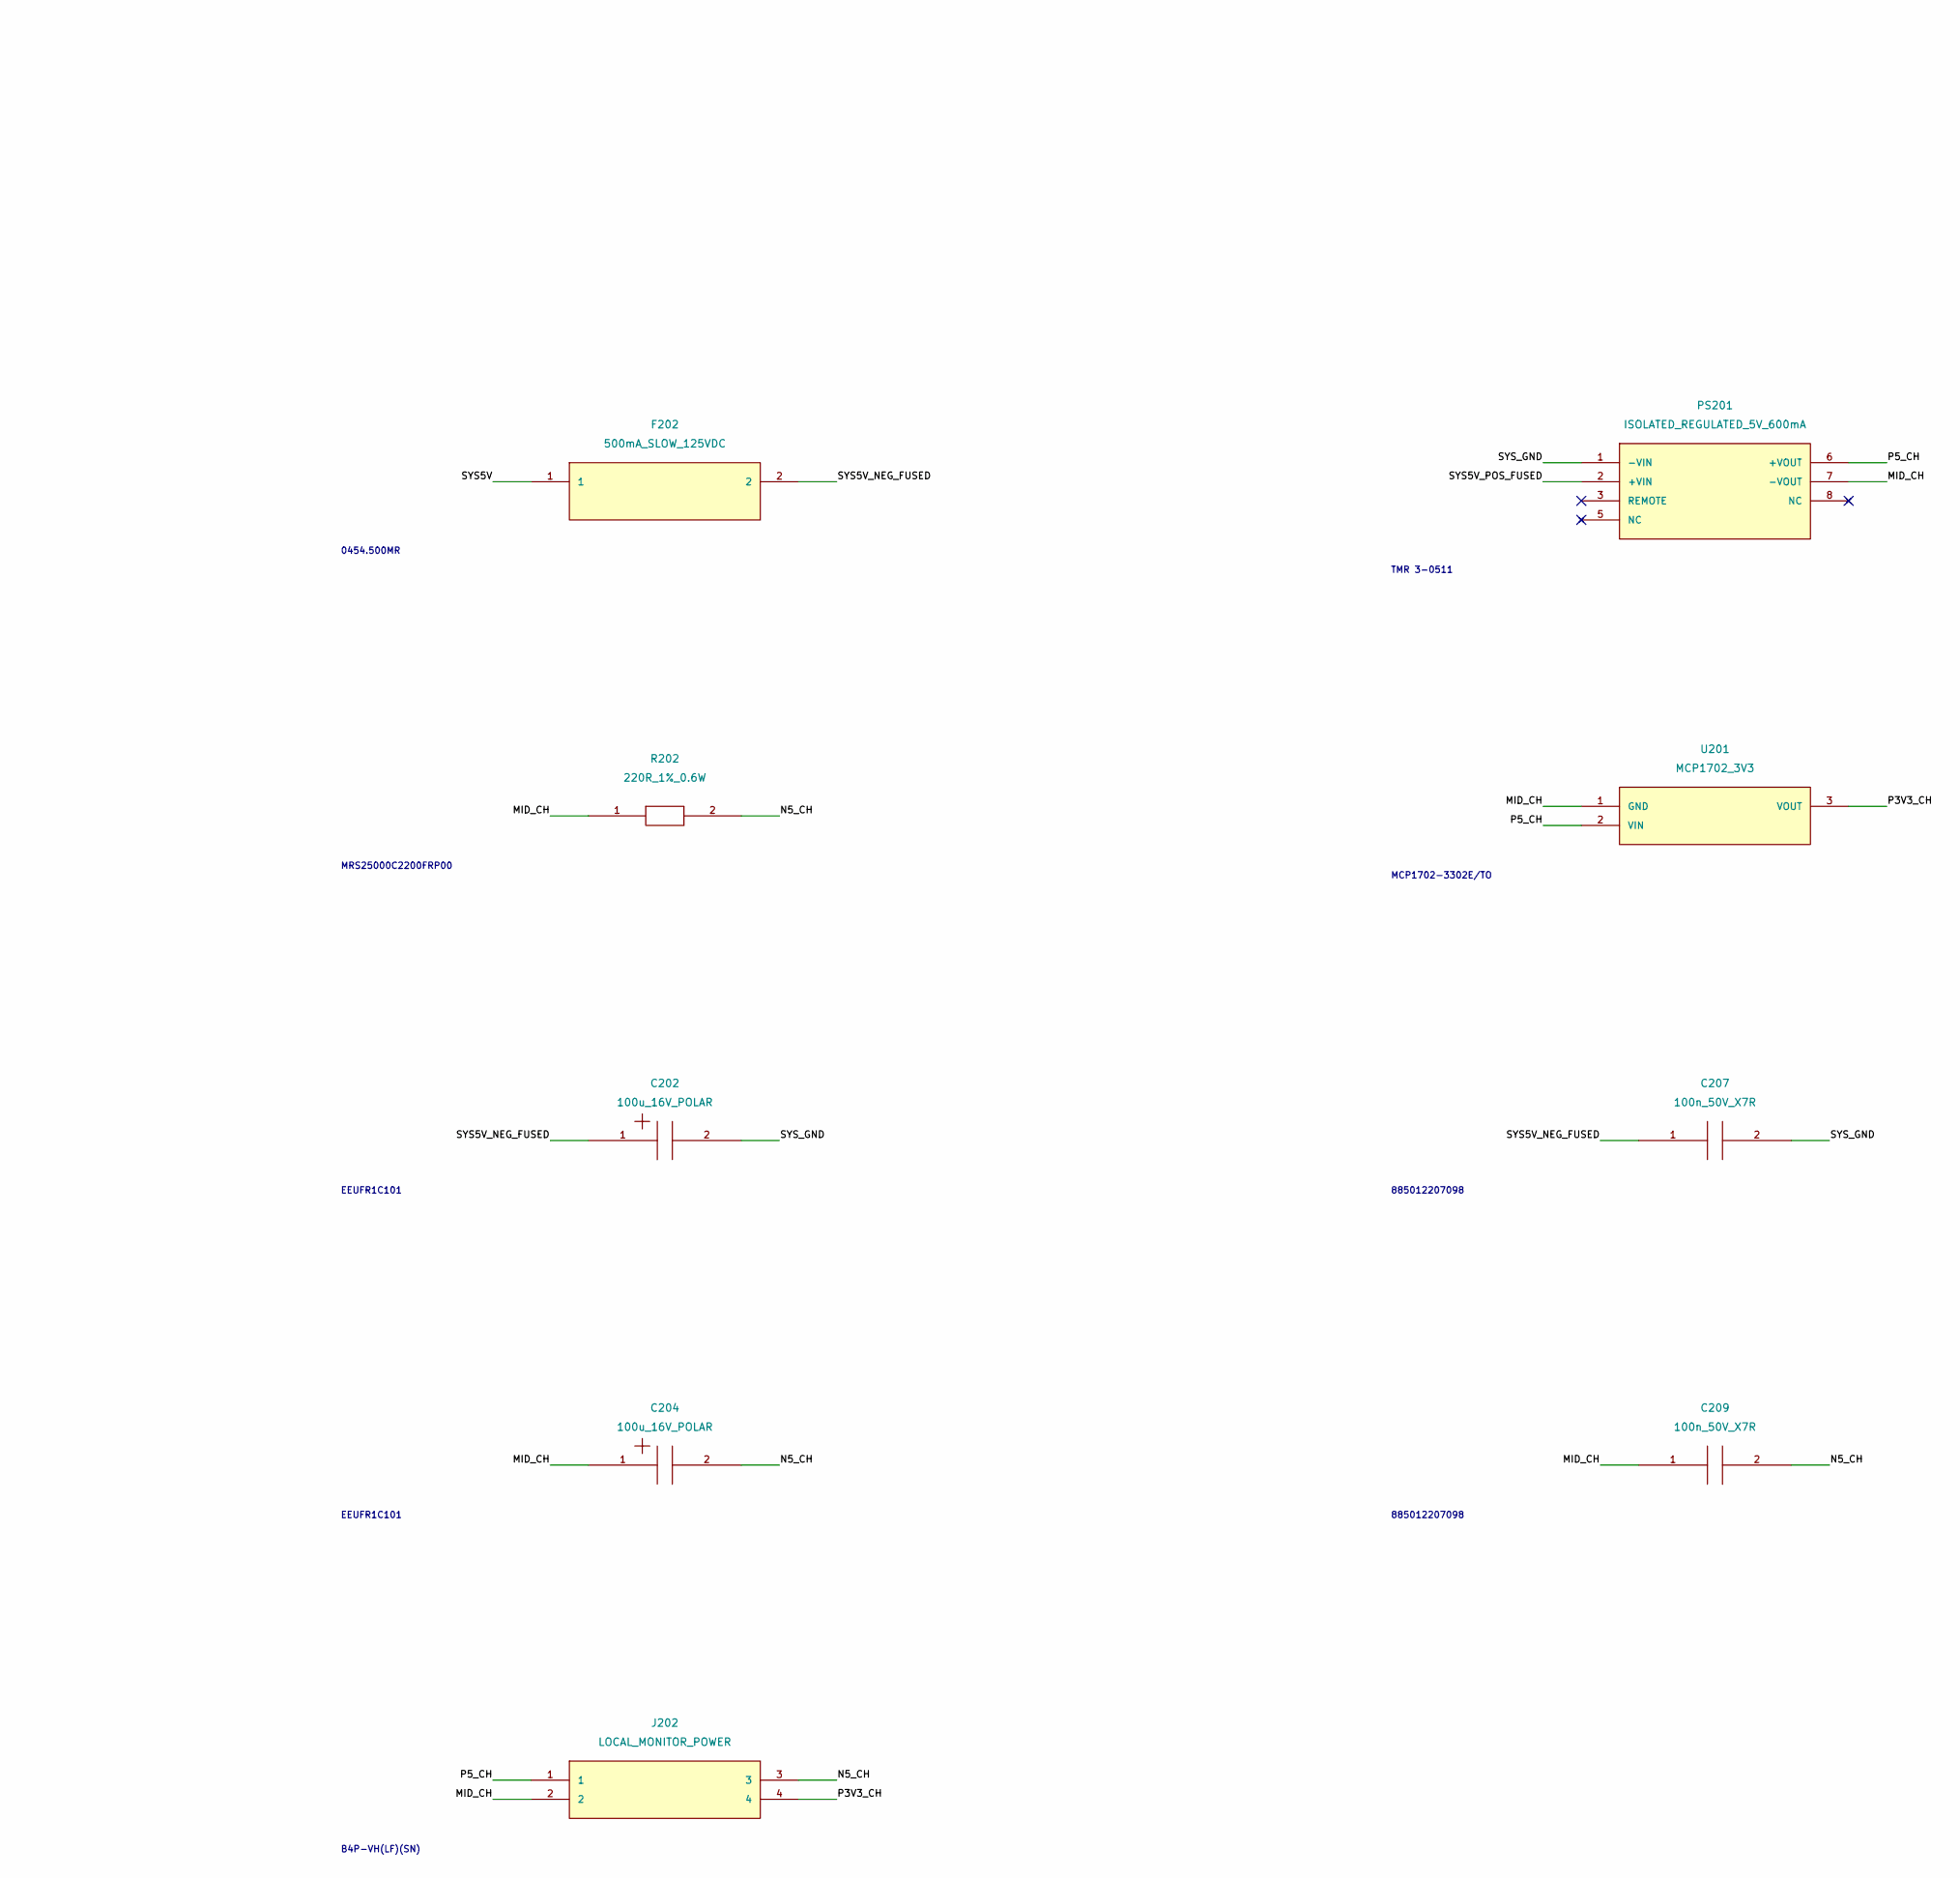
[picture p42: schematic Monitor_Power_C1.kicad_sch, ISOLATED MONITOR POWER - BENCH PROTOTYPE, part in row 1, column 2]

Parts:
C201, C202, C203, C204, C205: 100u_16V_POLAR; Capacitor_THT_CP_Radial_D5.0mm_P2.00mm; MPN EEUFR1C101
C206, C207, C208, C209, C210: 100n_50V_X7R; Capacitor_SMD_C_0805_2012Metric; MPN 885012207098
F201: 2A_SLOW_125VDC; Fuse_Fuse_Littelfuse-NANO2-451_453; MPN 0454002.MR
F202: 500mA_SLOW_125VDC; Fuse_Fuse_Littelfuse-NANO2-451_453; MPN 0454.500MR
J201: SYSTEM_5V_INPUT; Connector_JST_JST_VH_B2P-VH_1x02_P3.96mm_Vertical; MPN B2P-VH(LF)(SN)
J202: LOCAL_MONITOR_POWER; Connector_JST_JST_VH_B4P-VH_1x04_P3.96mm_Vertical; MPN B4P-VH(LF)(SN)
PS201: ISOLATED_REGULATED_5V_600mA; ProtectionLocal_TRACO_TMR3_SIP8_Single; MPN TMR 3-0511
PS202: ISOLATED_REGULATED_5V_200mA; Converter_DCDC_Converter_DCDC_TRACO_TMR-1-xxxx_Single_THT; MPN TMR 1-0511
R201: 150R_1%_0.6W; Resistor_THT_R_Axial_DIN0207_L6.3mm_D2.5mm_P10.16mm_Horizon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; MPN MRS25000C1500FRP00
R202: 220R_1%_0.6W; Resistor_THT_R_Axial_DIN0207_L6.3mm_D2.5mm_P10.16mm_Horizon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; MPN MRS25000C2200FRP00
U201: MCP1702_3V3; Package_TO_SOT_THT_TO-92_Inline_Wide; MPN MCP1702-3302E/TO

Connections:
/MID_CH: C203.2, C204.1, C205.2, C208.2, C209.1, C210.2, J202.2, PS201.7 (-VOUT), PS202.4 (+VOUT), R201.2, R202.1, U201.1 (GND)
/N5_CH: C204.2, C209.2, J202.3, PS202.6 (-VOUT), R202.2
/P3V3_CH: C205.1, C210.1, J202.4, U201.3 (VOUT)
/P5_CH: C203.1, C208.1, J202.1, PS201.6 (+VOUT), R201.1, U201.2 (VIN)
/SYS5V: F201.1, F202.1, J201.1
/SYS5V_NEG_FUSED: C202.1, C207.1, F202.2, PS202.2 (+VIN)
/SYS5V_POS_FUSED: C201.1, C206.1, F201.2, PS201.2 (+VIN)
/SYS_GND: C201.2, C202.2, C206.2, C207.2, J201.2, PS201.1 (-VIN), PS202.1 (-VIN)

Notes on the sheet:
ISOLATED MONITOR POWER C1 - BENCH PROTOTYPE
TMR 3-0511 positive, TMR 1-0511 negative per channel. SYS_GND and channel MID remain isolated.
PS201: pins 6/7 = +5/MID. PS202: pins 4/6 = MID/-5. Do not parallel existing regulator outputs.
PWR_FLAG: external power after fuses, SYS_GND and the selected isolated MID reference.
B2P-VH(LF)(SN)
0454002.MR
0454.500MR
TMR 3-0511
TMR 1-0511
MRS25000C1500FRP00
MRS25000C2200FRP00
MCP1702-3302E/TO
EEUFR1C101
885012207098
B4P-VH(LF)(SN)

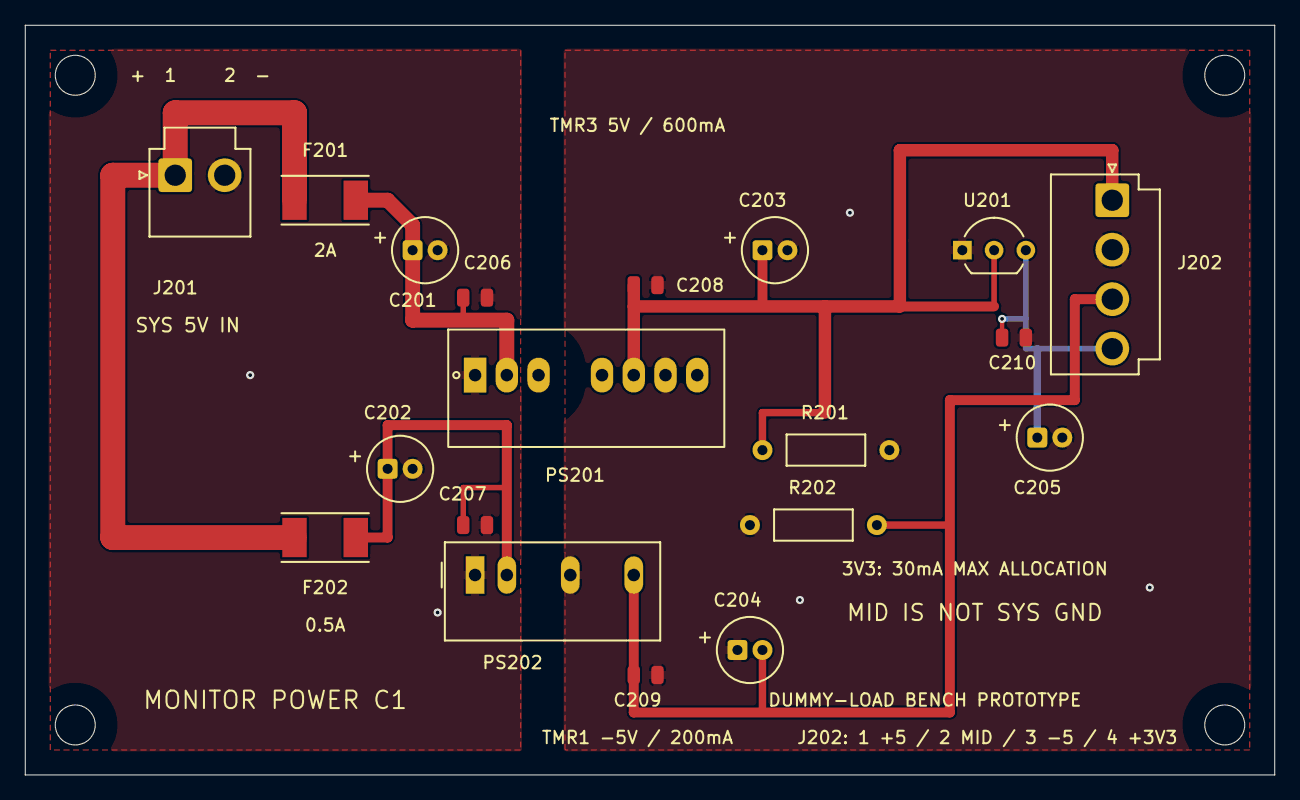
[picture p43: board Monitor_Power_C1.kicad_pcb from above]

Board: 2 copper layers, 100.0 x 60.0 mm, 23 parts (0 on the bottom side), 8 nets.

Other parts of the board:
H1, H2, H3, H4: M3_NPTH
