AnishLanka/BrainStimulation/boards/Shared/Channel_Monitor_C1/kicad/Peter_Work/Channel_Monitor_C1.kicad_pcb

## KiCad design boards/Shared/Channel_Monitor_C1/kicad/Peter_Work/Channel_Monitor_C1.kicad_pcb (2026-10-30)

Schematic: Channel_Monitor_C1.kicad_sch, CHANNEL MONITOR — BENCH PROTOTYPE C1

Parts:
C1, C2, C3, C4, C5, C6, C7, C8, C9, C10, C14, C15, C16, C17, C18, C19: 100n; C_0805_2012Metric; MPN 885012207098
C11, C12: 1u; C_0805_2012Metric; MPN 885012207078
C13: 22u 25V X5R; C_0805_2012Metric; MPN C2012X5R1E226M125AC
C101, C102, C104: 100n50V; C_0805_2012Metric; MPN 885012207098
C103: 1u25V; C_0805_2012Metric; MPN 885382207003
D1: BAV199; SOT-23; MPN BAV199,215
D101: SMAJ12A_COIL_CLAMP; D_SMA; MPN SMAJ12A-E3/61
J1: ISOLATED_LOCAL_POWER; PinHeader_1x04_P2.54mm_Vertical; MPN TSW-104-07-G-S
J2: HOWLAND_OUTPUT_INPUT; PinHeader_1x02_P2.54mm_Vertical; MPN TSW-102-07-G-S
J3: ISOLATED_CONTROL; PinHeader_1x06_P2.54mm_Vertical; MPN TSW-106-07-G-S
J4: HOWLAND_ENABLE; PinHeader_1x02_P2.54mm_Vertical; MPN TSW-102-07-G-S
J5: SIMULTANEOUS_ADC_MODULE; PinHeader_1x07_P2.54mm_Vertical; MPN TSW-107-07-G-S
J6: FAULT_STATUS; PinHeader_1x03_P2.54mm_Vertical; MPN TSW-103-07-G-S
J7: HV_RAIL_MONITOR; PinHeader_1x03_P2.54mm_Vertical; MPN TSW-103-07-G-S
J8: COMMAND_MONITOR; PinHeader_1x02_P2.54mm_Vertical; MPN TSW-102-07-G-S
J101: EXTERNAL_DUMMY_LOAD; PinHeader_1x02_P2.54mm_Vertical; MPN TSW-102-07-G-S
K101: DPST_NO_5V; Pickering104_Package4_6Pin_P5.08; MPN 104-2-A-5/2
Q101: AO3400A; SOT-23; MPN AO3400A
R1: 100R 0.1%; R_1206_3216Metric; MPN TNPW1206100RBEEA
R2, R3: 20k; R_0805_2012Metric; MPN TNPW080520K0BEEA
R4, R6, R20, R21, R22, R23, R24, R26, R30, R32, R34, R35, R54, R56, R58, R60, R65, R67, R68, R69, R73, R75, R76, R77, R78, R102, R103: 10k; R_0805_2012Metric; MPN TNPW080510K0BEEA
R5, R7: 32.4k; R_0805_2012Metric; MPN TNPW080532K4BEEA
R8, R9, R11, R12, R43, R44, R45, R46, R48, R49, R50, R51, R61, R62, R63, R64: 499k; R_0805_2012Metric; MPN TNPW0805499KBEEA
R10, R13, R47, R52, R79: 49.9k; R_0805_2012Metric; MPN TNPW080549K9BEEA
R14, R16: 5.11k; R_0805_2012Metric; MPN TNPW08055K11BEEA
R15: 93.1k; R_0805_2012Metric; MPN TNPW080593K1BEEA
R17, R19: 15.6k; R_0805_2012Metric; MPN TNPW080515K6BEEA
R18: 71.5k; R_0805_2012Metric; MPN TNPW080571K5BEEA
R25, R37, R39: 1k; R_0805_2012Metric; MPN TNPW08051K00BEEA
R27, R71: 100k; R_0805_2012Metric; MPN TNPW0805100KBEEA
R28: 200k; R_0805_2012Metric; MPN TNPW0805200KBEEA
R29: 24.9k; R_0805_2012Metric; MPN TNPW080524K9BEEA
R31, R57: 35.7k; R_0805_2012Metric; MPN TNPW080535K7BEEA
R33: 88.7k; R_0805_2012Metric; MPN TNPW080588K7BEEA
R36: 22.1k 1% 0.75W; R_2010_5025Metric; MPN CRCW201022K1FKEF
R38, R40: 249R; R_0805_2012Metric; MPN TNPW0805249RBEEA
R41, R42: 470R 1% 0.25W; R_1206_3216Metric; MPN CRCW1206470RFKEA
R53: 4.42k; R_0805_2012Metric; MPN TNPW08054K42BEEA
R55: 3.24k; R_0805_2012Metric; MPN TNPW08053K24BEEA
R59: 25.5k; R_0805_2012Metric; MPN TNPW080525K5BEEA
R66: 10.8k; R_0805_2012Metric; MPN TNPW080510K8BEEA
R70: 300k; R_0805_2012Metric; MPN TNPW0805300KBEEA
R72: 16.9k; R_0805_2012Metric; MPN TNPW080516K9BEEA
R74: 16.5k; R_0805_2012Metric; MPN TNPW080516K5BEEA
R101: 100R; R_0805_2012Metric; MPN TNPW0805100RBEEA
TP1: I_MON; TestPoint_Pad_D1.0mm; MPN PCB_FEATURE_NO_COMPONENT
TP2: V_MON; TestPoint_Pad_D1.0mm; MPN PCB_FEATURE_NO_COMPONENT
TP3: FAULT_N; TestPoint_Pad_D1.0mm; MPN PCB_FEATURE_NO_COMPONENT
TP4: BIAS_2V048; TestPoint_Pad_D1.0mm; MPN PCB_FEATURE_NO_COMPONENT
U1, U2: OPA2192; SOIC-8_3.9x4.9mm_P1.27mm; MPN OPA2192ID
U3: REF5040A; SOIC-8_3.9x4.9mm_P1.27mm; MPN REF5040AID
U4, U11: TLV1704; TSSOP-14_4.4x5mm_P0.65mm; MPN TLV1704IPWR
U5: SN74LVC1G74; VSSOP-8_2.3x2mm_P0.5mm; MPN SN74LVC1G74DCUR
U6: TPS3808G33; SOT-23-6; MPN TPS3808G33DBVR
U7: TPS3808G50; SOT-23-6; MPN TPS3808G50DBVR
U8, U12, U13: TLV1702; VSSOP-8_3x3mm_P0.65mm; MPN TLV1702IDGKR
U9, U14, U15, U101: TPS3808G01; SOT-23-6; MPN TPS3808G01DBVR
U10: TPS3431; Texas_DRB0008A; MPN TPS3431SDRBR
U16: SN74LVC2G17; SOT-23-6; MPN SN74LVC2G17DBVR
U102: SN74LVC1G08; SOT-23-5; MPN SN74LVC1G08DBVR
U103: SN74LVC1G17; SOT-23-5; MPN SN74LVC1G17DBVR

Connections:
/AMP_ARMED: R25.1, U102.4 (Y)
/ARMED: R35.1, R101.1, U5.5 (Q), U101.3 (MR_N), U102.1 (A)
/ARM_EDGE: J3.3, R21.1, U5.1 (CLK)
/BALN_MID: R63.2, R64.1
/BALP_MID: R61.2, R62.1
/BIAS_2V048: R5.1, R10.1, R47.1, R52.1, R65.1, R71.1, TP4.1 (1_1), U1.6 (INB-), U1.7 (OUTB)
/BIAS_DIV: R2.2, R3.1, U1.5 (INB+)
/CMD_FROM_SIGNAL: J8.1, R70.1
/CMD_HIGH: R74.2, R75.1, U13.5 (IN2+)
/CMD_LOW: R72.2, R73.1, U13.2 (IN1-)
/CMD_SENSE: R70.2, R71.2, U13.3 (IN1+), U13.6 (IN2-)
/COIL_GATE: Q101.1 (G), R101.2, R102.1
/COIL_LOW: D101.1 (K), K101.4 (COIL-), Q101.3 (D)
/CWD: R24.2, U10.2 (CWD)
/EXTERNAL_N: J101.2, K101.5 (CONTACT_B_OUT)
/EXTERNAL_P: J101.1, K101.6 (CONTACT_A_OUT)
/FAULT_CLEAR_N: J6.1, U5.6 (~CLR), U16.6 (1Y)
/FAULT_COND_N: R78.2, U15.1 (~RESET), U16.1 (1A)
/FAULT_N: J3.5, J5.7, R20.2, TP3.1 (1_1), U4.1 (OUT2), U4.2 (OUT1), U4.13 (OUT4), U4.14 (OUT3), U6.1 (~RESET), U7.1 (~RESET), U8.1 (OUT1), U8.7 (OUT2), U9.1 (~RESET), U10.7 (~WDO), U10.8 (ENOUT), U11.1 (OUT2), U11.2 (OUT1), U11.13 (OUT4), U11.14 (OUT3), U12.1 (OUT1), U12.7 (OUT2), U15.3 (~MR)
/HEARTBEAT: J3.4, R23.1, U10.6 (WDI)
/HVN_DIV1: R48.2, R49.1
/HVN_DIV2: R49.2, R50.1
/HVN_DIV3: R50.2, R51.1
/HVN_HIGH: R59.2, R60.1, U11.11 (IN4+)
/HVN_LOW: R57.2, R58.1, U11.8 (IN3-)
/HVN_SENSE: R51.2, R52.2, U11.9 (IN3+), U11.10 (IN4-)
/HVP_DIV1: R43.2, R44.1
/HVP_DIV2: R44.2, R45.1
/HVP_DIV3: R45.2, R46.1
/HVP_HIGH: R55.2, R56.1, U11.7 (IN2+)
/HVP_LOW: R53.2, R54.1, U11.4 (IN1-)
/HVP_SENSE: R46.2, R47.2, U11.5 (IN1+), U11.6 (IN2-)
/HV_BOTTOM: J7.3, R48.1, R63.1
/HV_TOP: J7.1, R43.1, R61.1
/INHIBITED: J3.6, U5.3 (~Q)
/INTERNAL_N: K101.2 (CONTACT_B_IN), R1.1, R36.1
/INTERNAL_P: J2.1, K101.1 (CONTACT_A_IN), R8.1
/I_HIGH: R15.2, R16.1, U4.7 (IN2+)
/I_LOW: R14.2, R15.1, U4.4 (IN1-)
/I_MINUS: R6.2, R7.2, U2.2 (INA-)
/I_MON: J5.2, R7.1, TP1.1 (1_1), U2.1 (OUTA), U4.5 (IN1+), U4.6 (IN2-)
/I_PLUS: R4.2, R5.2, U2.3 (INA+)
/MID_BAL_HIGH: R68.2, R69.1, U12.5 (IN2+)
/MID_BAL_LOW: R66.2, R67.1, U12.2 (IN1-)
/MID_BAL_SENSE: R62.2, R64.2, R65.2, U12.3 (IN1+), U12.6 (IN2-)
/MID_CH: C1.2, C2.2, C3.2, C4.2, C5.2, C6.2, C7.2, C8.2, C9.2, C10.2, C11.2, C12.2, C13.2, C14.2, C15.2, C16.2, C17.2, C18.2, C19.2, C101.2, C102.2, C103.2, C104.2, D101.2 (A), J1.2, J2.2, J3.1, J4.2, J5.1, J6.2, J7.2, J8.2, Q101.2 (S), R1.2, R3.2, R6.1, R14.1, R17.1, R21.2, R22.2, R23.2, R26.2, R30.2, R32.2, R34.2, R35.2, R38.2, R40.1, R41.2, R42.1, R54.2, R56.2, R58.2, R60.2, R67.2, R69.2, R73.2, R75.2, R102.2, U2.4 (V-), U3.4 (GND), U4.12 (V-), U5.4 (GND), U6.2 (GND), U7.2 (GND), U8.4 (V-), U9.2 (GND), U10.4 (GND), U10.9 (EP), U11.12 (V-), U12.4 (V-), U13.4 (V-), U14.2 (GND), U15.2 (GND), U16.2 (GND), U101.2 (GND), U102.3 (GND), U103.3 (GND)
/N5_CH: C2.1, J1.3, R28.2, R39.2, R42.2, U1.4 (V-)
/N5_HIGH: R29.2, R30.1, U8.3 (IN1+)
/N5_LOW: R31.2, R32.1, U8.6 (IN2-)
/N5_SENSE: R27.2, R28.1, U8.2 (IN1-), U8.5 (IN2+)
/N_CLAMP: D1.1 (A1), R39.1, R40.2
/OPA_ENABLE: J4.1, R25.2, R26.1
/P3V3_CH: C5.1, C6.1, C7.1, C9.1, C10.1, C17.1, C18.1, C19.1, C101.1, C102.1, C104.1, J1.4, J5.6, J6.3, R20.1, R24.1, R76.1, R77.1, R78.1, R79.1, R103.1, U5.7 (~PRE), U5.8 (VCC), U6.3 (~MR), U6.5 (SENSE), U6.6 (VDD), U7.3 (~MR), U7.6 (VDD), U9.3 (~MR), U9.6 (VDD), U10.1 (VDD), U10.5 (SET1), U14.5 (SENSE), U14.6 (VDD), U15.5 (SENSE), U15.6 (VDD), U16.5 (VCC), U101.5 (SENSE), U101.6 (VDD), U102.5 (VCC), U103.5 (VCC)
/P5_CH: C1.1, C3.1, C4.1, C8.1, C11.1, C14.1, C15.1, C16.1, C103.1, J1.1, J5.5, K101.3 (COIL+), R37.1, R41.1, U1.8 (V+), U2.8 (V+), U3.2 (VIN), U4.3 (V+), U7.5 (SENSE), U8.8 (V+), U11.3 (V+), U12.8 (V+), U13.8 (V+)
/P_CLAMP: D1.2 (K2), R37.2, R38.1
/REF_4V096: C13.1, J5.4, R2.1, R16.2, R19.2, R27.1, R29.1, R31.1, R33.1, R53.1, R55.1, R57.1, R59.1, R66.1, R68.1, R72.1, R74.1, U3.6 (VOUT)
/REF_NR: C12.1, U3.5 (TRIM/NR)
/REF_SENSE: R33.2, R34.1, U9.5 (SENSE)
/RELAY_DELAY_N: R103.2, U101.1 (RESET_N), U103.2 (A)
/RELAY_SETTLED: U102.2 (B), U103.4 (Y)
/RETURN_BUF: R4.1, R11.1, U1.1 (OUTA), U1.2 (INA-)
/RETURN_PROTECTED: D1.3 (K1_A2), R36.2, U1.3 (INA+)
/RUN_REQUEST: J3.2, R22.1, U10.3 (EN)
/V_HIGH: R18.2, R19.1, U4.11 (IN4+)
/V_LOW: R17.2, R18.1, U4.8 (IN3-)
/V_MINUS: R12.2, R13.2, U2.6 (INB-)
/V_MON: J5.3, R13.1, TP2.1 (1_1), U2.7 (OUTB), U4.9 (IN3+), U4.10 (IN4-)
/V_NEG_MID: R11.2, R12.1
/V_PLUS: R9.2, R10.2, U2.5 (INB+)
/V_POS_MID: R8.2, R9.1
/ZERO_ARM_OK: U5.2 (D), U16.4 (2Y)
/ZERO_CT: R79.2, U14.4 (CT)
/ZERO_QUAL_N: R77.2, U14.1 (~RESET), U16.3 (2A)
/ZERO_RAW: R76.2, U13.1 (OUT1), U13.7 (OUT2), U14.3 (~MR)

Notes on the sheet:
CHANNEL MONITOR C1 — BENCH PROTOTYPE
Single isolated domain. 0.5 Hz–40 kHz target; nominal +/-40 V Howland supplies. Monitor supply uses separately regulated +/-5 V and 3.3 V.
Howland remains unchanged. This monitor senses the external branch and opens a relay. J4 enable is optional; no instantaneous port limit is claimed.
J1 external supply annotations:
OPA2192ID
REF5040AID
TLV1704IPWR
SN74LVC1G74DCUR
TPS3808G33DBVR
TPS3808G50DBVR
TLV1702IDGKR
TPS3808G01DBVR
TPS3431SDRBR
TNPW1206100RBEEA
TNPW080520K0BEEA
TNPW080510K0BEEA
TNPW080532K4BEEA
TNPW0805499KBEEA
TNPW080549K9BEEA
TNPW08055K11BEEA
TNPW080593K1BEEA
TNPW080515K6BEEA
TNPW080571K5BEEA
TNPW08051K00BEEA
TNPW0805100KBEEA
TNPW0805200KBEEA
TNPW080524K9BEEA
TNPW080535K7BEEA
TNPW080588K7BEEA
885012207098
TSW-104-07-G-S
TSW-102-07-G-S
TSW-106-07-G-S
TSW-107-07-G-S
TSW-103-07-G-S
PCB_FEATURE_NO_COMPONENT
CRCW201022K1FKEF
BAV199,215
TNPW0805249RBEEA
CRCW1206470RFKEA
TNPW08054K42BEEA
TNPW08053K24BEEA
TNPW080525K5BEEA
TNPW080510K8BEEA
TNPW0805300KBEEA
TNPW080516K9BEEA
TNPW080516K5BEEA
SN74LVC2G17DBVR
104-2-A-5/2
AO3400A
SMAJ12A-E3/61
TNPW0805100RBEEA
SN74LVC1G08DBVR
885382207003
SN74LVC1G17DBVR

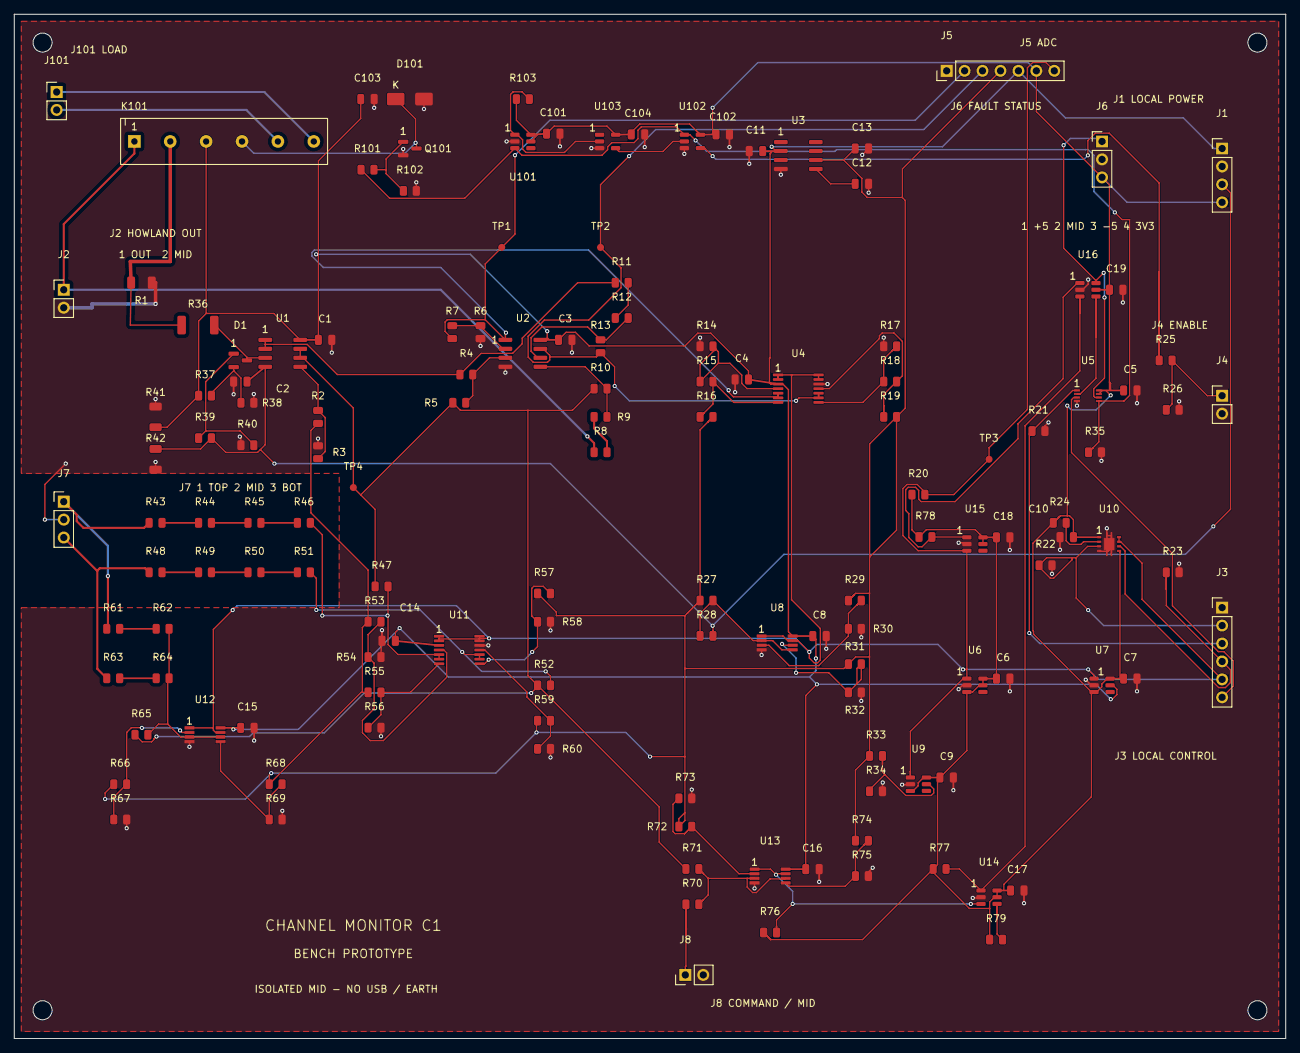
[picture p44: board Channel_Monitor_C1.kicad_pcb from above]

Board: 2 copper layers, 180.0 x 145.0 mm, 145 parts (0 on the bottom side), 74 nets.

Other parts of the board:
H1, H2, H3, H4: M2.5 support; MountingHole_2.7mm_M2.5
