AnishLanka/BrainStimulation/boards/Shared/Shared_Power_RevC/kicad/Peter_Work/Shared_Power_Adapter_RevC.kicad_pcb

## KiCad design boards/Shared/Shared_Power_RevC/kicad/Peter_Work/Shared_Power_Adapter_RevC.kicad_pcb (2026-10-30)

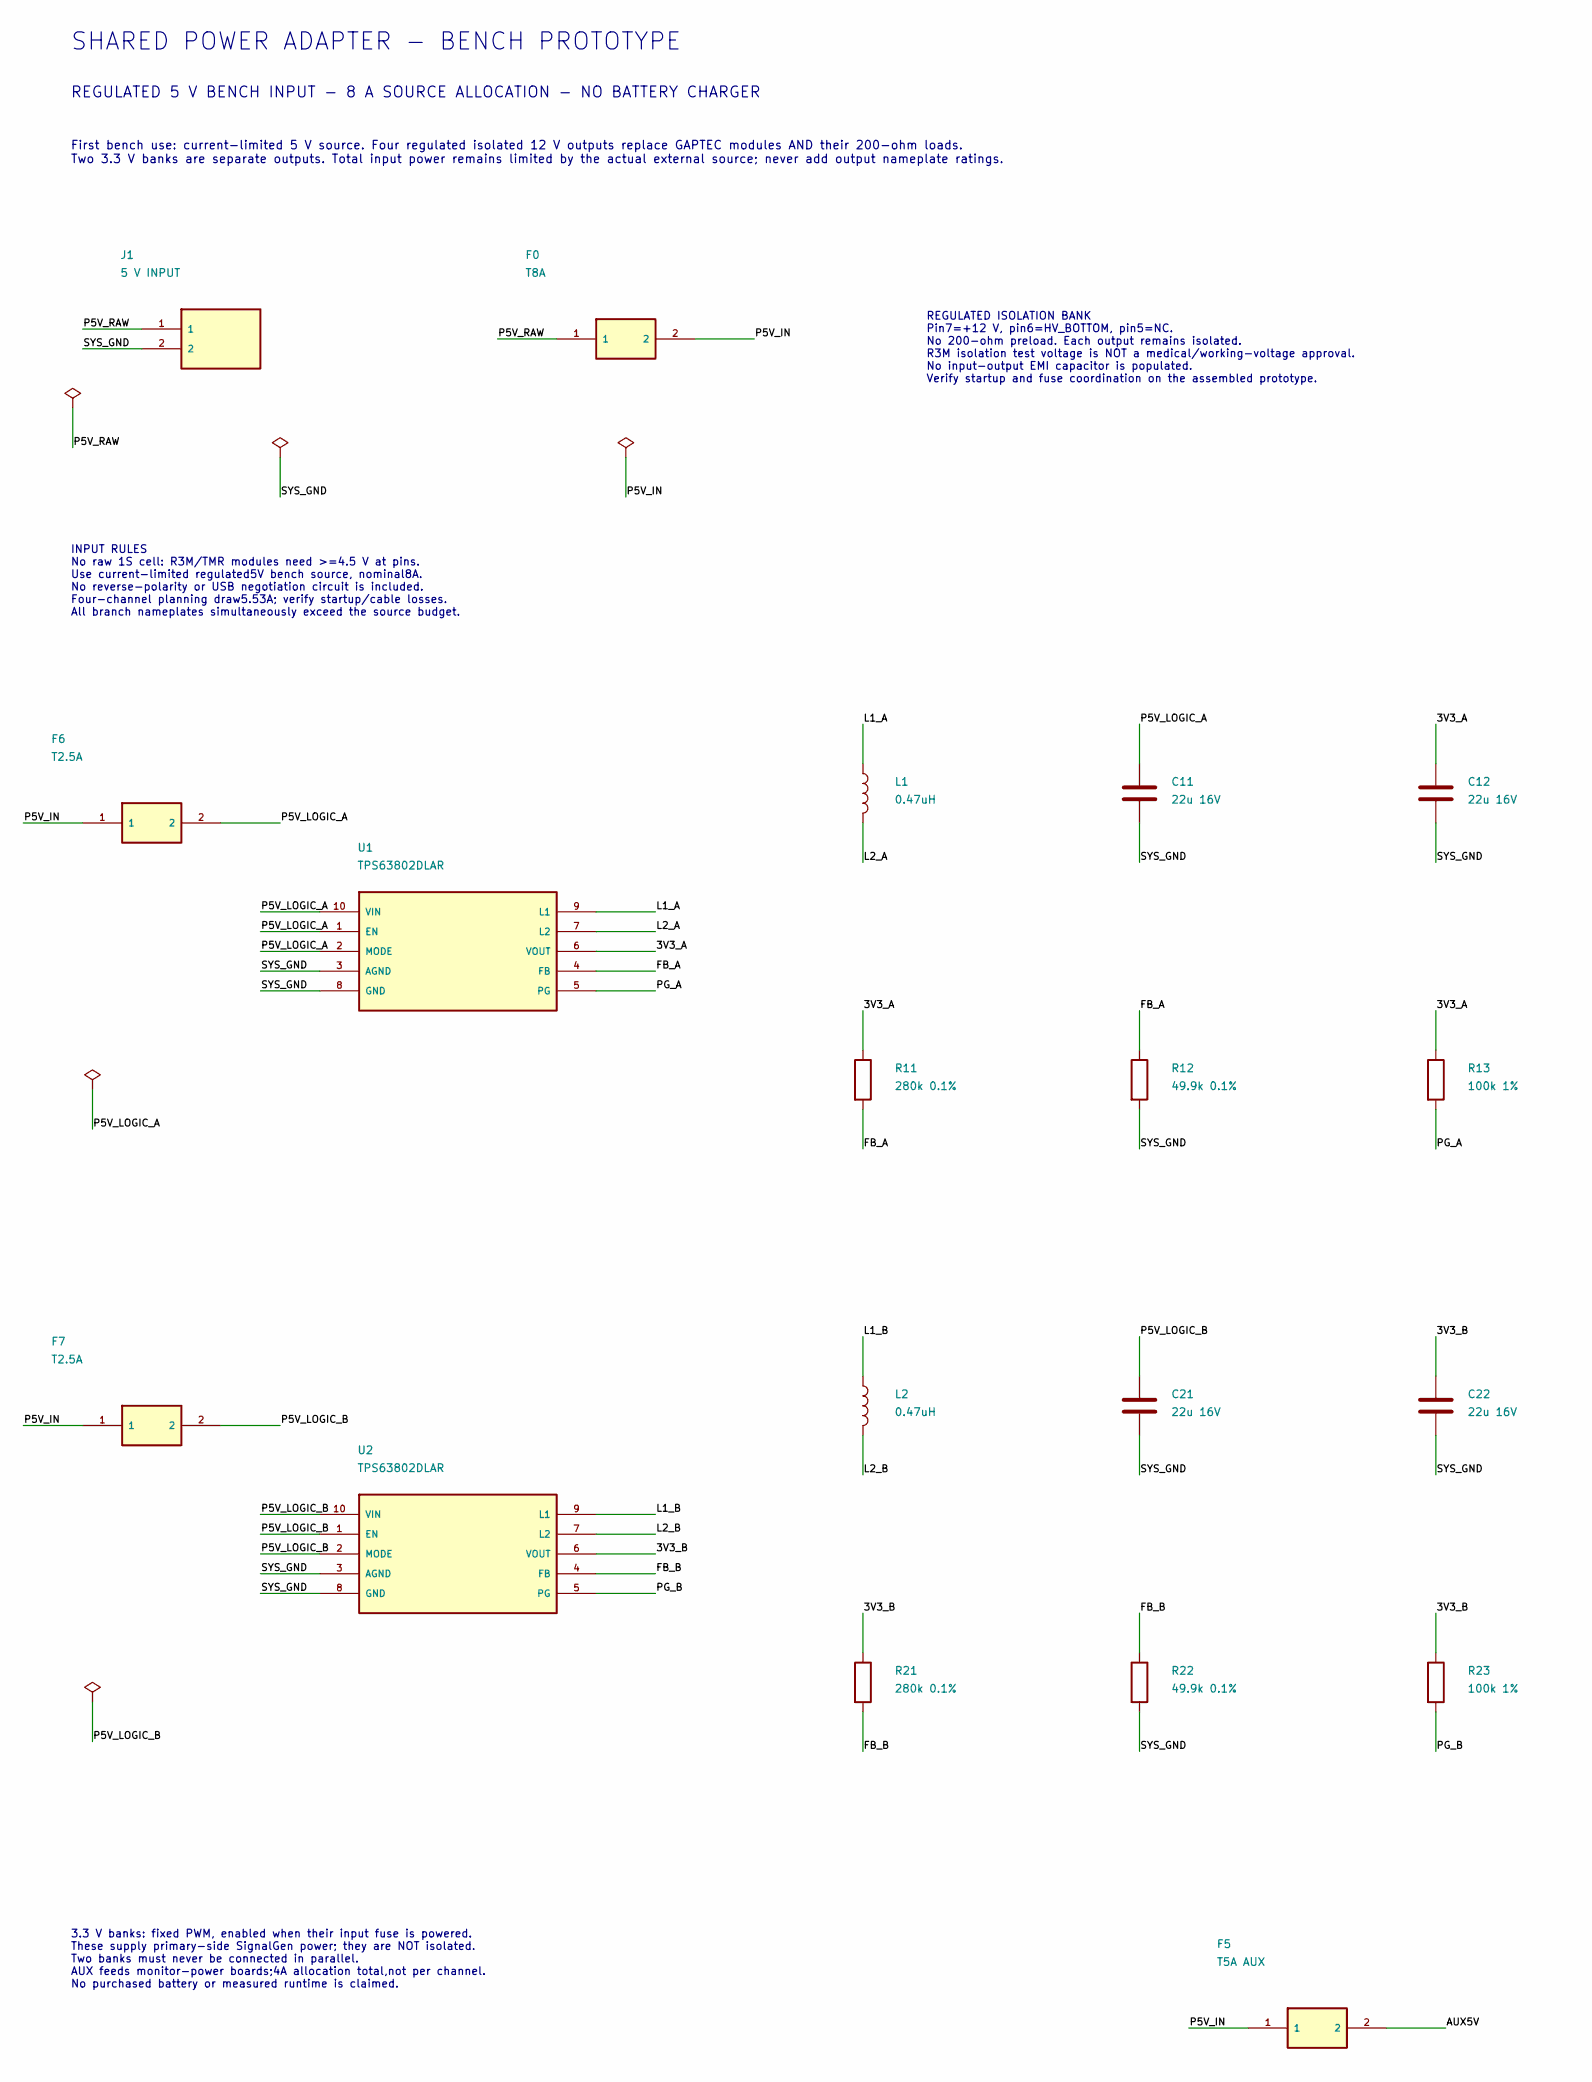
[picture p45: schematic Shared_Power_Adapter_RevC.kicad_sch, Shared regulated power adapter - bench prototype, part in row 1, column 1]

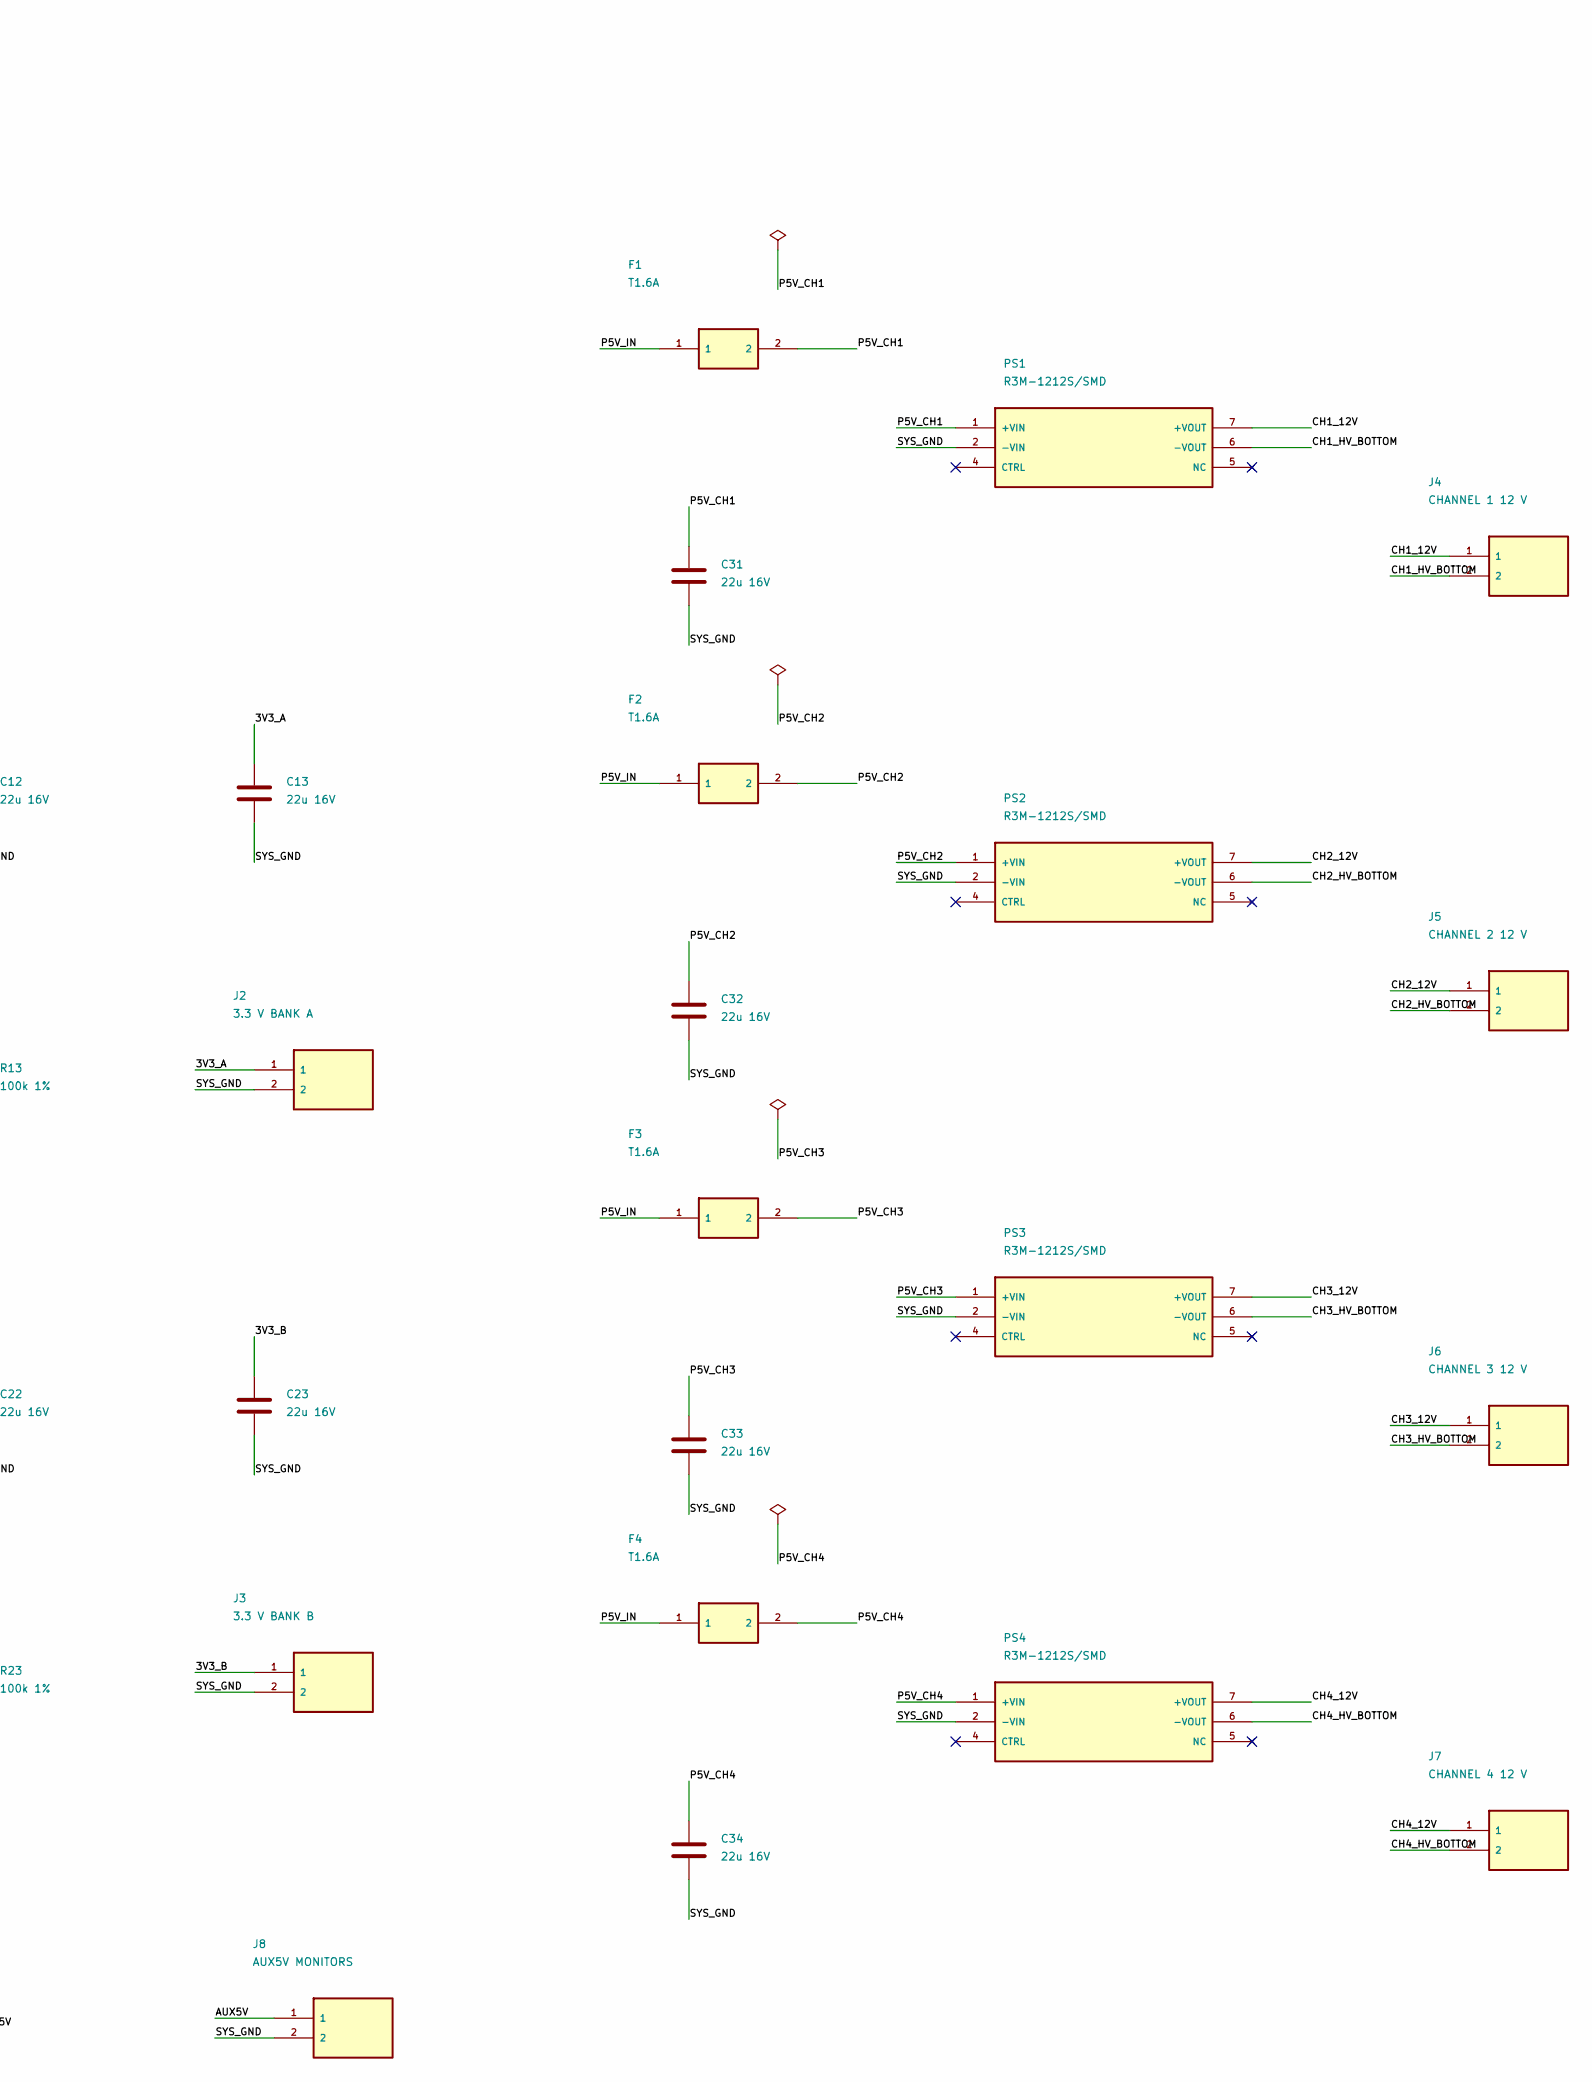
[picture p46: schematic Shared_Power_Adapter_RevC.kicad_sch, Shared regulated power adapter - bench prototype, part in row 1, column 2]

Parts:
C11, C12, C13, C21, C22, C23, C31, C32, C33, C34: 22u 16V; C_1206_3216Metric; MPN GRM31CR61C226KE15L
F0: T8A; Fuse_Schurter_UMT250; MPN 3403.0175.11
F1, F2, F3, F4: T1.6A; Fuse_Schurter_UMT250; MPN 3403.0168.11
F5: T5A AUX; Fuse_Schurter_UMT250; MPN 3403.0173.11
F6, F7: T2.5A; Fuse_Schurter_UMT250; MPN 3403.0170.11
J1: 5 V INPUT; JST_VH_B2P-VH_1x02_P3.96mm_Vertical; MPN B2P-VH
J2: 3.3 V BANK A; JST_VH_B2P-VH_1x02_P3.96mm_Vertical; MPN B2P-VH
J3: 3.3 V BANK B; JST_VH_B2P-VH_1x02_P3.96mm_Vertical; MPN B2P-VH
J4: CHANNEL 1 12 V; JST_VH_B2P-VH_1x02_P3.96mm_Vertical; MPN B2P-VH
J5: CHANNEL 2 12 V; JST_VH_B2P-VH_1x02_P3.96mm_Vertical; MPN B2P-VH
J6: CHANNEL 3 12 V; JST_VH_B2P-VH_1x02_P3.96mm_Vertical; MPN B2P-VH
J7: CHANNEL 4 12 V; JST_VH_B2P-VH_1x02_P3.96mm_Vertical; MPN B2P-VH
J8: AUX5V MONITORS; JST_VH_B2P-VH_1x02_P3.96mm_Vertical; MPN B2P-VH
L1, L2: 0.47uH; L_Coilcraft_XFL4015; MPN XFL4015-471MEC
PS1, PS2, PS3, PS4: R3M-1212S/SMD; RECOM_R3M_SMD; MPN R3M-1212S/SMD
R11, R21: 280k 0.1%; R_0603_1608Metric; MPN TNPW0603280KBEEA
R12, R22: 49.9k 0.1%; R_0603_1608Metric; MPN TNPW060349K9BEEA
R13, R23: 100k 1%; R_0603_1608Metric; MPN CRCW0603100KFKEA
U1, U2: TPS63802DLAR; Texas_DLA0010A_TPS63802; MPN TPS63802DLAR

Connections:
/3V3_A: C12.1, C13.1, J2.1, R11.1, R13.1, U1.6 (VOUT)
/3V3_B: C22.1, C23.1, J3.1, R21.1, R23.1, U2.6 (VOUT)
/AUX5V: F5.2, J8.1
/CH1_12V: J4.1, PS1.7 (+VOUT)
/CH1_HV_BOTTOM: J4.2, PS1.6 (-VOUT)
/CH2_12V: J5.1, PS2.7 (+VOUT)
/CH2_HV_BOTTOM: J5.2, PS2.6 (-VOUT)
/CH3_12V: J6.1, PS3.7 (+VOUT)
/CH3_HV_BOTTOM: J6.2, PS3.6 (-VOUT)
/CH4_12V: J7.1, PS4.7 (+VOUT)
/CH4_HV_BOTTOM: J7.2, PS4.6 (-VOUT)
/FB_A: R11.2, R12.1, U1.4 (FB)
/FB_B: R21.2, R22.1, U2.4 (FB)
/L1_A: L1.1, U1.9 (L1)
/L1_B: L2.1, U2.9 (L1)
/L2_A: L1.2, U1.7 (L2)
/L2_B: L2.2, U2.7 (L2)
/P5V_CH1: C31.1, F1.2, PS1.1 (+VIN)
/P5V_CH2: C32.1, F2.2, PS2.1 (+VIN)
/P5V_CH3: C33.1, F3.2, PS3.1 (+VIN)
/P5V_CH4: C34.1, F4.2, PS4.1 (+VIN)
/P5V_IN: F0.2, F1.1, F2.1, F3.1, F4.1, F5.1, F6.1, F7.1
/P5V_LOGIC_A: C11.1, F6.2, U1.1 (EN), U1.2 (MODE), U1.10 (VIN)
/P5V_LOGIC_B: C21.1, F7.2, U2.1 (EN), U2.2 (MODE), U2.10 (VIN)
/P5V_RAW: F0.1, J1.1
/PG_A: R13.2, U1.5 (PG)
/PG_B: R23.2, U2.5 (PG)
/SYS_GND: C11.2, C12.2, C13.2, C21.2, C22.2, C23.2, C31.2, C32.2, C33.2, C34.2, J1.2, J2.2, J3.2, J8.2, PS1.2 (-VIN), PS2.2 (-VIN), PS3.2 (-VIN), PS4.2 (-VIN), R12.2, R22.2, U1.3 (AGND), U1.8 (GND), U2.3 (AGND), U2.8 (GND)

Notes on the sheet:
SHARED POWER ADAPTER - BENCH PROTOTYPE
REGULATED 5 V BENCH INPUT - 8 A SOURCE ALLOCATION - NO BATTERY CHARGER
First bench use: current-limited 5 V source. Four regulated isolated 12 V outputs replace GAPTEC modules AND their 200-ohm loads. Two 3.3 V banks are separate outputs. Total input power remains limited by the actual external source; never add output nameplate ratings.
INPUT RULES No raw 1S cell: R3M/TMR modules need >=4.5 V at pins. Use current-limited regulated5V bench source, nominal8A. No reverse-polarity or USB negotiation circuit is included. Four-channel planning draw5.53A; verify startup/cable losses. All branch nameplates simultaneously exceed the source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
3.3 V banks: fixed PWM, enabled when their input fuse is powered. These supply primary-side SignalGen power; they are NOT isolated. Two banks must never be connected in parallel. AUX feeds monitor-power boards;4A allocation total,not per channel. No purchased battery or measured runtime is claimed.
REGULATED ISOLATION BANK Pin7=+12 V, pin6=HV_BOTTOM, pin5=NC. No 200-ohm preload. Each output remains isolated. R3M isolation test voltage is NOT a medical/working-voltage approval. No input-output EMI capacitor is populated. Verify startup and fuse coordination on the assembled prototype.

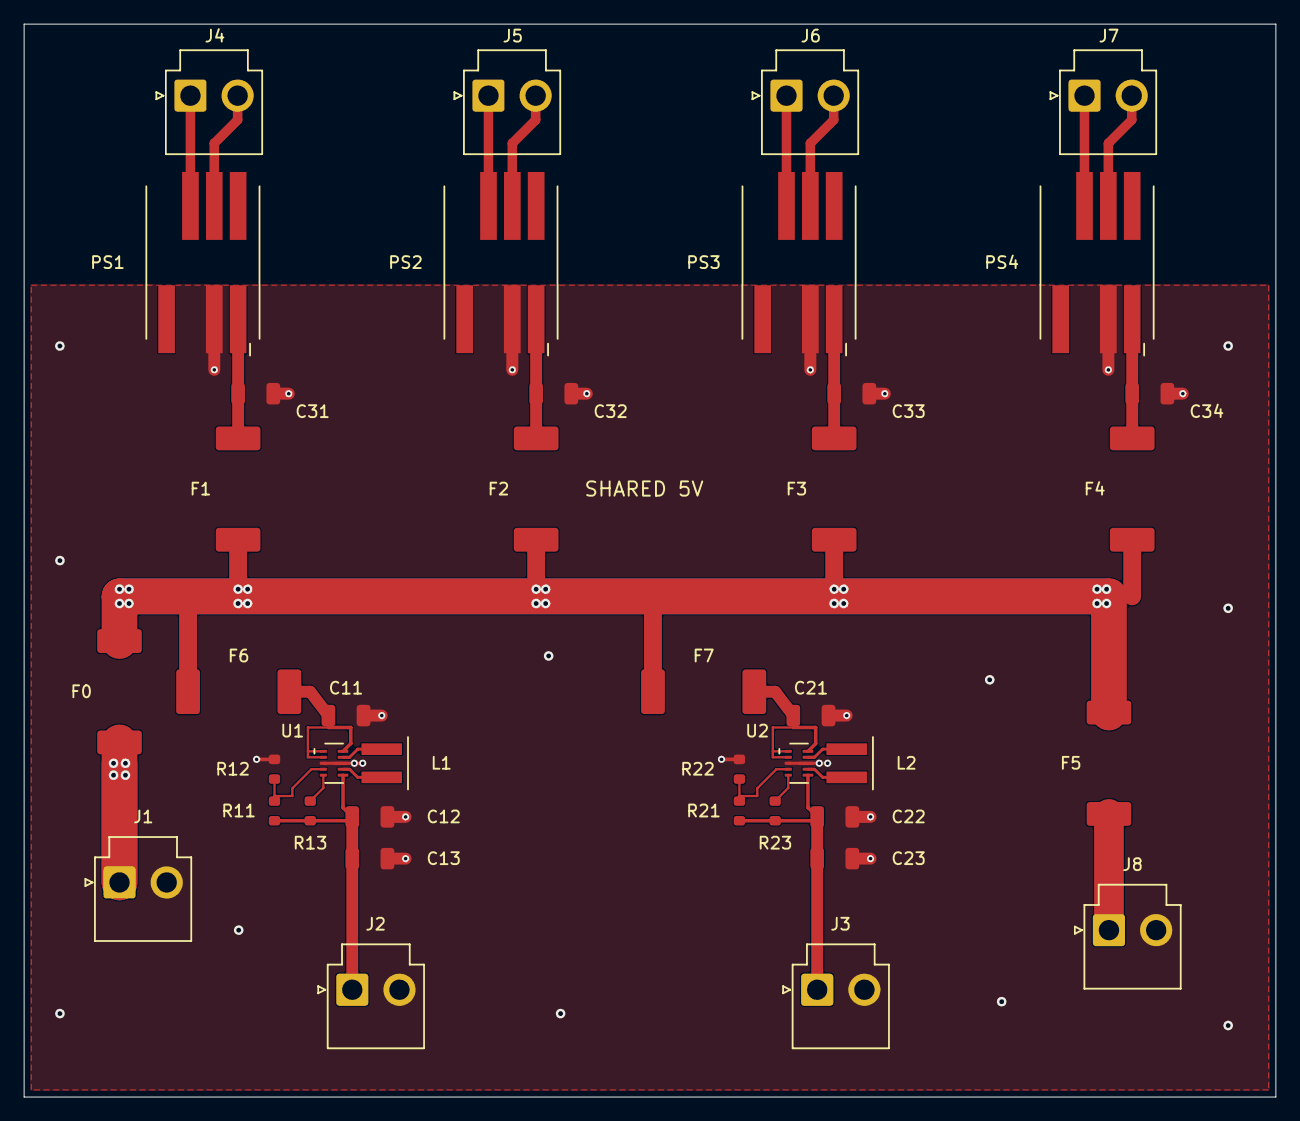
[picture p47: board Shared_Power_Adapter_RevC.kicad_pcb from above]

Board: 2 copper layers, 105.0 x 90.0 mm, 40 parts (0 on the bottom side), 28 nets.
