AnishLanka/BrainStimulation/boards/Boost/kicad/Pyth_Work/Boost_Electrical_Draft.kicad_pcb

## KiCad design boards/Boost/kicad/Pyth_Work/Boost_Electrical_Draft.kicad_pcb (2026-10-30)

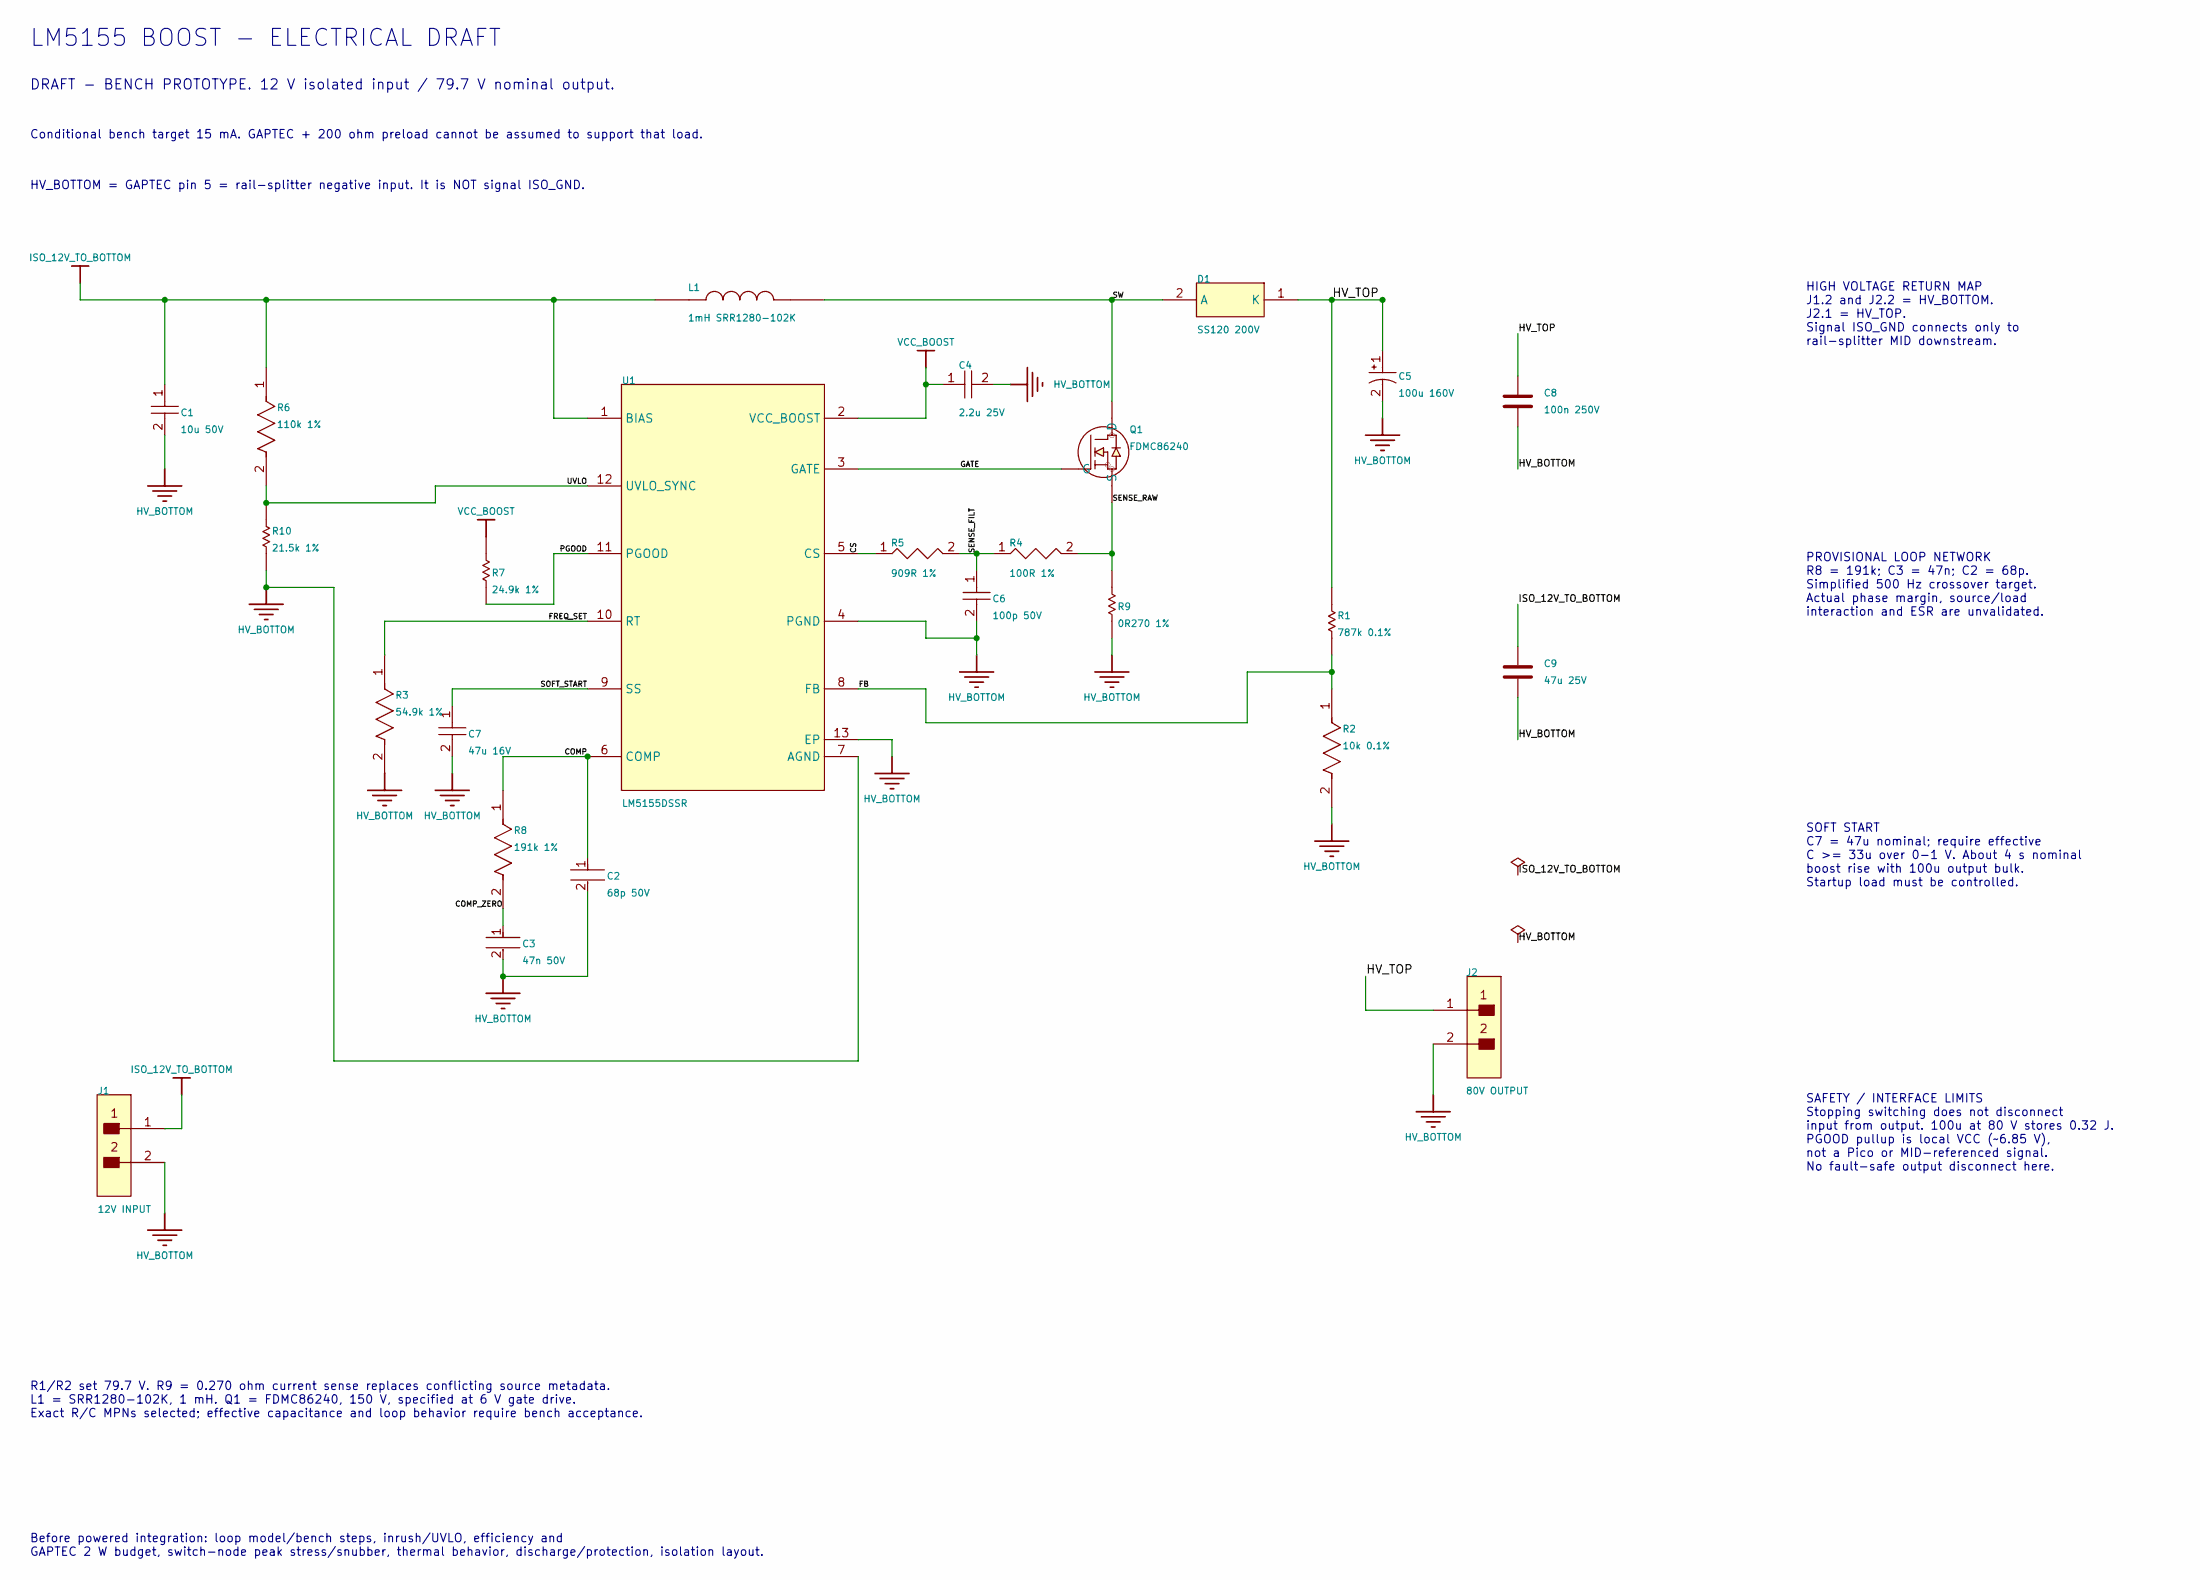
[picture p48: schematic Boost_Electrical_Draft.kicad_sch, 12 V to 79.7 V boost — engineering bench prototype]

Parts:
C1: 10u 50V; C0805; Rating 0805;10uF10%;50V;-55 to85C; MPN C2012X5R1H106K125AC
C2: 68p 50V; C0603; Rating 0603;68pF5%;50V; MPN C1608C0G1H680J080AA
C3: 47n 50V; C0603; Rating 0603;47nF10%;50V; MPN C1608X7R1H473K080AA
C4: 2.2u 25V; C0805; Rating 0805;2.2uF10%;25V; MPN C2012X7R1E225K125AB
C5: 100u 160V; C_BULK; Rating 100uF20%;160V;105C;D16mm;H20mm;P7.5mm;l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; MPN EEUEE2C101S
C6: 100p 50V; C0603; Rating 0603;100pF5%;50V; MPN C1608C0G1H101J080AA
C7: 47u 16V; C1210; Rating 1210;47uF10%;16V;-55 to85C; MPN GRM32ER61C476KE15L
C8: 100n 250V; C0805; Rating 0805;100nF10%;250V; MPN C2012X7T2E104K125AA
C9: 47u 25V; C1210; Rating 1210;47uF20%;25V;-55 to85C; MPN MSAST32MAB5476MPNDT1
D1: SS120 200V; D_SMA; Rating 200V,1A Schottky; verify order suffix; MPN SS120
J1: 12V INPUT; IN_FP-TSW-102-14-G-S-MFG
J2: 80V OUTPUT; OUT_FP-TSW-102-14-G-S-MFG
L1: 1mH SRR1280-102K; L_BOURNS; Rating 1mH10%;DCR1.7ohm max;Irms0.68A;Isat0.80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; MPN SRR1280-102K
Q1: FDMC86240; Q_FDMC86240_CASE511DH; Rating 150V;RDS(on) 70mohm max at VGS 6V; WDFN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; MPN FDMC86240
R1: 787k 0.1%; R1206; Rating 1206; 200V working; at least 0.25W; 0.1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; MPN TNPW1206787KBEEA
R2: 10k 0.1%; R0603; Rating 0603;100V working;at least0.1W;0.1%;25p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; MPN TNPW060310K0BEEA
R3: 54.9k 1%; R0603; Rating 0603;1%;100ppm/K;0.1W;75V; MPN CRCW060354K9FKEA
R4: 100R 1%; R0603; Rating 0603;1%;100ppm/K;0.1W;75V; MPN CRCW0603100RFKEA
R5: 909R 1%; R0603; Rating 0603;1%;100ppm/K;0.1W;75V; MPN CRCW0603909RFKEA
R6: 110k 1%; R0603; Rating 0603;1%;100ppm/K;0.1W;75V; MPN CRCW0603110KFKEA
R7: 24.9k 1%; R0603; Rating 0603;1%;100ppm/K;0.1W;75V; MPN CRCW060324K9FKEA
R8: 191k 1%; R0805; Rating 0805;1%;100ppm/K;0.125W;150V; MPN CRCW0805191KFKEA
R9: 0R270 1%; R1206; Rating 1206;0.270ohm1%;0.5W at70C;derate above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; MPN ERJ8BQFR27V
R10: 21.5k 1%; R0603; Rating 0603;1%;100ppm/K;0.1W;75V; MPN CRCW060321K5FKEA
U1: LM5155DSSR; U1_DSS0012B; MPN LM5155DSSR

Connections:
/COMP: C2.1, R8.1, U1.6 (COMP)
/COMP_ZERO: C3.1, R8.2
/CS: R5.1, U1.5 (CS)
/FB: R1.2, R2.1, U1.8 (FB)
/FREQ_SET: R3.1, U1.10 (RT)
/GATE: Q1.4 (G), U1.3 (GATE)
/HV_TOP: C5.1, C8.1, D1.1 (K), J2.1, R1.1
/PGOOD: R7.1, U1.11 (PGOOD)
/SENSE_FILT: C6.1, R4.1, R5.2
/SENSE_RAW: Q1.1 (S), Q1.2 (S), Q1.3 (S), R4.2, R9.2
/SOFT_START: C7.1, U1.9 (SS)
/SW: D1.2 (A), L1.2, Q1.5 (D), Q1.6 (D), Q1.7 (D), Q1.8 (D)
/UVLO: R6.2, R10.1, U1.12 (UVLO_SYNC)
HV_BOTTOM: C1.2, C2.2, C3.2, C4.2, C5.2, C6.2, C7.2, C8.2, C9.2, J1.2, J2.2, R2.2, R3.2, R9.1, R10.2, U1.4 (PGND), U1.7 (AGND), U1.13 (EP)
ISO_12V_TO_BOTTOM: C1.1, C9.1, J1.1, L1.1, R6.1, U1.1 (BIAS)
VCC_BOOST: C4.1, R7.2, U1.2 (VCC_BOOST)

Notes on the sheet:
LM5155 BOOST - ELECTRICAL DRAFT
DRAFT - BENCH PROTOTYPE. 12 V isolated input / 79.7 V nominal output.
Conditional bench target 15 mA. GAPTEC + 200 ohm preload cannot be assumed to support that load.
HV_BOTTOM = GAPTEC pin 5 = rail-splitter negative input. It is NOT signal ISO_GND.
HIGH VOLTAGE RETURN MAP J1.2 and J2.2 = HV_BOTTOM. J2.1 = HV_TOP. Signal ISO_GND connects only to rail-splitter MID downstream.
PROVISIONAL LOOP NETWORK R8 = 191k; C3 = 47n; C2 = 68p. Simplified 500 Hz crossover target. Actual phase margin, source/load interaction and ESR are unvalidated.
SOFT START C7 = 47u nominal; require effective C >= 33u over 0-1 V. About 4 s nominal boost rise with 100u output bulk. Startup load must be controlled.
SAFETY / INTERFACE LIMITS Stopping switching does not disconnect input from output. 100u at 80 V stores 0.32 J. PGOOD pullup is local VCC (~6.85 V), not a Pico or MID-referenced signal. No fault-safe output disconnect here.
R1/R2 set 79.7 V. R9 = 0.270 ohm current sense replaces conflicting source metadata. L1 = SRR1280-102K, 1 mH. Q1 = FDMC86240, 150 V, specified at 6 V gate drive. Exact R/C MPNs selected; effective capacitance and loop behavior require bench acceptance.
Before powered integration: loop model/bench steps, inrush/UVLO, efficiency and GAPTEC 2 W budget, switch-node peak stress/snubber, thermal behavior, discharge/protection, isolation layout.
