AnishLanka/BrainStimulation/boards/Boost/kicad/Pyth_Work/Boost_Electrical_Draft.kicad_pcb

## KiCad design boards/Boost/kicad/Pyth_Work/Boost_Electrical_Draft.kicad_pcb (continued)

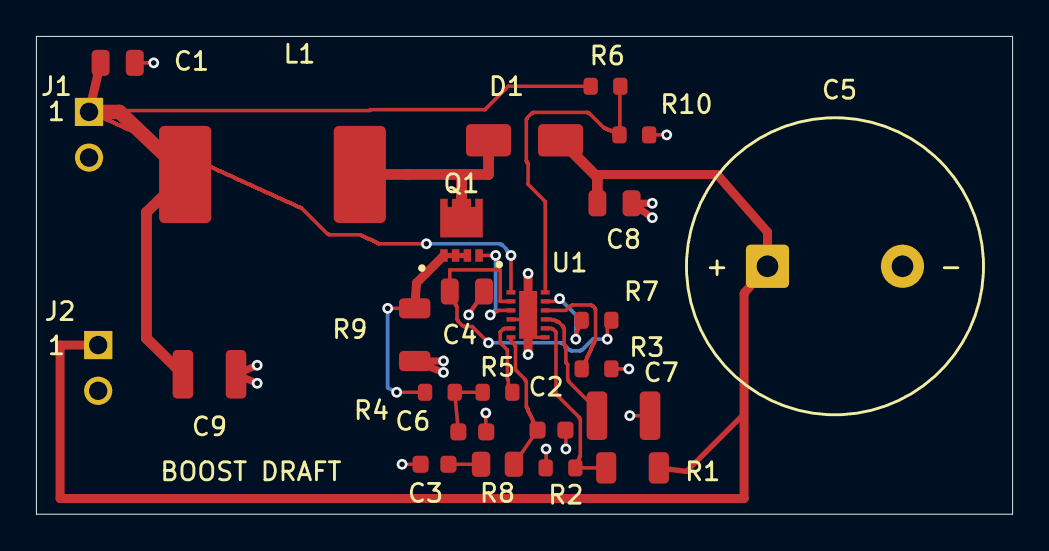
[picture p49: board Boost_Electrical_Draft.kicad_pcb from above]

Board: 2 copper layers, 54.2 x 26.5 mm, 25 parts (0 on the bottom side), 16 nets.
