AnishLanka/BrainStimulation/boards/Buck_Boost/kicad/Pyth_Work/BuckBoost_RevB.kicad_pcb

## KiCad design boards/Buck_Boost/kicad/Pyth_Work/BuckBoost_RevB.kicad_pcb (2026-10-30)

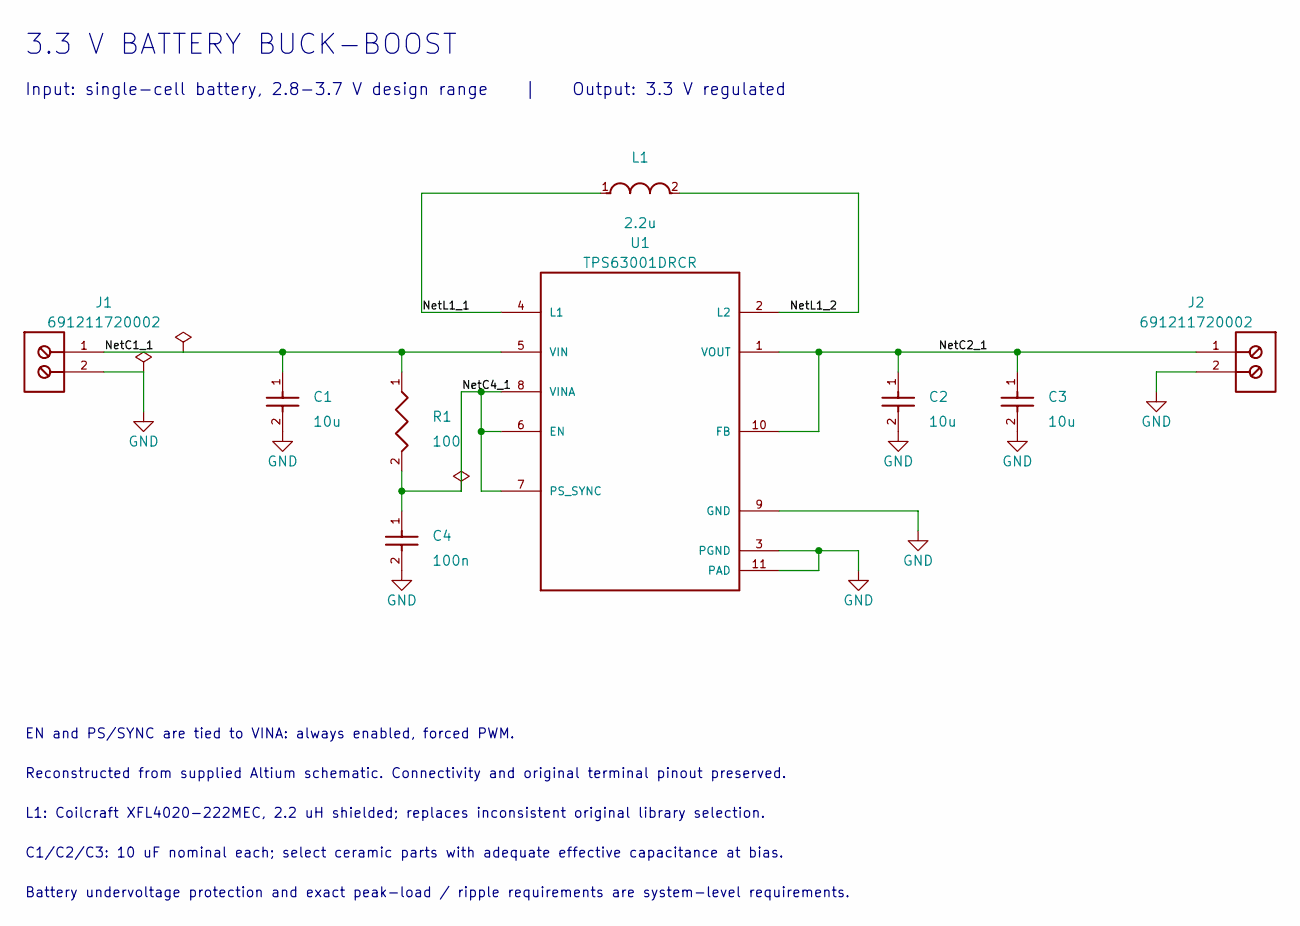
[picture p50: schematic BuckBoost_RevB.kicad_sch, 3.3 V battery buck-boost converter]

Parts:
C1, C2, C3: 10u; C1_0805; MPN GRM21BR61E106KA73L
C4: 100n; C4_0805; MPN C2012X7R2A104K125AA
J1: 691211720002; IN_691211720002; MPN 691211720002
J2: 691211720002; OUT_691211720002; MPN 691211720002
L1: 2.2u; L1_2u2; MPN XFL4020-222MEC
R1: 100; R1_0402; MPN CRCW0402100RFKED
U1: TPS63001DRCR; U1_TPS63001; MPN TPS63001DRCR

Connections:
/NetC1_1: C1.1, J1.1, R1.1, U1.5 (VIN)
/NetC2_1: C2.1, C3.1, J2.1, U1.1 (VOUT), U1.10 (FB)
/NetC4_1: C4.1, R1.2, U1.6 (EN), U1.7 (PS_SYNC), U1.8 (VINA)
/NetL1_1: L1.1, U1.4 (L1)
/NetL1_2: L1.2, U1.2 (L2)
GND: C1.2, C2.2, C3.2, C4.2, J1.2, J2.2, U1.3 (PGND), U1.9 (GND), U1.11 (PAD)

Notes on the sheet:
3.3 V BATTERY BUCK-BOOST
Input: single-cell battery, 2.8-3.7 V design range | Output: 3.3 V regulated
EN and PS/SYNC are tied to VINA: always enabled, forced PWM.
Reconstructed from supplied Altium schematic. Connectivity and original terminal pinout preserved.
L1: Coilcraft XFL4020-222MEC, 2.2 uH shielded; replaces inconsistent original library selection.
C1/C2/C3: 10 uF nominal each; select ceramic parts with adequate effective capacitance at bias.
Battery undervoltage protection and exact peak-load / ripple requirements are system-level requirements.

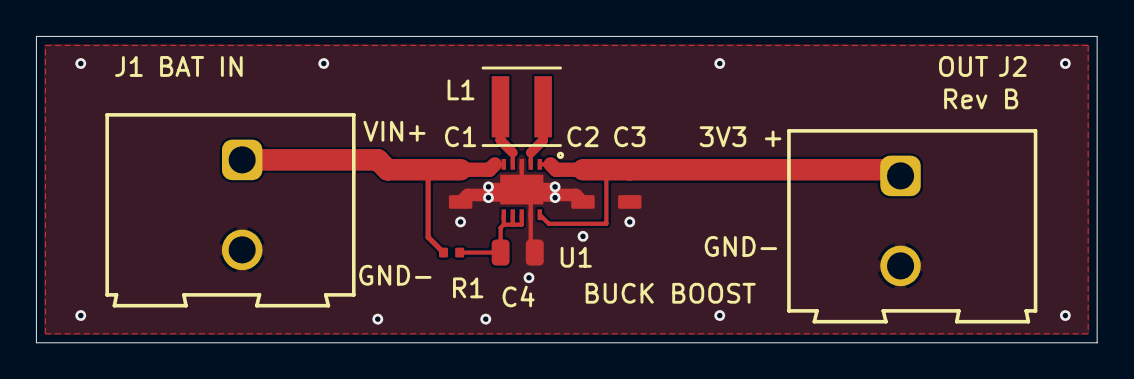
[picture p51: board BuckBoost_RevB.kicad_pcb from above]

Board: 2 copper layers, 58.9 x 17.0 mm, 9 parts (0 on the bottom side), 6 nets.
