AnishLanka/BrainStimulation/boards/Howland_Pump/kicad/Anish_Work/HowlandPump-AnishWork.kicad_pcb

## KiCad design boards/Howland_Pump/kicad/Anish_Work/HowlandPump-AnishWork.kicad_pcb (2026-10-30)

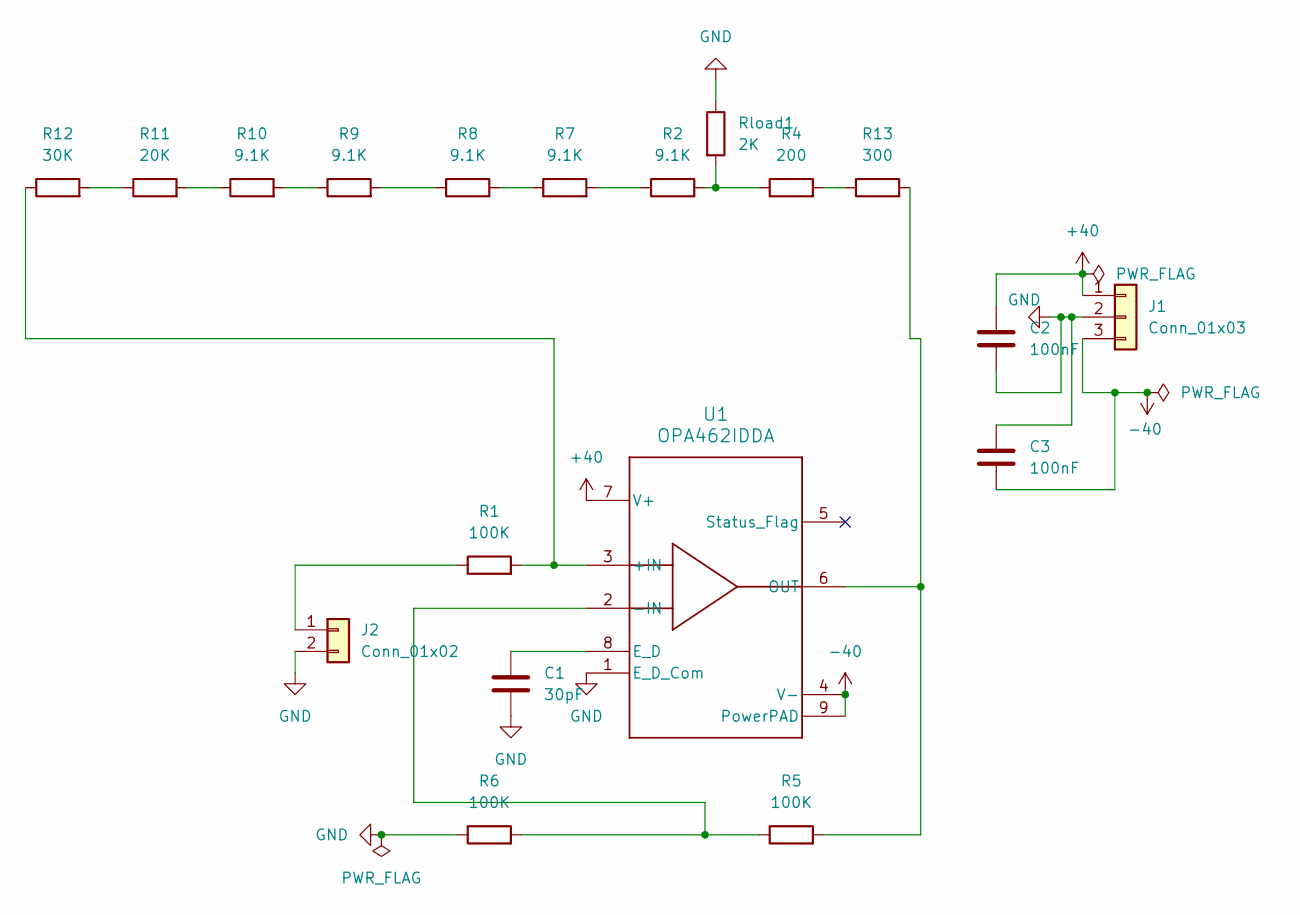
[picture p52: schematic HowlandPump-AnishWork.kicad_sch]

Parts:
C1: 30pF; C_1206_3216Metric
C2, C3: 100nF; C_1206_3216Metric
J1: Conn_01x03; PinHeader_1x03_P2.54mm_Vertical
J2: Conn_01x02; PinHeader_1x02_P2.54mm_Vertical
R1, R5, R6: 100K; R_1206_3216Metric
R2, R7, R8, R9, R10: 9.1K; R_1206_3216Metric
R4: 200; R_1206_3216Metric
R11: 20K; R_1206_3216Metric
R12: 30K; R_1206_3216Metric
R13: 300; R_1206_3216Metric
Rload1: 2K; R_1206_3216Metric
U1: OPA462IDDA; DDA0008J-IPC_A

Connections:
+40: C2.1, J1.1, U1.7 (V+)
-40: C3.2, J1.3, U1.4 (V-), U1.9 (PowerPAD)
GND: C1.2, C2.2, C3.1, J1.2, J2.2, R6.1, Rload1.1, U1.1 (E_D_Com)
unnamed: J2.1, R1.1
unnamed: R2.1, R7.2
unnamed: R2.2, R4.1, Rload1.2
unnamed: R7.1, R8.2
unnamed: R8.1, R9.2
unnamed: R10.1, R11.2
unnamed: R9.1, R10.2
unnamed: R11.1, R12.2
unnamed: R4.2, R13.1
unnamed: R1.2, R12.1, U1.3 (+IN)
unnamed: R5.1, R6.2, U1.2 (-IN)
unnamed: C1.1, U1.8 (E_D)
unnamed: R5.2, R13.2, U1.6 (OUT)

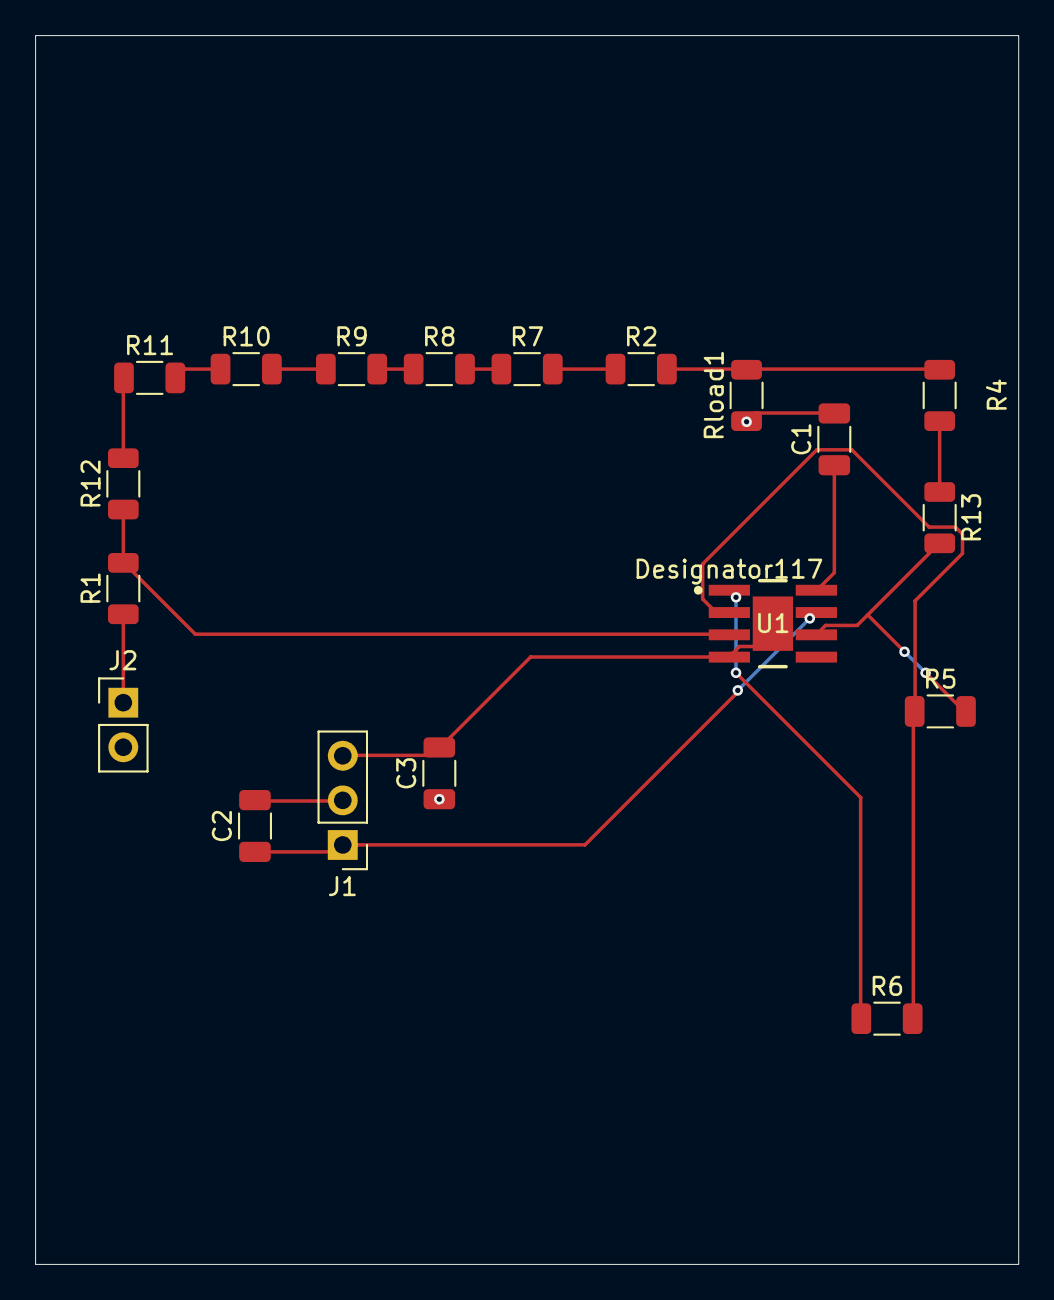
[picture p53: board HowlandPump-AnishWork.kicad_pcb from above]

Board: 2 copper layers, 56.0 x 70.0 mm, 19 parts (0 on the bottom side), 16 nets.
