AnishLanka/BrainStimulation/boards/Signal_Generator/kicad/Peter_Work/SignalGen_Electrical_Draft.kicad_pcb

## KiCad design boards/Signal_Generator/kicad/Peter_Work/SignalGen_Electrical_Draft.kicad_pcb (2026-10-30)

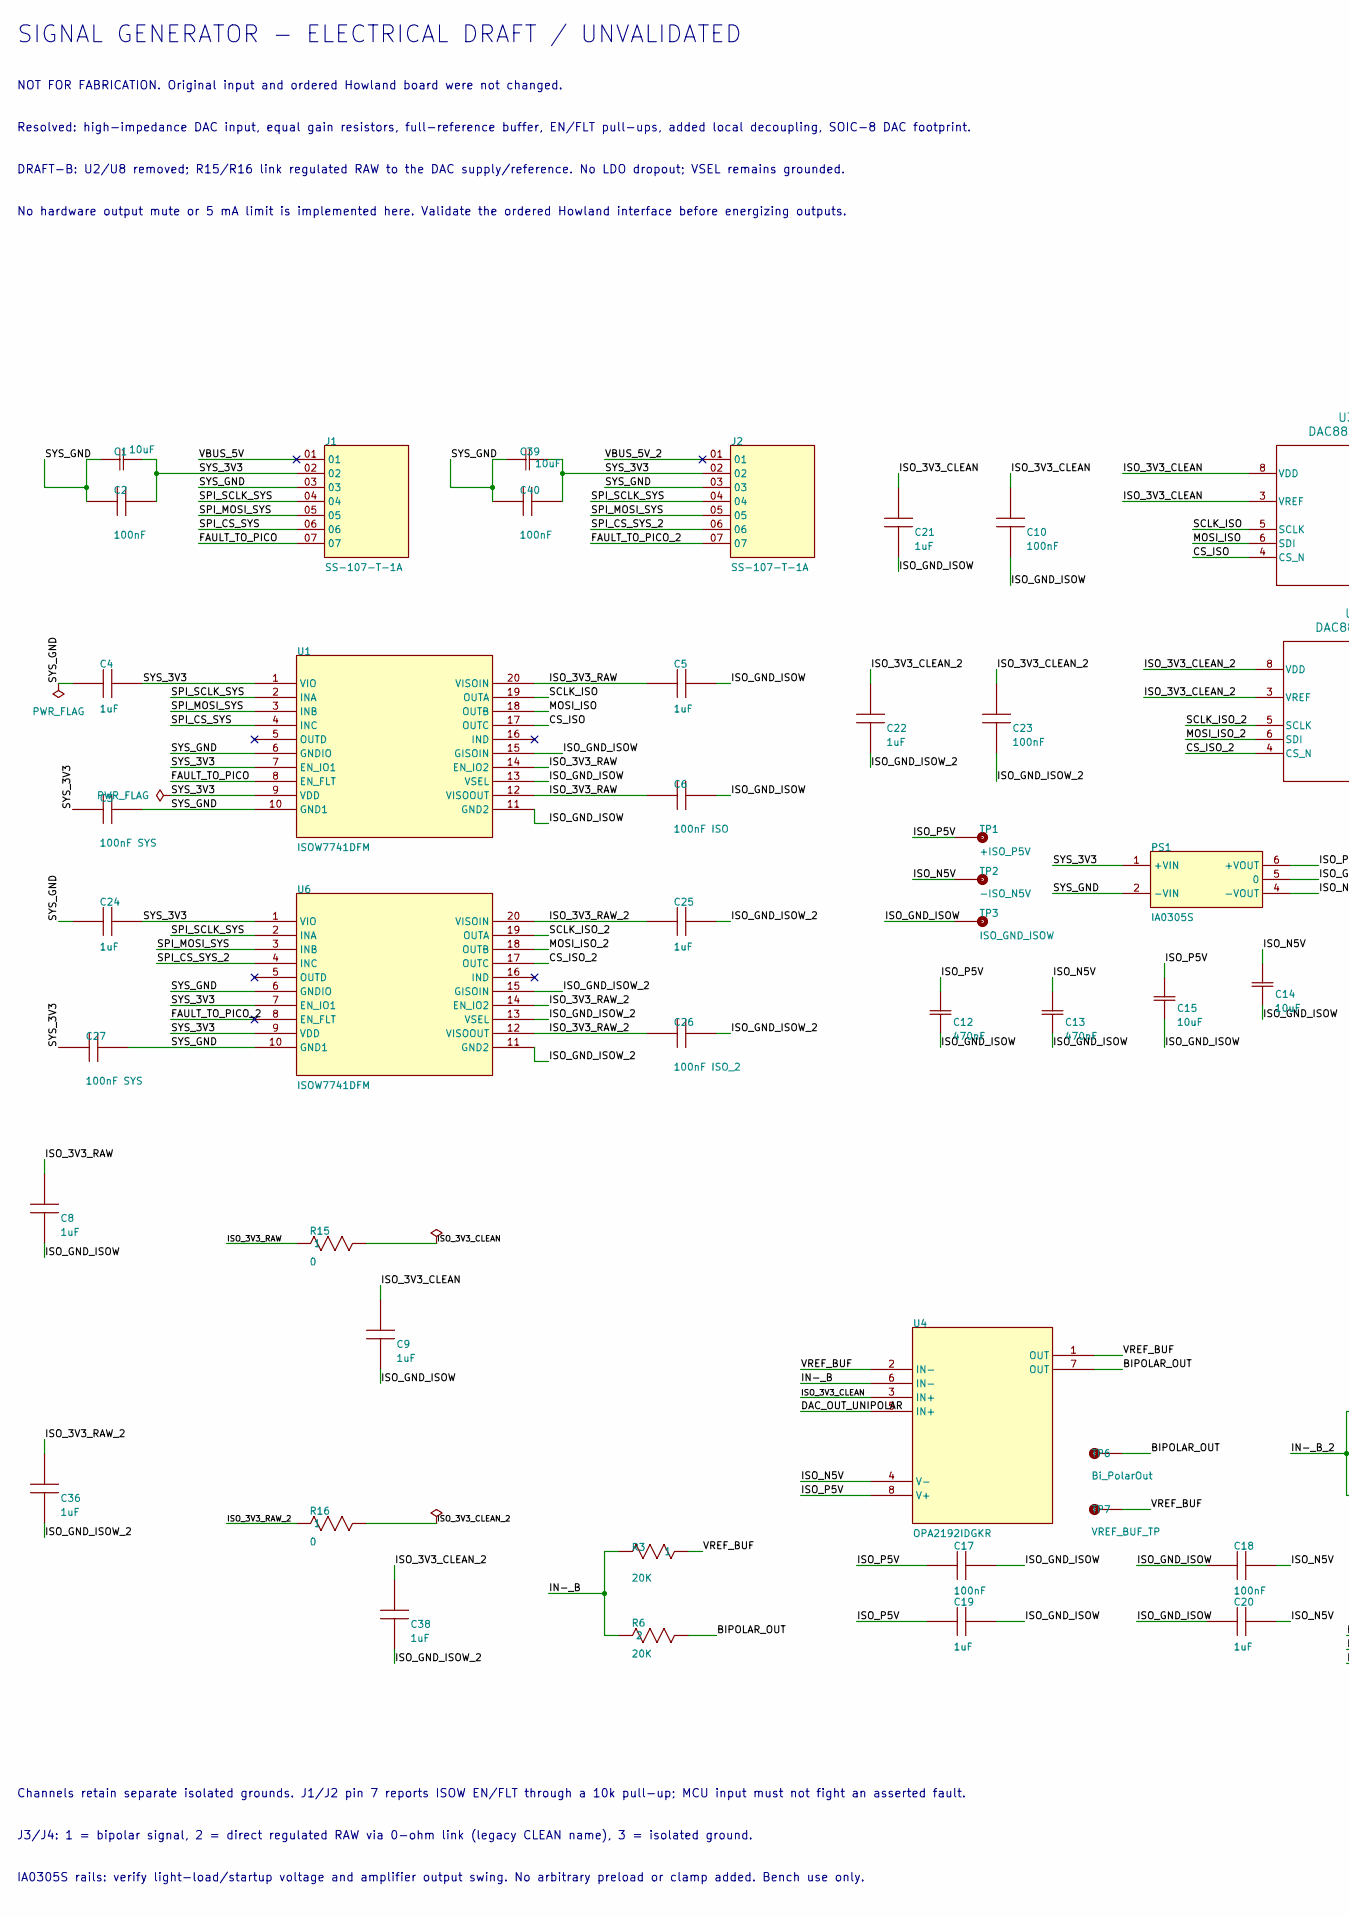
[picture p54: schematic SignalGen_Electrical_Draft.kicad_sch, Signal generator electrical draft - UNVALIDATED, part in row 1, column 1]

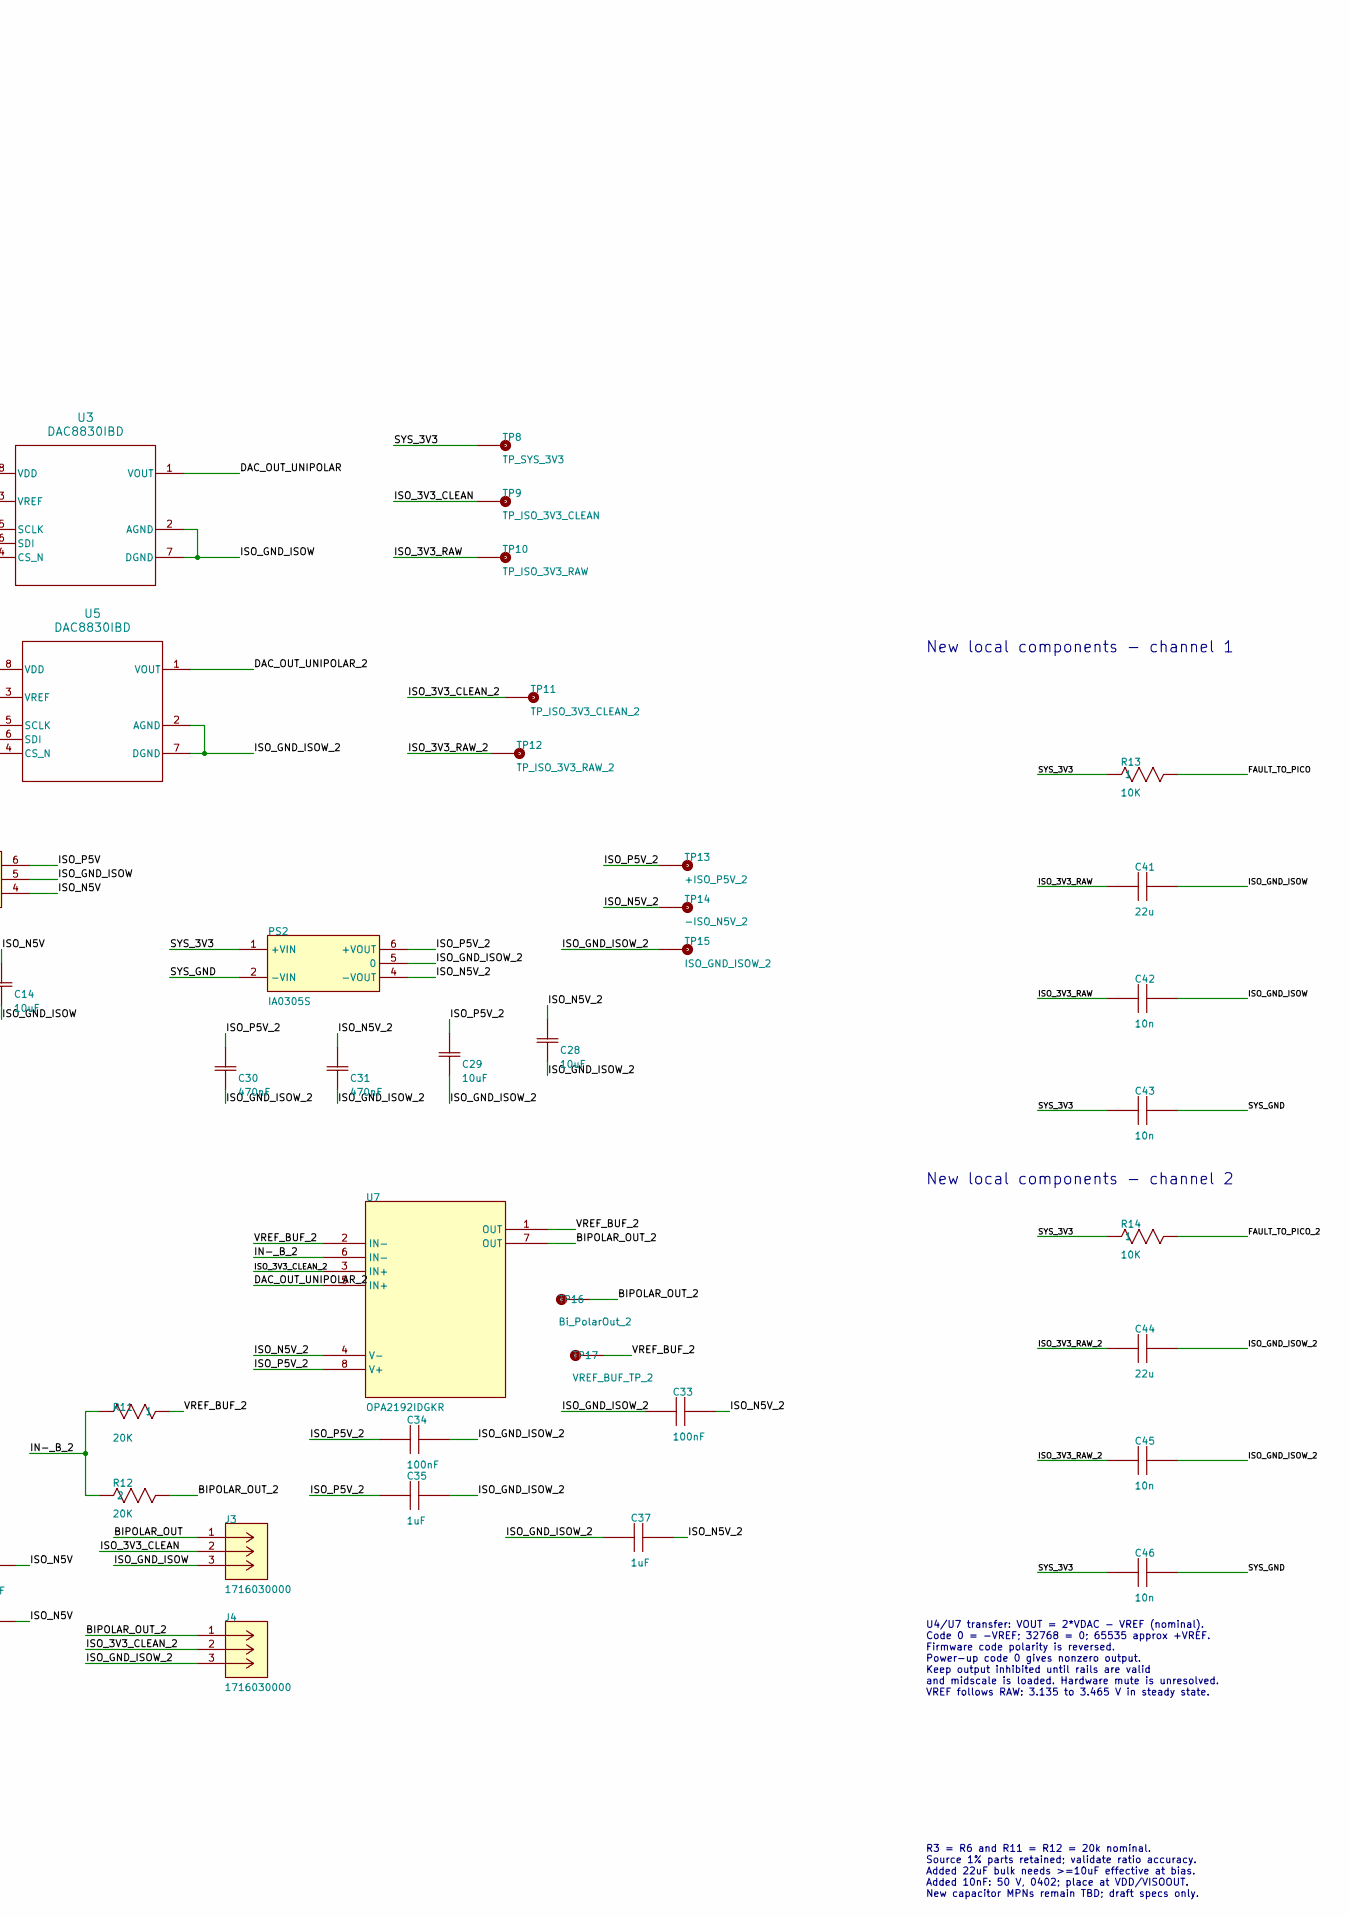
[picture p55: schematic SignalGen_Electrical_Draft.kicad_sch, Signal generator electrical draft - UNVALIDATED, part in row 1, column 2]

Parts:
C1: 10uF; C1_G-21_MUR; MANUFACTURER_PART_NUMBER GRM21BR61E106KA73L
C2: 100nF; C2_CAPC1608X90N; MOUSER PART NUMBER 603-CC603KRX7R8BB104
C3: 100nF SYS; C3_CAPC1608X90N; MOUSER PART NUMBER 603-CC603KRX7R8BB104
C4: 1uF; C4_INDC1608X90N; MOUSER PART NUMBER *
C5: 1uF; C5_INDC1608X90N; MOUSER PART NUMBER *
C6: 100nF ISO; C6_CAPC1608X90N; MOUSER PART NUMBER 603-CC603KRX7R8BB104
C8: 1uF; C8_INDC1608X90N; MOUSER PART NUMBER *
C9: 1uF; C9_INDC1608X90N; MOUSER PART NUMBER *
C10: 100nF; C10_CAPC1608X90N; MOUSER PART NUMBER 603-CC603KRX7R8BB104
C12: 470nF; C12_CAP_1608_TDK; MANUFACTURER_PART_NUMBER C1608X7R1H474K080AC
C13: 470nF; C13_CAP_1608_TDK; MANUFACTURER_PART_NUMBER C1608X7R1H474K080AC
C14: 10uF; C14_G-21_MUR; MANUFACTURER_PART_NUMBER GRM21BR61E106KA73L
C15: 10uF; C15_G-21_MUR; MANUFACTURER_PART_NUMBER GRM21BR61E106KA73L
C17: 100nF; C17_CAPC1608X90N; MOUSER PART NUMBER 603-CC603KRX7R8BB104
C18: 100nF; C18_CAPC1608X90N; MOUSER PART NUMBER 603-CC603KRX7R8BB104
C19: 1uF; C19_INDC1608X90N; MOUSER PART NUMBER *
C20: 1uF; C20_INDC1608X90N; MOUSER PART NUMBER *
C21: 1uF; C21_INDC1608X90N; MOUSER PART NUMBER *
C22: 1uF; C22_INDC1608X90N; MOUSER PART NUMBER *
C23: 100nF; C23_CAPC1608X90N; MOUSER PART NUMBER 603-CC603KRX7R8BB104
C24: 1uF; C24_INDC1608X90N; MOUSER PART NUMBER *
C25: 1uF; C25_INDC1608X90N; MOUSER PART NUMBER *
C26: 100nF ISO_2; C26_CAPC1608X90N; MOUSER PART NUMBER 603-CC603KRX7R8BB104
C27: 100nF SYS; C27_CAPC1608X90N; MOUSER PART NUMBER 603-CC603KRX7R8BB104
C28: 10uF; C28_G-21_MUR; MANUFACTURER_PART_NUMBER GRM21BR61E106KA73L
C29: 10uF; C29_G-21_MUR; MANUFACTURER_PART_NUMBER GRM21BR61E106KA73L
C30: 470nF; C30_CAP_1608_TDK; MANUFACTURER_PART_NUMBER C1608X7R1H474K080AC
C31: 470nF; C31_CAP_1608_TDK; MANUFACTURER_PART_NUMBER C1608X7R1H474K080AC
C33: 100nF; C33_CAPC1608X90N; MOUSER PART NUMBER 603-CC603KRX7R8BB104
C34: 100nF; C34_CAPC1608X90N; MOUSER PART NUMBER 603-CC603KRX7R8BB104
C35: 1uF; C35_INDC1608X90N; MOUSER PART NUMBER *
C36: 1uF; C36_INDC1608X90N; MOUSER PART NUMBER *
C37: 1uF; C37_INDC1608X90N; MOUSER PART NUMBER *
C38: 1uF; C38_INDC1608X90N; MOUSER PART NUMBER *
C39: 10uF; C39_G-21_MUR; MANUFACTURER_PART_NUMBER GRM21BR61E106KA73L
C40: 100nF; C40_CAPC1608X90N; MOUSER PART NUMBER 603-CC603KRX7R8BB104
C41, C44: 22u; C_1206_3216Metric; Voltage 16V; MOUSER PART NUMBER *
C42, C43, C45, C46: 10n; C_0402_1005Metric; Voltage 50V; MOUSER PART NUMBER *
J1: SS-107-T-1A; J1_SAMTEC_SS-107-T-1A
J2: SS-107-T-1A; J2_SAMTEC_SS-107-T-1A
J3: 1716030000; J3_CONN_LM_5.080390_WED; MANUFACTURER_PART_NUMBER 1716030000
J4: 1716030000; J4_CONN_LM_5.080390_WED; MANUFACTURER_PART_NUMBER 1716030000
PS1: IA0305S; PS1_XP_IA0305S
PS2: IA0305S; PS2_XP_IA0305S
R3: 20K; R3_RC0603N_YAG; MANUFACTURER_PART_NUMBER RC0603FR-0720KL
R6: 20K; R6_RC0603N_YAG; MANUFACTURER_PART_NUMBER RC0603FR-0720KL
R11: 20K; R11_RC0603N_YAG; MANUFACTURER_PART_NUMBER RC0603FR-0720KL
R12: 20K; R12_RC0603N_YAG; MANUFACTURER_PART_NUMBER RC0603FR-0720KL
R13, R14: 10K; R_0603_1608Metric; MANUFACTURER_PART_NUMBER RC0603FR-0710KL
R15, R16: 0; R_0603_1608Metric; Tolerance Jumper; MANUFACTURER_PART_NUMBER TBD - standard 0603 zero-ohm jumper
TP1: +ISO_P5V; TP1_KEYSTONE_5016
TP2: -ISO_N5V; TP2_KEYSTONE_5016
TP3: ISO_GND_ISOW; TP3_KEYSTONE_5016
TP6: Bi_PolarOut; TP6_KEYSTONE_5016
TP7: VREF_BUF_TP; TP7_KEYSTONE_5016
TP8: TP_SYS_3V3; TP8_KEYSTONE_5016
TP9: TP_ISO_3V3_CLEAN; TP9_KEYSTONE_5016
TP10: TP_ISO_3V3_RAW; TP10_KEYSTONE_5016
TP11: TP_ISO_3V3_CLEAN_2; TP11_KEYSTONE_5016
TP12: TP_ISO_3V3_RAW_2; TP12_KEYSTONE_5016
TP13: +ISO_P5V_2; TP13_KEYSTONE_5016
TP14: -ISO_N5V_2; TP14_KEYSTONE_5016
TP15: ISO_GND_ISOW_2; TP15_KEYSTONE_5016
TP16: Bi_PolarOut_2; TP16_KEYSTONE_5016
TP17: VREF_BUF_TP_2; TP17_KEYSTONE_5016
U1: ISOW7741DFM; U1_SOIC20_DFM_TEX; MANUFACTURER_PART_NUMBER ISOW7741DFM
U3, U5: DAC8830IBD; SOIC-8_3.9x4.9mm_P1.27mm
U4: OPA2192IDGKR; U4_DGK0008A_N_TEX; MANUFACTURER_PART_NUMBER OPA2192IDGKR
U6: ISOW7741DFM; U6_SOIC20_DFM_TEX; MANUFACTURER_PART_NUMBER ISOW7741DFM
U7: OPA2192IDGKR; U7_DGK0008A_N_TEX; MANUFACTURER_PART_NUMBER OPA2192IDGKR

Connections:
/BIPOLAR_OUT: J3.1, R6.1, TP6.TP (TP_TP), U4.7 (OUT)
/BIPOLAR_OUT_2: J4.1, R12.1, TP16.TP (TP_TP), U7.7 (OUT)
/CS_ISO: U1.17 (OUTC), U3.4 (CS_N)
/CS_ISO_2: U5.4 (CS_N), U6.17 (OUTC)
/DAC_OUT_UNIPOLAR: U3.1 (VOUT), U4.5 (IN+)
/DAC_OUT_UNIPOLAR_2: U5.1 (VOUT), U7.5 (IN+)
/FAULT_TO_PICO: J1.07, R13.2, U1.8 (EN_FLT)
/FAULT_TO_PICO_2: J2.07, R14.2, U6.8 (EN_FLT)
/IN-_B: R3.2, R6.2, U4.6 (IN-)
/IN-_B_2: R11.2, R12.2, U7.6 (IN-)
/ISO_3V3_CLEAN: C9.2, C10.2, C21.2, J3.2, R15.2, TP9.TP (TP_TP), U3.3 (VREF), U3.8 (VDD), U4.3 (IN+)
/ISO_3V3_CLEAN_2: C22.2, C23.2, C38.2, J4.2, R16.2, TP11.TP (TP_TP), U5.3 (VREF), U5.8 (VDD), U7.3 (IN+)
/ISO_3V3_RAW: C5.1, C6.2, C8.2, C41.1, C42.1, R15.1, TP10.TP (TP_TP), U1.12 (VISOOUT), U1.14 (EN_IO2), U1.20 (VISOIN)
/ISO_3V3_RAW_2: C25.1, C26.2, C36.2, C44.1, C45.1, R16.1, TP12.TP (TP_TP), U6.12 (VISOOUT), U6.14 (EN_IO2), U6.20 (VISOIN)
/ISO_GND_ISOW: C5.2, C6.1, C8.1, C9.1, C10.1, C12.1, C13.1, C14.1, C15.1, C17.2, C18.1, C19.2, C20.1, C21.1, C41.2, C42.2, J3.3, PS1.5 (0), TP3.TP (TP_TP), U1.11 (GND2), U1.13 (VSEL), U1.15 (GISOIN), U3.2 (AGND), U3.7 (DGND)
/ISO_GND_ISOW_2: C22.1, C23.1, C25.2, C26.1, C28.1, C29.1, C30.1, C31.1, C33.1, C34.2, C35.2, C36.1, C37.1, C38.1, C44.2, C45.2, J4.3, PS2.5 (0), TP15.TP (TP_TP), U5.2 (AGND), U5.7 (DGND), U6.11 (GND2), U6.13 (VSEL), U6.15 (GISOIN)
/ISO_N5V: C13.2, C14.2, C18.2, C20.2, PS1.4 (-VOUT), TP2.TP (TP_TP), U4.4 (V-)
/ISO_N5V_2: C28.2, C31.2, C33.2, C37.2, PS2.4 (-VOUT), TP14.TP (TP_TP), U7.4 (V-)
/ISO_P5V: C12.2, C15.2, C17.1, C19.1, PS1.6 (+VOUT), TP1.TP (TP_TP), U4.8 (V+)
/ISO_P5V_2: C29.2, C30.2, C34.1, C35.1, PS2.6 (+VOUT), TP13.TP (TP_TP), U7.8 (V+)
/MOSI_ISO: U1.18 (OUTB), U3.6 (SDI)
/MOSI_ISO_2: U5.6 (SDI), U6.18 (OUTB)
/SCLK_ISO: U1.19 (OUTA), U3.5 (SCLK)
/SCLK_ISO_2: U5.5 (SCLK), U6.19 (OUTA)
/SPI_CS_SYS: J1.06, U1.4 (INC)
/SPI_CS_SYS_2: J2.06, U6.4 (INC)
/SPI_MOSI_SYS: J1.05, J2.05, U1.3 (INB), U6.3 (INB)
/SPI_SCLK_SYS: J1.04, J2.04, U1.2 (INA), U6.2 (INA)
/SYS_3V3: C1.1, C2.1, C3.2, C4.2, C24.2, C27.2, C39.1, C40.1, C43.1, C46.1, J1.02, J2.02, PS1.1 (+VIN), PS2.1 (+VIN), R13.1, R14.1, TP8.TP (TP_TP), U1.1 (VIO), U1.7 (EN_IO1), U1.9 (VDD), U6.1 (VIO), U6.7 (EN_IO1), U6.9 (VDD)
/SYS_GND: C1.2, C2.2, C3.1, C4.1, C24.1, C27.1, C39.2, C40.2, C43.2, C46.2, J1.03, J2.03, PS1.2 (-VIN), PS2.2 (-VIN), U1.6 (GNDIO), U1.10 (GND1), U6.6 (GNDIO), U6.10 (GND1)
/VBUS_5V: J1.01
/VBUS_5V_2: J2.01
/VREF_BUF: R3.1, TP7.TP (TP_TP), U4.1 (OUT), U4.2 (IN-)
/VREF_BUF_2: R11.1, TP17.TP (TP_TP), U7.1 (OUT), U7.2 (IN-)

Notes on the sheet:
SIGNAL GENERATOR - ELECTRICAL DRAFT / UNVALIDATED
NOT FOR FABRICATION. Original input and ordered Howland board were not changed.
Resolved: high-impedance DAC input, equal gain resistors, full-reference buffer, EN/FLT pull-ups, added local decoupling, SOIC-8 DAC footprint.
DRAFT-B: U2/U8 removed; R15/R16 link regulated RAW to the DAC supply/reference. No LDO dropout; VSEL remains grounded.
No hardware output mute or 5 mA limit is implemented here. Validate the ordered Howland interface before energizing outputs.
New local components - channel 1
New local components - channel 2
U4/U7 transfer: VOUT = 2*VDAC - VREF (nominal). Code 0 = -VREF; 32768 = 0; 65535 approx +VREF. Firmware code polarity is reversed. Power-up code 0 gives nonzero output. Keep output inhibited until rails are valid and midscale is loaded. Hardware mute is unresolved. VREF follows RAW: 3.135 to 3.465 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
R3 = R6 and R11 = R12 = 20k nominal. Source 1% parts retained; validate ratio accuracy. Added 22uF bulk needs >=10uF effective at bias. Added 10nF: 50 V, 0402; place at VDD/VISOOUT. New capacitor MPNs remain TBD; draft specs only.
Channels retain separate isolated grounds. J1/J2 pin 7 reports ISOW EN/FLT through a 10k pull-up; MCU input must not fight an asserted fault.
J3/J4: 1 = bipolar signal, 2 = direct regulated RAW via 0-ohm link (legacy CLEAN name), 3 = isolated ground.
IA0305S rails: verify light-load/startup voltage and amplifier output swing. No arbitrary preload or clamp added. Bench use only.

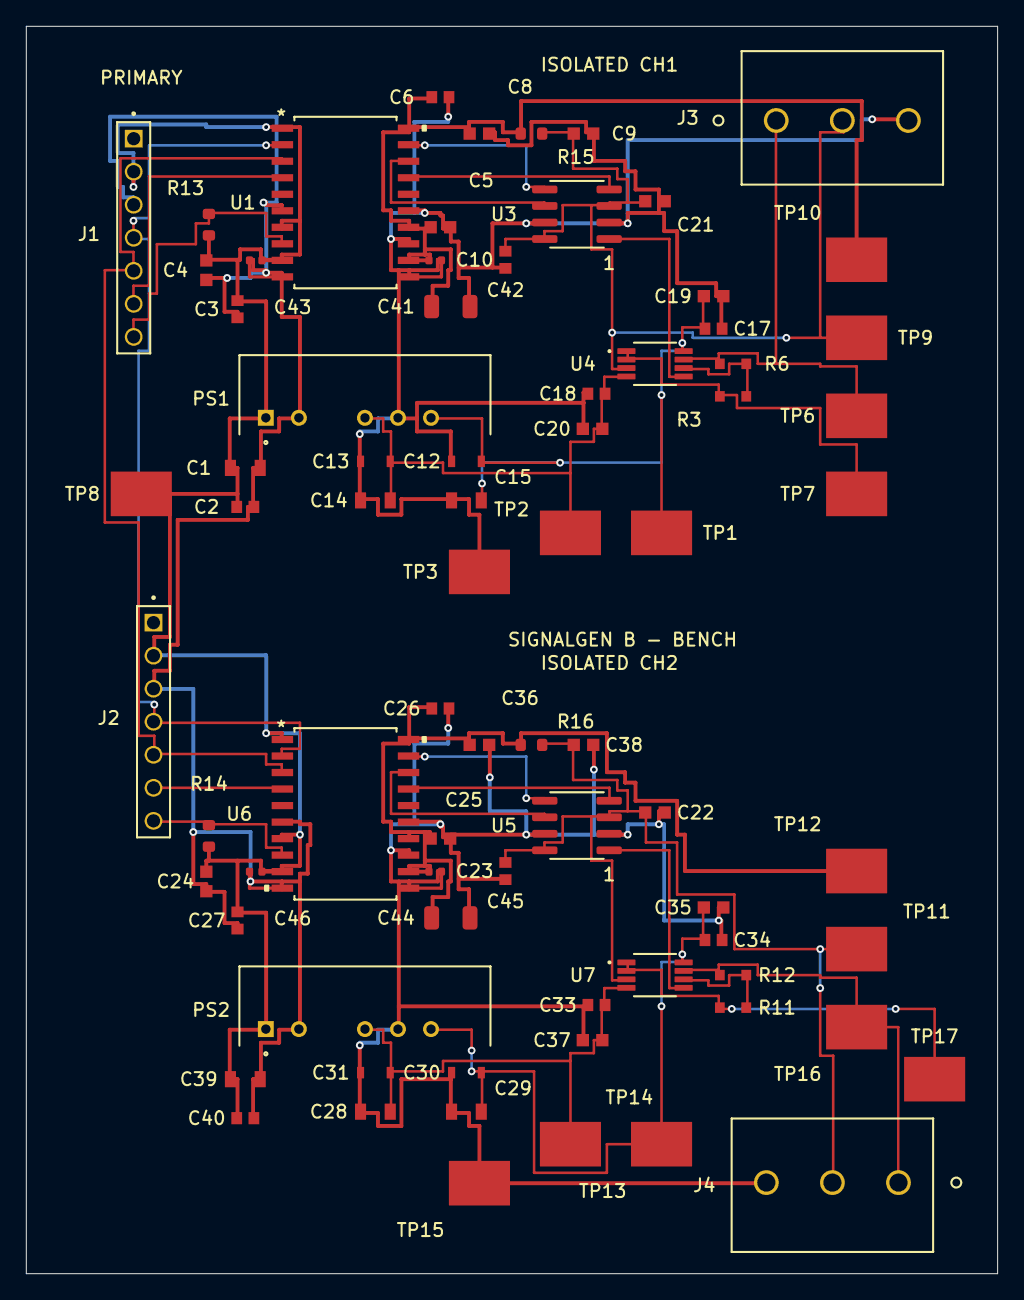
[picture p56: board SignalGen_Electrical_Draft.kicad_pcb from above]

Board: 2 copper layers, 74.7 x 95.9 mm, 77 parts (0 on the bottom side), 32 nets.
