AnishLanka/BrainStimulation/AmplifierCircuit_MYCHANGES.kicad_sch

## KiCad design AmplifierCircuit_MYCHANGES.kicad_sch (2026-10-17)

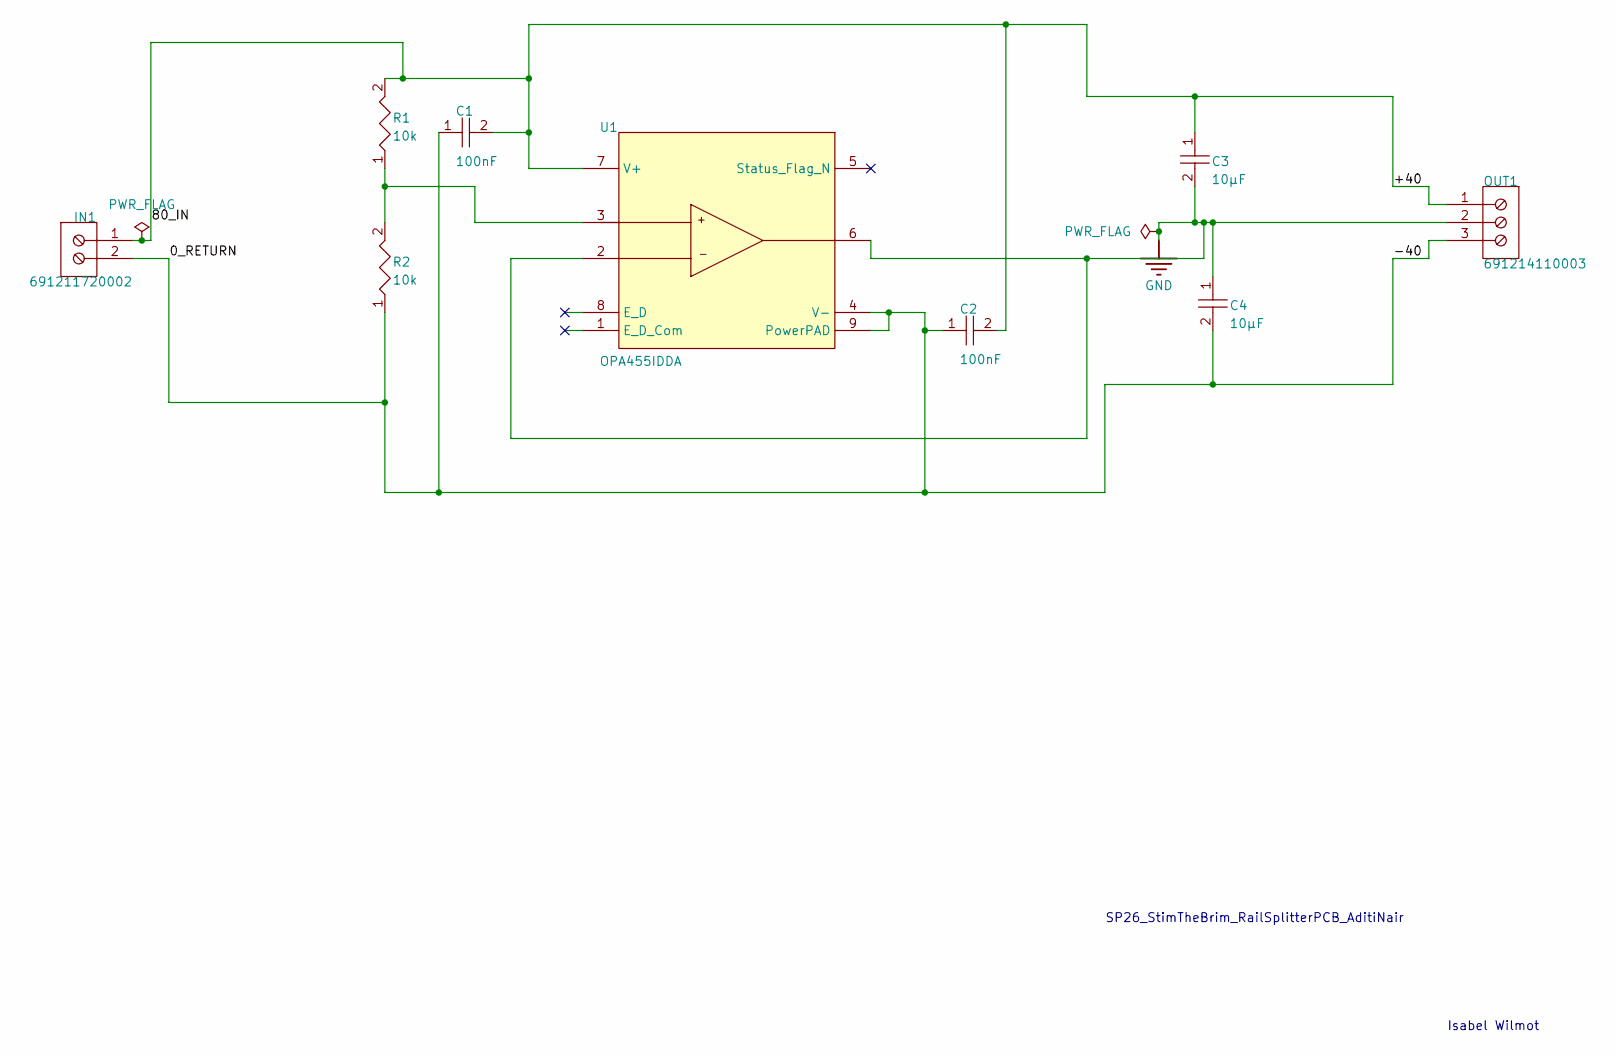
[picture p57: schematic AmplifierCircuit_MYCHANGES.kicad_sch]

Parts:
C1, C2: Capacitor 100nF +/-20% 10V 0402; CAPC0402(1005)60_L; VOLTAGE RATING 10V; TOLERANCE 20%
C3, C4: Capacitor 10µF +/-20% 10V 0603; CAPC0603(1608)100_L; VOLTAGE RATING 10V; TOLERANCE 10%
IN1: 691211720002; VOLTAGE 300V
OUT1: 691214110003; CURRENT RATING 10A; VOLTAGE RATING 300V
R1, R2: Resistor 10k +/-1% 0402 100 mW; RESC1005X40X25ML05T05; TOLERANCE 1%; VOLTAGE RATING 50V
U1: OPA455IDDA; DDA0008J-IPC_A; MANUFACTURER_PART_NUMBER OPA455IDDA

Connections:
+40: C1.2, C2.2, C3.1, IN1.1, OUT1.1, R1.2, U1.7 (V+)
-40: C1.1, C2.1, C4.2, IN1.2, OUT1.3, R2.1, U1.4 (V-), U1.9 (PowerPAD)
GND: C3.2, C4.1, OUT1.2, U1.2 (-IN), U1.6 (OUT)
unnamed: R1.1, R2.2, U1.3 (+IN)

Notes on the sheet:
SP26_StimTheBrim_RailSplitterPCB_AditiNair
Isabel Wilmot
